xvrxvr/fpga-osc/interface.gen/sources_1/ip/axi4stream_vip_0/doc/axi4stream_vip_v1_1_changelog.txt

2023.2.2:
 * Version 1.1 (Rev. 16)
 * No changes

2023.2.1:
 * Version 1.1 (Rev. 16)
 * Revision change in one or more subcores

2023.2:
 * Version 1.1 (Rev. 15)
 * General: Updating AMD copyright
 * Revision change in one or more subcores

2023.1.2:
 * Version 1.1 (Rev. 14)
 * No changes

2023.1.1:
 * Version 1.1 (Rev. 14)
 * No changes

2023.1:
 * Version 1.1 (Rev. 14)
 * Revision change in one or more subcores

2022.2.2:
 * Version 1.1 (Rev. 13)
 * No changes

2022.2.1:
 * Version 1.1 (Rev. 13)
 * No changes

2022.2:
 * Version 1.1 (Rev. 13)
 * General: Diff_xml_file bug fixed
 * General: bug fixed
 * Revision change in one or more subcores

2022.1.2:
 * Version 1.1 (Rev. 12)
 * No changes

2022.1.1:
 * Version 1.1 (Rev. 12)
 * No changes

2022.1:
 * Version 1.1 (Rev. 12)
 * General: Diff_xml_file bug fixed
 * General: bug fixed
 * Revision change in one or more subcores

2021.2.2:
 * Version 1.1 (Rev. 11)
 * No changes

2021.2.1:
 * Version 1.1 (Rev. 11)
 * No changes

2021.2:
 * Version 1.1 (Rev. 11)
 * Revision change in one or more subcores

2021.1.1:
 * Version 1.1 (Rev. 10)
 * No changes

2021.1:
 * Version 1.1 (Rev. 10)
 * Revision change in one or more subcores

2020.3:
 * Version 1.1 (Rev. 9)
 * Revision change in one or more subcores

2020.2.2:
 * Version 1.1 (Rev. 8)
 * No changes

2020.2.1:
 * Version 1.1 (Rev. 8)
 * No changes

2020.2:
 * Version 1.1 (Rev. 8)
 * Revision change in one or more subcores

2020.1.1:
 * Version 1.1 (Rev. 7)
 * No changes

2020.1:
 * Version 1.1 (Rev. 7)
 * Revision change in one or more subcores

2019.2.2:
 * Version 1.1 (Rev. 6)
 * No changes

2019.2.1:
 * Version 1.1 (Rev. 6)
 * No changes

2019.2:
 * Version 1.1 (Rev. 6)
 * Revision change in one or more subcores

2019.1.3:
 * Version 1.1 (Rev. 5)
 * No changes

2019.1.2:
 * Version 1.1 (Rev. 5)
 * No changes

2019.1.1:
 * Version 1.1 (Rev. 5)
 * No changes

2019.1:
 * Version 1.1 (Rev. 5)
 * General: update to honor user parameters user strength in slave mode
 * Revision change in one or more subcores

2018.3.1:
 * Version 1.1 (Rev. 4)
 * No changes

2018.3:
 * Version 1.1 (Rev. 4)
 * General: update arm axi4s protocol checker for xsim
 * Revision change in one or more subcores

2018.2:
 * Version 1.1 (Rev. 3)
 * General: modify instance pkg generation so there is no mismatch between interface and virtual interface
 * Revision change in one or more subcores

2018.1:
 * Version 1.1 (Rev. 2)
 * General: update example testbench, update interface checker for tkeep
 * Revision change in one or more subcores

2017.4:
 * Version 1.1 (Rev. 1)
 * General: update interface assertion
 * Revision change in one or more subcores

2017.3:
 * Version 1.1
 * versionless of package, interface and PC
 * Revision change in one or more subcores

2017.2:
 * Version 1.0 (Rev. 1)
 * Sub core IP clk_wiz version changed to 5.4
 * production release
 * Revision change in one or more subcores

2017.1:
 * Version 1.0
 * Initial Release

(c) Copyright 2017 - 2024 Advanced Micro Devices, Inc. All rights reserved.

This file contains confidential and proprietary information
of AMD and is protected under U.S. and international copyright
and other intellectual property laws.

DISCLAIMER
This disclaimer is not a license and does not grant any
rights to the materials distributed herewith. Except as
otherwise provided in a valid license issued to you by
AMD, and to the maximum extent permitted by applicable
law: (1) THESE MATERIALS ARE MADE AVAILABLE "AS IS" AND
WITH ALL FAULTS, AND AMD HEREBY DISCLAIMS ALL WARRANTIES
AND CONDITIONS, EXPRESS, IMPLIED, OR STATUTORY, INCLUDING
BUT NOT LIMITED TO WARRANTIES OF MERCHANTABILITY, NON-
INFRINGEMENT, OR FITNESS FOR ANY PARTICULAR PURPOSE; and
(2) AMD shall not be liable (whether in contract or tort,
including negligence, or under any other theory of
liability) for any loss or damage of any kind or nature
related to, arising under or in connection with these
materials, including for any direct, or any indirect,
special, incidental, or consequential loss or damage
(including loss of data, profits, goodwill, or any type of
loss or damage suffered as a result of any action brought
by a third party) even if such damage or loss was
reasonably foreseeable or AMD had been advised of the
possibility of the same.

CRITICAL APPLICATIONS
AMD products are not designed or intended to be fail-
safe, or for use in any application requiring fail-safe
performance, such as life-support or safety devices or
systems, Class III medical devices, nuclear facilities,
applications related to the deployment of airbags, or any
other applications that could lead to death, personal
injury, or severe property or environmental damage
(individually and collectively, "Critical
Applications"). Customer assumes the sole risk and
liability of any use of AMD products in Critical
Applications, subject only to applicable laws and
regulations governing limitations on product liability.

THIS COPYRIGHT NOTICE AND DISCLAIMER MUST BE RETAINED AS
PART OF THIS FILE AT ALL TIMES.
