xvrxvr/fpga-osc/interface.gen/sources_1/ip/axis_interconnect_input/doc/axis_interconnect_v1_1_changelog.txt

2023.2.2:
 * Version 1.1 (Rev. 22)
 * No changes

2023.2.1:
 * Version 1.1 (Rev. 22)
 * No changes

2023.2:
 * Version 1.1 (Rev. 22)
 * General: Rebrand to AMD copyright information
 * Revision change in one or more subcores

2023.1.2:
 * Version 1.1 (Rev. 21)
 * No changes

2023.1.1:
 * Version 1.1 (Rev. 21)
 * No changes

2023.1:
 * Version 1.1 (Rev. 21)
 * Revision change in one or more subcores

2022.2.2:
 * Version 1.1 (Rev. 20)
 * No changes

2022.2.1:
 * Version 1.1 (Rev. 20)
 * No changes

2022.2:
 * Version 1.1 (Rev. 20)
 * No changes

2022.1.2:
 * Version 1.1 (Rev. 20)
 * No changes

2022.1.1:
 * Version 1.1 (Rev. 20)
 * No changes

2022.1:
 * Version 1.1 (Rev. 20)
 * Revision change in one or more subcores

2021.2.2:
 * Version 1.1 (Rev. 19)
 * No changes

2021.2.1:
 * Version 1.1 (Rev. 19)
 * No changes

2021.2:
 * Version 1.1 (Rev. 19)
 * Revision change in one or more subcores

2021.1.1:
 * Version 1.1 (Rev. 18)
 * No changes

2021.1:
 * Version 1.1 (Rev. 18)
 * No changes

2020.3:
 * Version 1.1 (Rev. 18)
 * No changes

2020.2.2:
 * Version 1.1 (Rev. 18)
 * No changes

2020.2.1:
 * Version 1.1 (Rev. 18)
 * No changes

2020.2:
 * Version 1.1 (Rev. 18)
 * No changes

2020.1.1:
 * Version 1.1 (Rev. 18)
 * No changes

2020.1:
 * Version 1.1 (Rev. 18)
 * No changes

2019.2.2:
 * Version 1.1 (Rev. 18)
 * No changes

2019.2.1:
 * Version 1.1 (Rev. 18)
 * No changes

2019.2:
 * Version 1.1 (Rev. 18)
 * Revision change in one or more subcores

2019.1.3:
 * Version 1.1 (Rev. 17)
 * No changes

2019.1.2:
 * Version 1.1 (Rev. 17)
 * No changes

2019.1.1:
 * Version 1.1 (Rev. 17)
 * No changes

2019.1:
 * Version 1.1 (Rev. 17)
 * General: remove support for versal
 * Revision change in one or more subcores

2018.3.1:
 * Version 1.1 (Rev. 16)
 * No changes

2018.3:
 * Version 1.1 (Rev. 16)
 * Revision change in one or more subcores

2018.2:
 * Version 1.1 (Rev. 15)
 * No changes

2018.1:
 * Version 1.1 (Rev. 15)
 * General: Updated to FIFO Generator v13.2.
 * Revision change in one or more subcores

2017.4:
 * Version 1.1 (Rev. 14)
 * No changes

2017.3:
 * Version 1.1 (Rev. 14)
 * No changes

2017.2:
 * Version 1.1 (Rev. 14)
 * No changes

2017.1:
 * Version 1.1 (Rev. 14)
 * Packaging updated. No user visible changes.
 * Revision change in one or more subcores

2016.4:
 * Version 1.1 (Rev. 13)
 * Revision change in one or more subcores

2016.3:
 * Version 1.1 (Rev. 12)
 * Source HDL files are concatenated into a single file to speed up synthesis and simulation. No changes required by the user
 * Revision change in one or more subcores

2016.2:
 * Version 1.1 (Rev. 11)
 * Revision change in one or more subcores

2016.1:
 * Version 1.1 (Rev. 10)
 * Changes to HDL library management to support Vivado IP simulation library

2015.4.2:
 * Version 1.1 (Rev. 9)
 * No changes

2015.4.1:
 * Version 1.1 (Rev. 9)
 * No changes

2015.4:
 * Version 1.1 (Rev. 9)
 * Revision change in one or more subcores

2015.3:
 * Version 1.1 (Rev. 8)
 * Update to use FIFO Generator v13.0
 * IP revision number added to HDL module, library, and include file names, to support designs with both locked and upgraded IP instances

2015.2.1:
 * Version 1.1 (Rev. 7)
 * No changes

2015.2:
 * Version 1.1 (Rev. 7)
 * Change in display name to distinguish between RTL and IPI versions,no functional changes

2015.1:
 * Version 1.1 (Rev. 6)
 * The support status for Kintex UltraScale is changed from Pre-Production to Production.

2014.4.1:
 * Version 1.1 (Rev. 5)
 * No changes

2014.4:
 * Version 1.1 (Rev. 5)
 * Architecture support updated.
 * Fixed typo in xpath expression for Mxx_SPARSE_TKEEP_REMOVED to evaluate correctly. In certain configurations, optional status port Mxx_SPARSE_TKEEP_REMOVED may be present.

2014.3:
 * Version 1.1 (Rev. 4)
 * No changes

2014.2:
 * Version 1.1 (Rev. 4)
 * Updated to utilize FIFO Generator v12.0 core.

2014.1:
 * Version 1.1 (Rev. 3)
 * Internal device family name change, no functional changes

2013.4:
 * Version 1.1 (Rev. 2)
 * No changes

2013.3:
 * Version 1.1 (Rev. 2)
 * Architecture support updated
 * GUI: Remove blank rows in columns for Slave Interface and Master Interface tables.
 * GUI: TDEST range updated to match validation.  TDEST Width minimum width must be large enough to allow access all master interfaces.
 * Updated clock synchronizers to improve Mean Time Between Failures (MTBF) for metastability. Added parameter SYNCHRONIZATION_STAGE to specify clock synchronizer stages.

2013.2:
 * Version 1.1 (Rev. 1)
 * Architecture support updated
 * Known issue: The AXI4-Stream signals shown in Table 2-7 of PG035 have the port directions reversed.
 * Constraints processing order changed

2013.1:
 * Version 1.1
 * Native Vivado Release
 * There have been no functional or interface changes to this IP.  The version number has changed to support unique versioning in Vivado starting with 2013.1.

(c) Copyright 2012 - 2024 Advanced Micro Devices, Inc. All rights reserved.

This file contains confidential and proprietary information
of AMD and is protected under U.S. and international copyright
and other intellectual property laws.

DISCLAIMER
This disclaimer is not a license and does not grant any
rights to the materials distributed herewith. Except as
otherwise provided in a valid license issued to you by
AMD, and to the maximum extent permitted by applicable
law: (1) THESE MATERIALS ARE MADE AVAILABLE "AS IS" AND
WITH ALL FAULTS, AND AMD HEREBY DISCLAIMS ALL WARRANTIES
AND CONDITIONS, EXPRESS, IMPLIED, OR STATUTORY, INCLUDING
BUT NOT LIMITED TO WARRANTIES OF MERCHANTABILITY, NON-
INFRINGEMENT, OR FITNESS FOR ANY PARTICULAR PURPOSE; and
(2) AMD shall not be liable (whether in contract or tort,
including negligence, or under any other theory of
liability) for any loss or damage of any kind or nature
related to, arising under or in connection with these
materials, including for any direct, or any indirect,
special, incidental, or consequential loss or damage
(including loss of data, profits, goodwill, or any type of
loss or damage suffered as a result of any action brought
by a third party) even if such damage or loss was
reasonably foreseeable or AMD had been advised of the
possibility of the same.

CRITICAL APPLICATIONS
AMD products are not designed or intended to be fail-
safe, or for use in any application requiring fail-safe
performance, such as life-support or safety devices or
systems, Class III medical devices, nuclear facilities,
applications related to the deployment of airbags, or any
other applications that could lead to death, personal
injury, or severe property or environmental damage
(individually and collectively, "Critical
Applications"). Customer assumes the sole risk and
liability of any use of AMD products in Critical
Applications, subject only to applicable laws and
regulations governing limitations on product liability.

THIS COPYRIGHT NOTICE AND DISCLAIMER MUST BE RETAINED AS
PART OF THIS FILE AT ALL TIMES.
