xvrxvr/fpga-osc/docs/osc.pdf

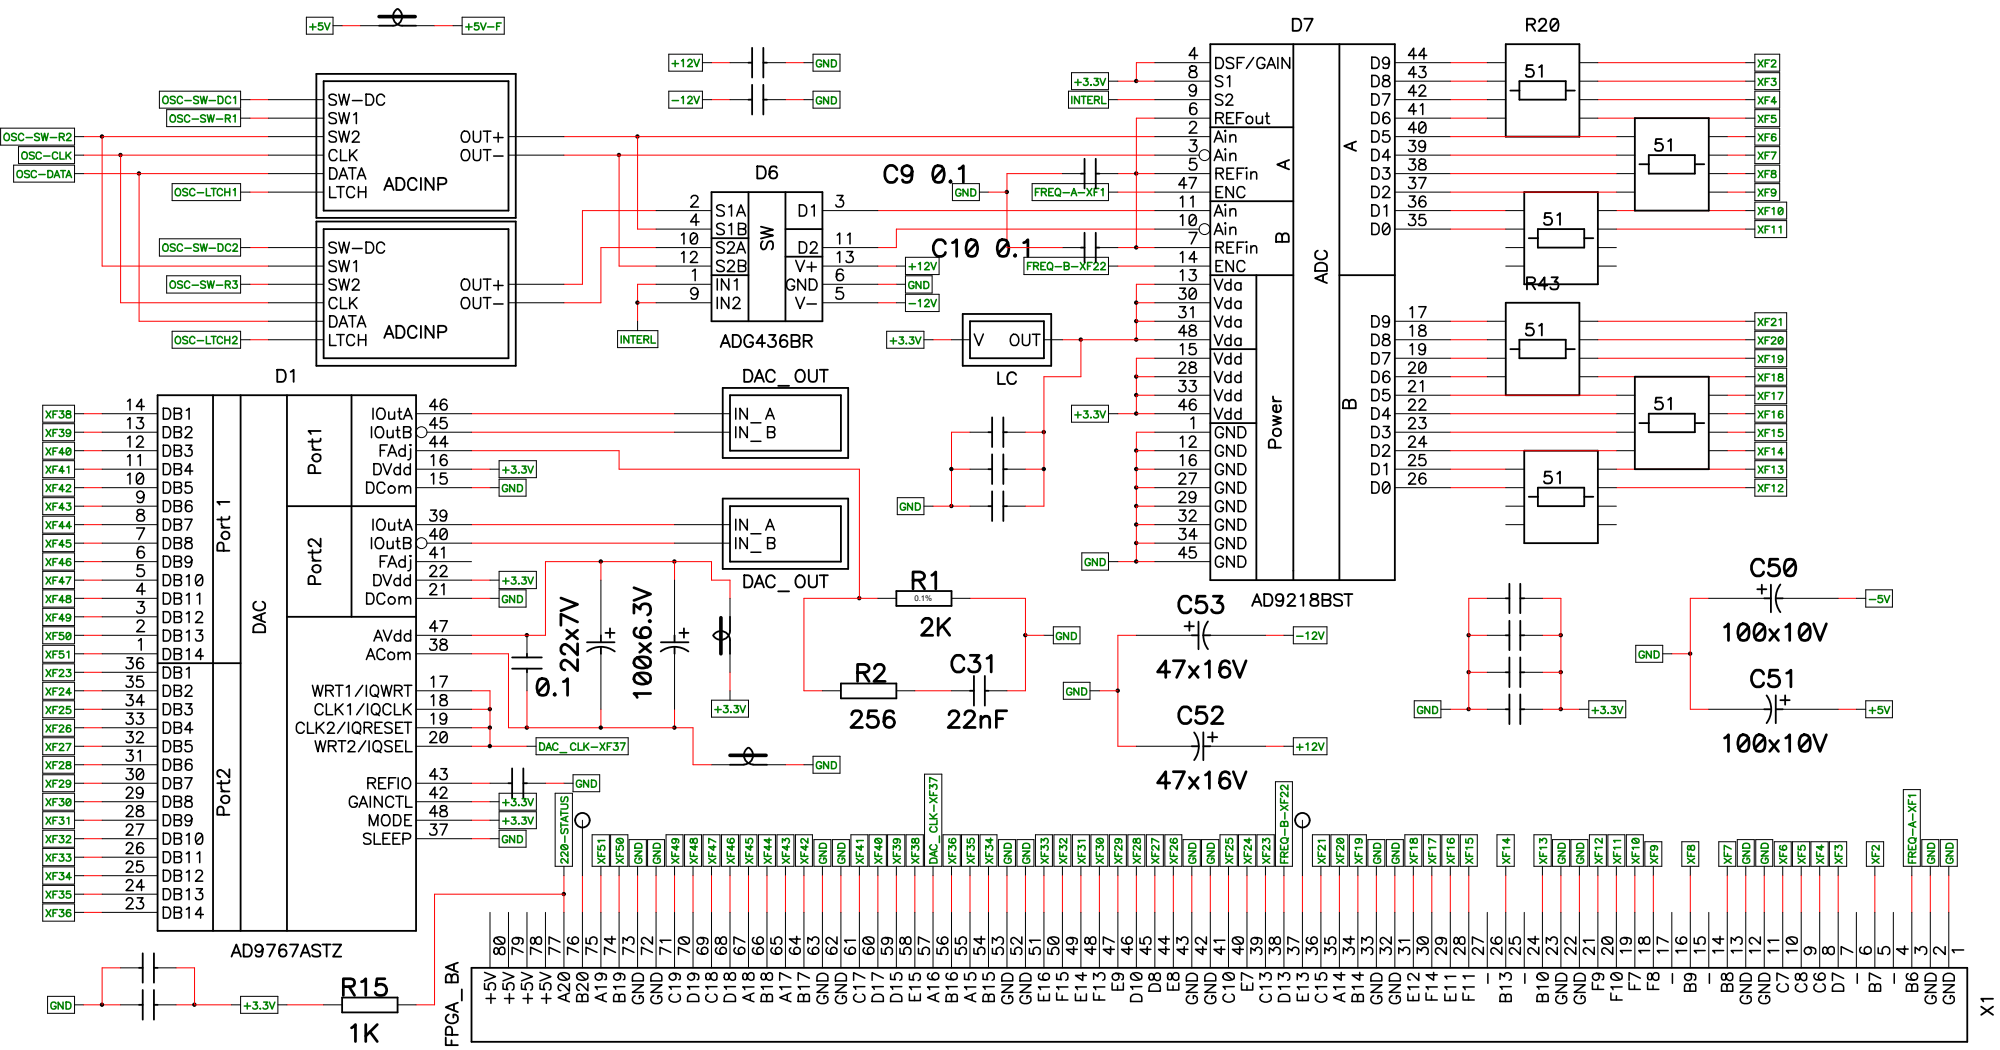
[picture p5: page 1]

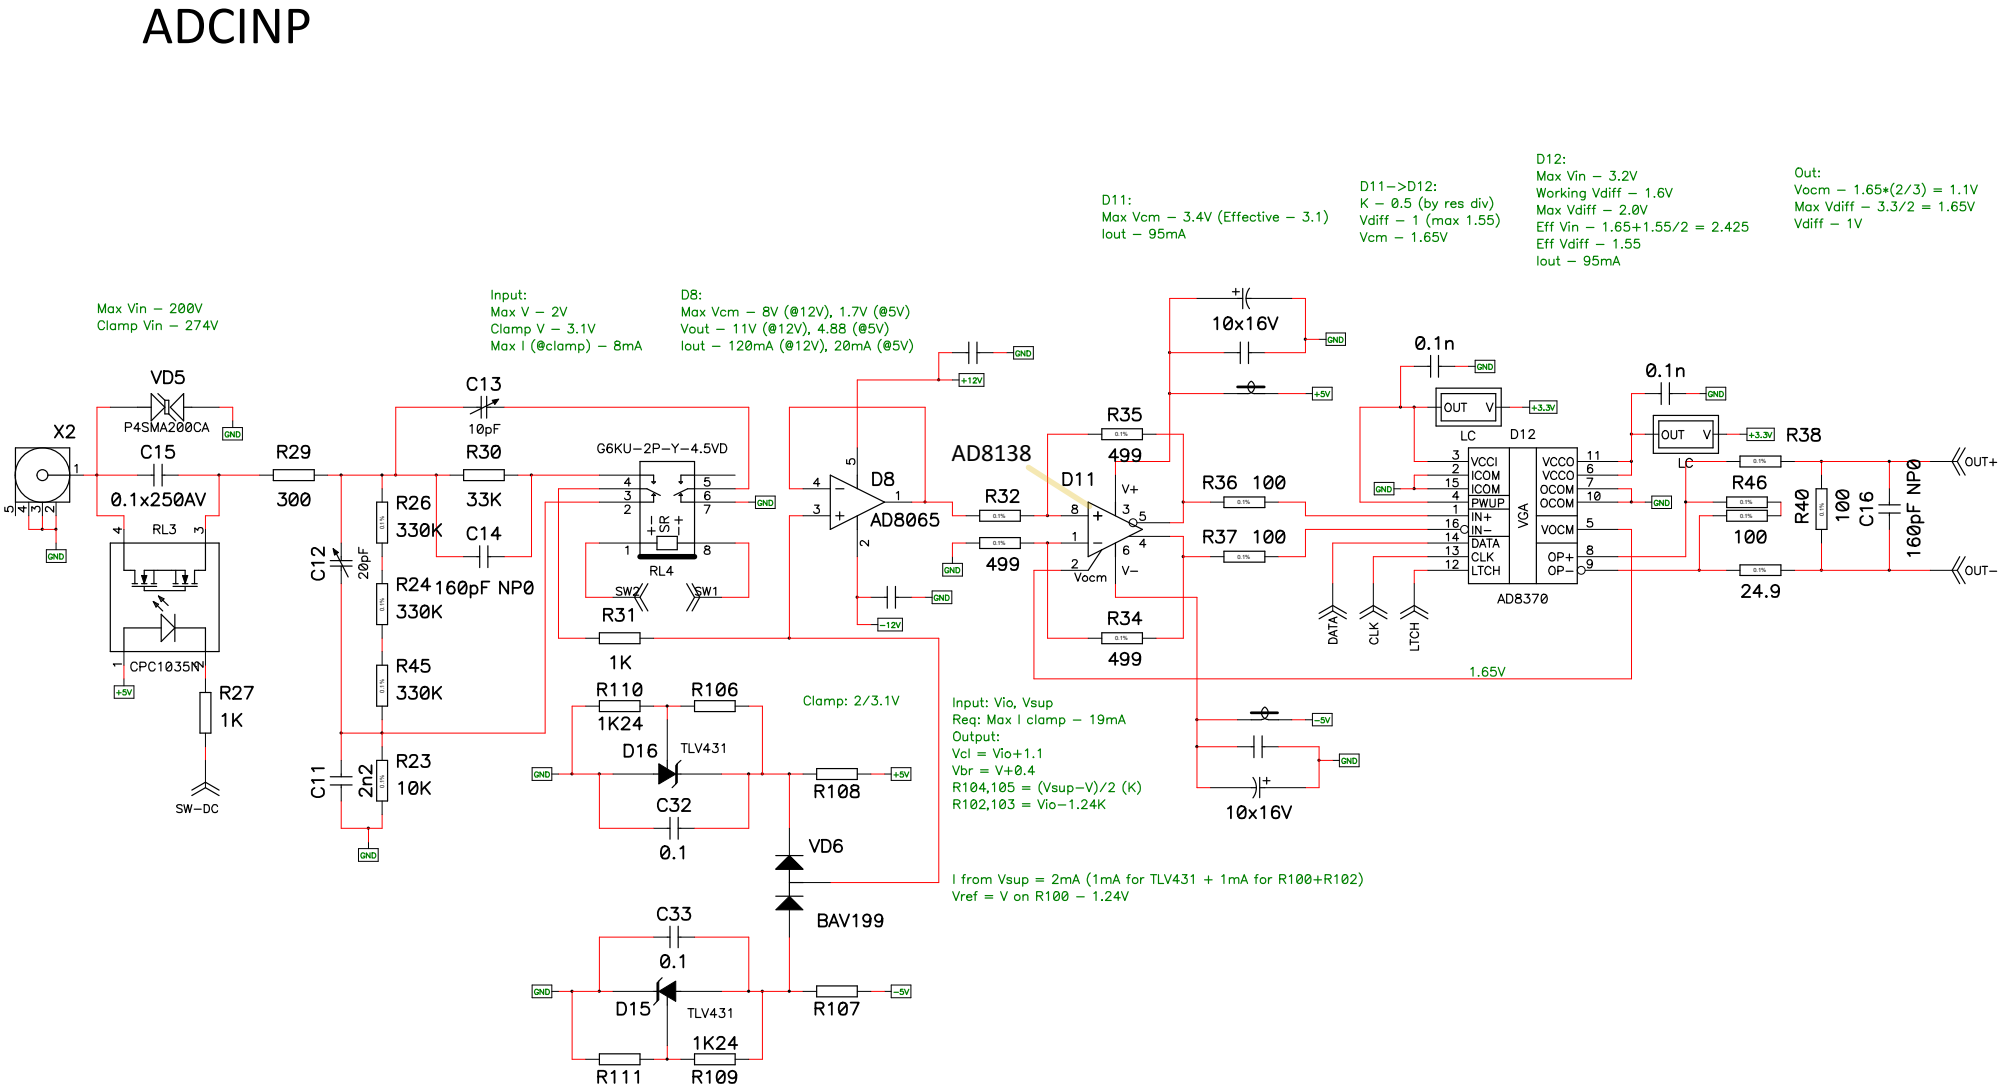
[picture p6: page 2]
ADCINP

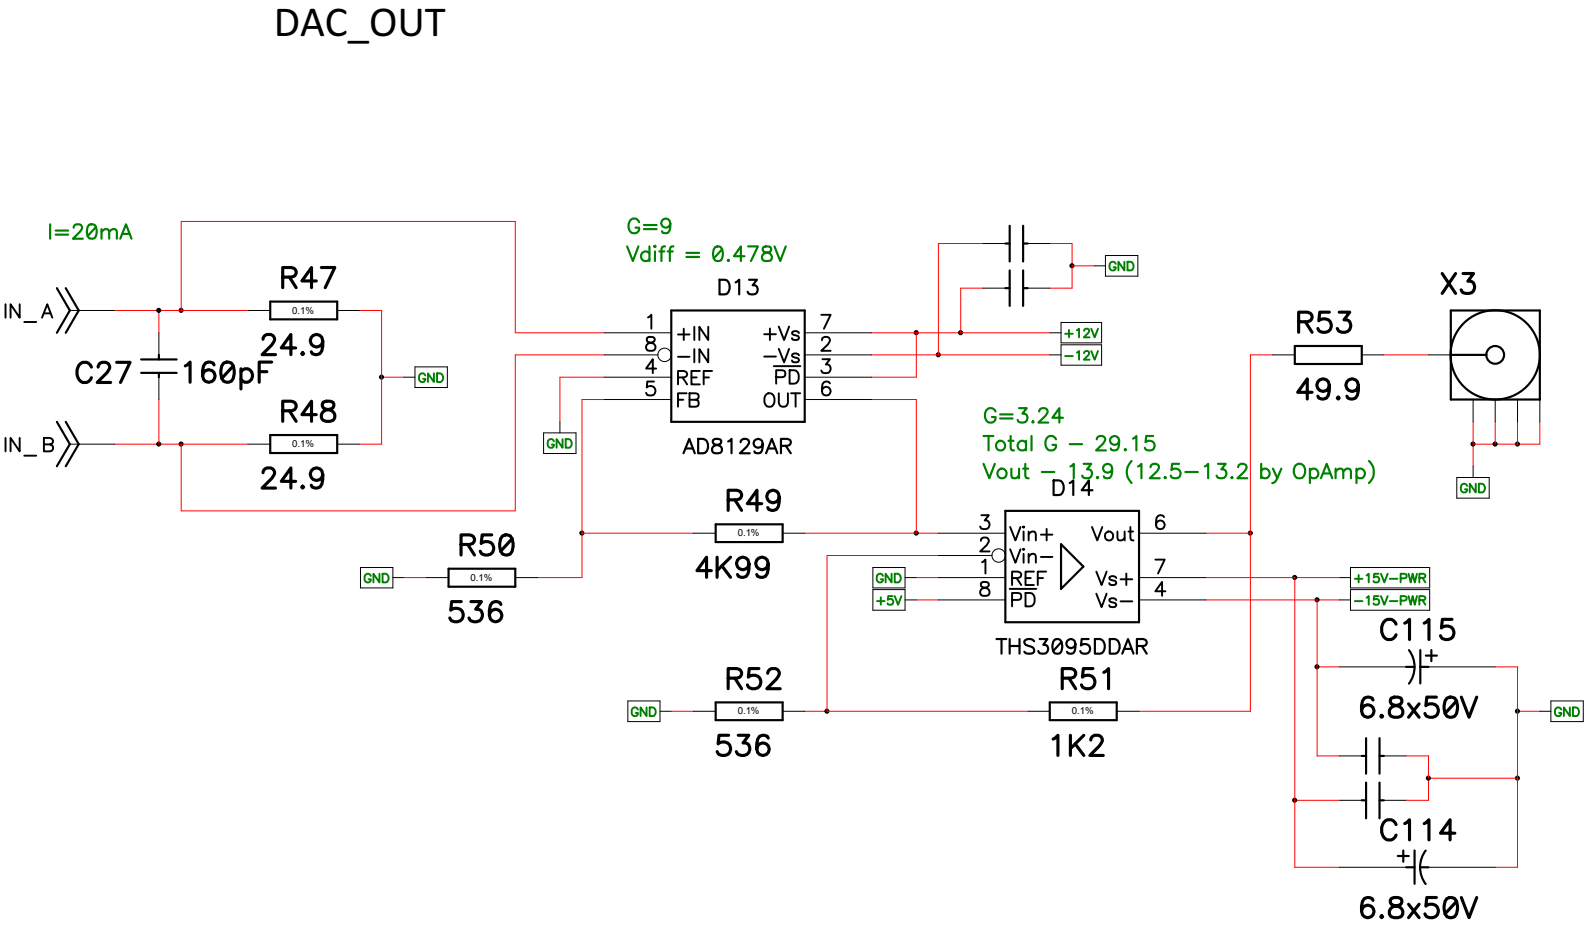
[picture p7: page 3]
DAC_OUT

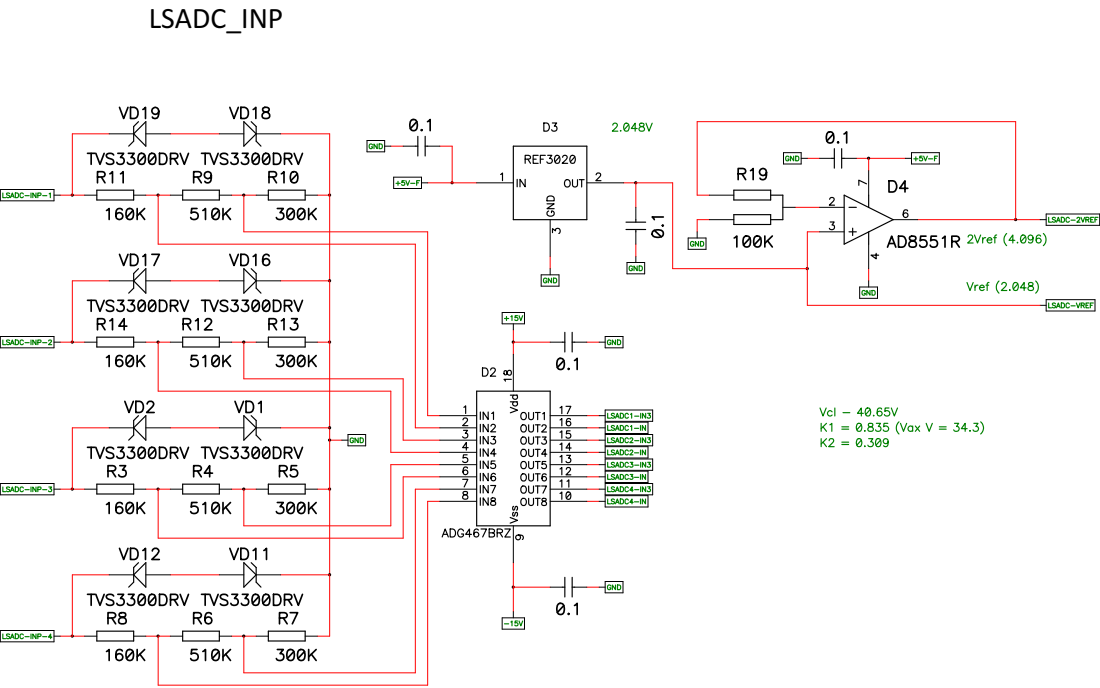
[picture p8: page 4]
LSADC_INP

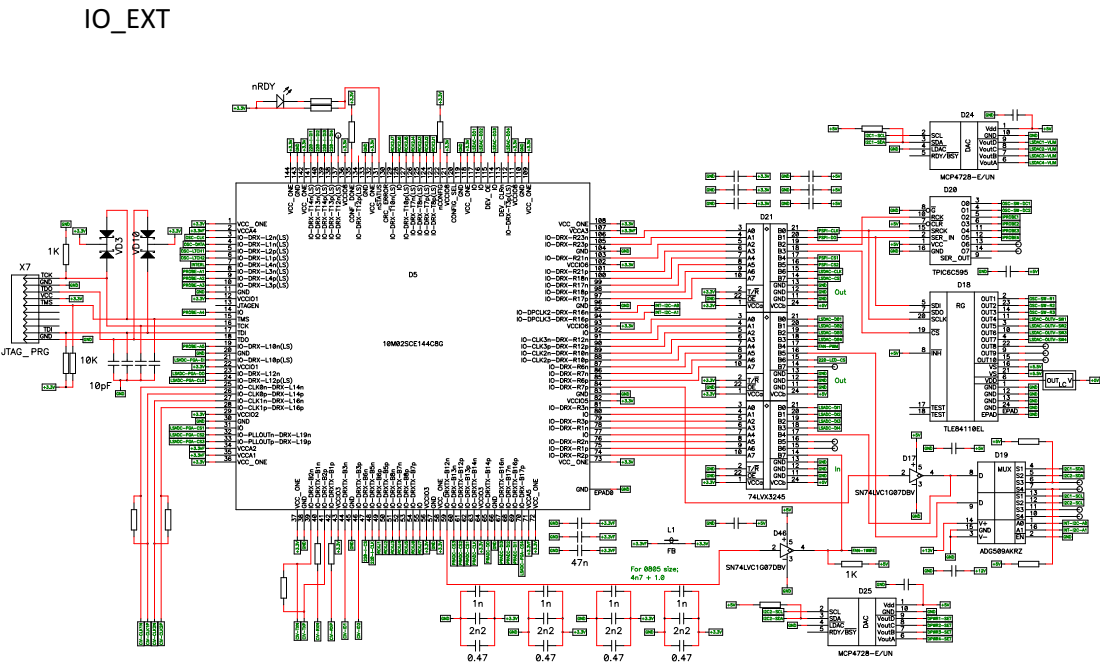
[picture p9: page 5]
IO_EXT

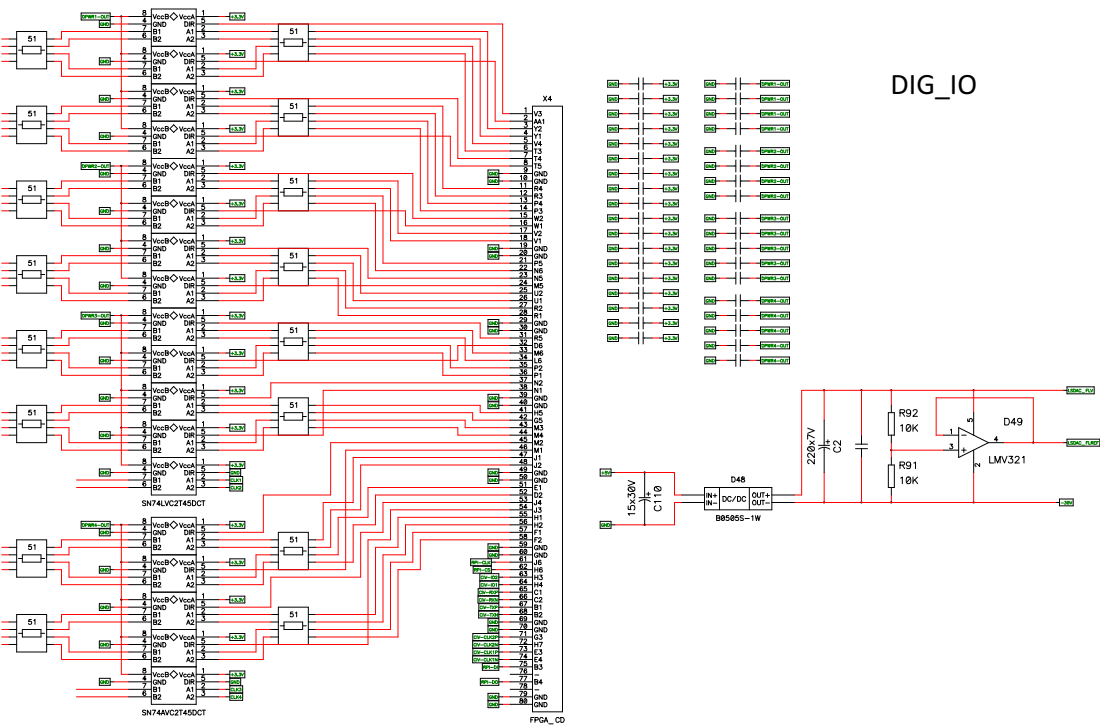
[picture p10: page 6]
DIG_IO

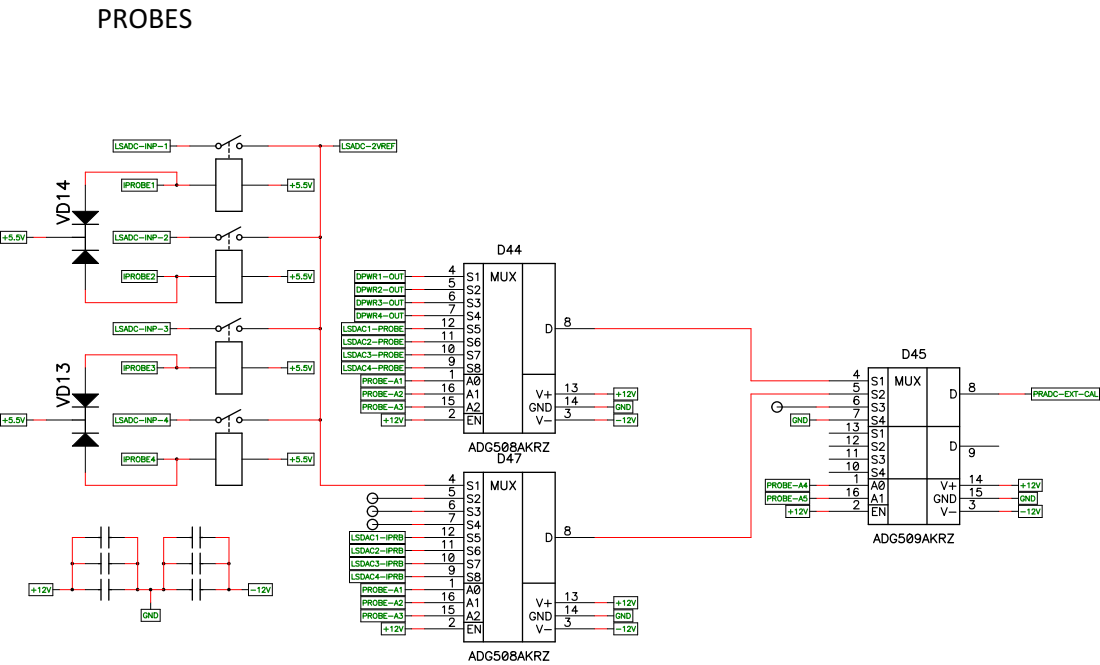
[picture p11: page 7]
PROBES

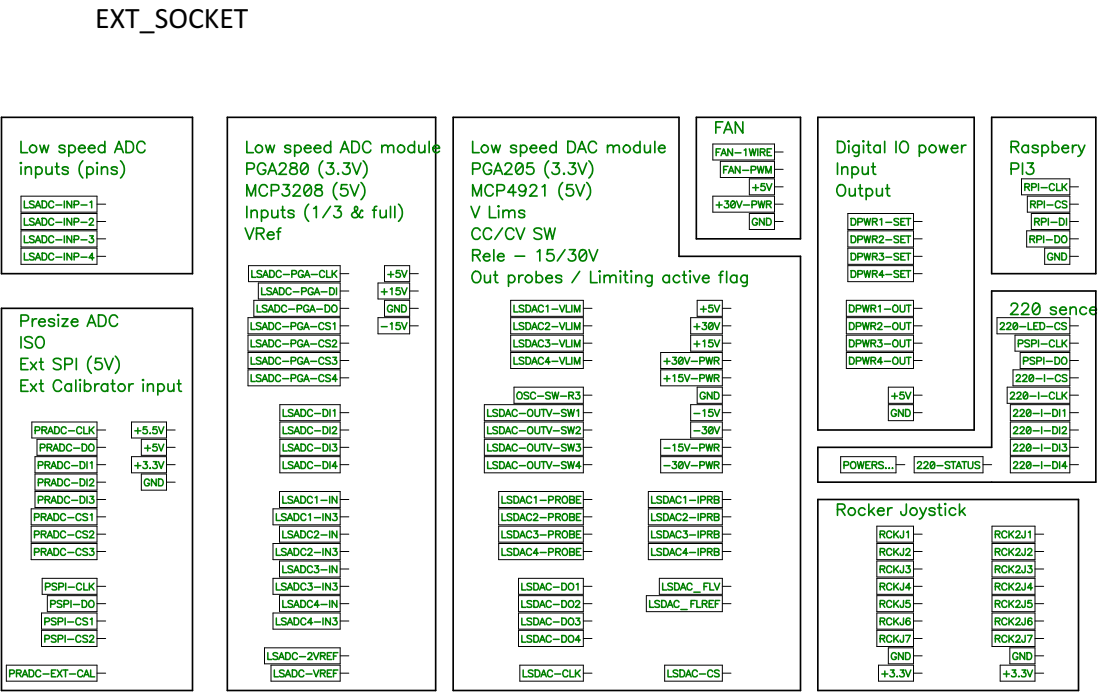
[picture p12: page 8]
EXT_SOCKET

LC

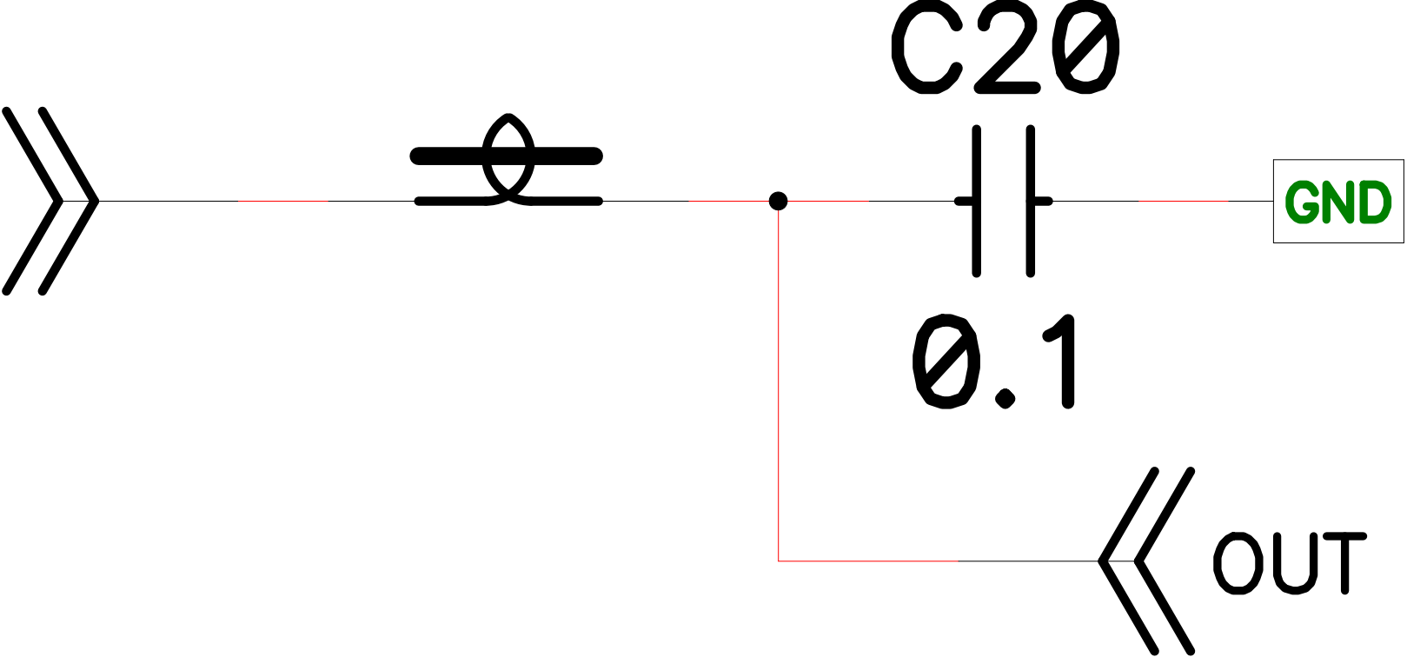
[picture p13: figure]
