xvrxvr/fpga-osc/docs/triger-doc.pdf

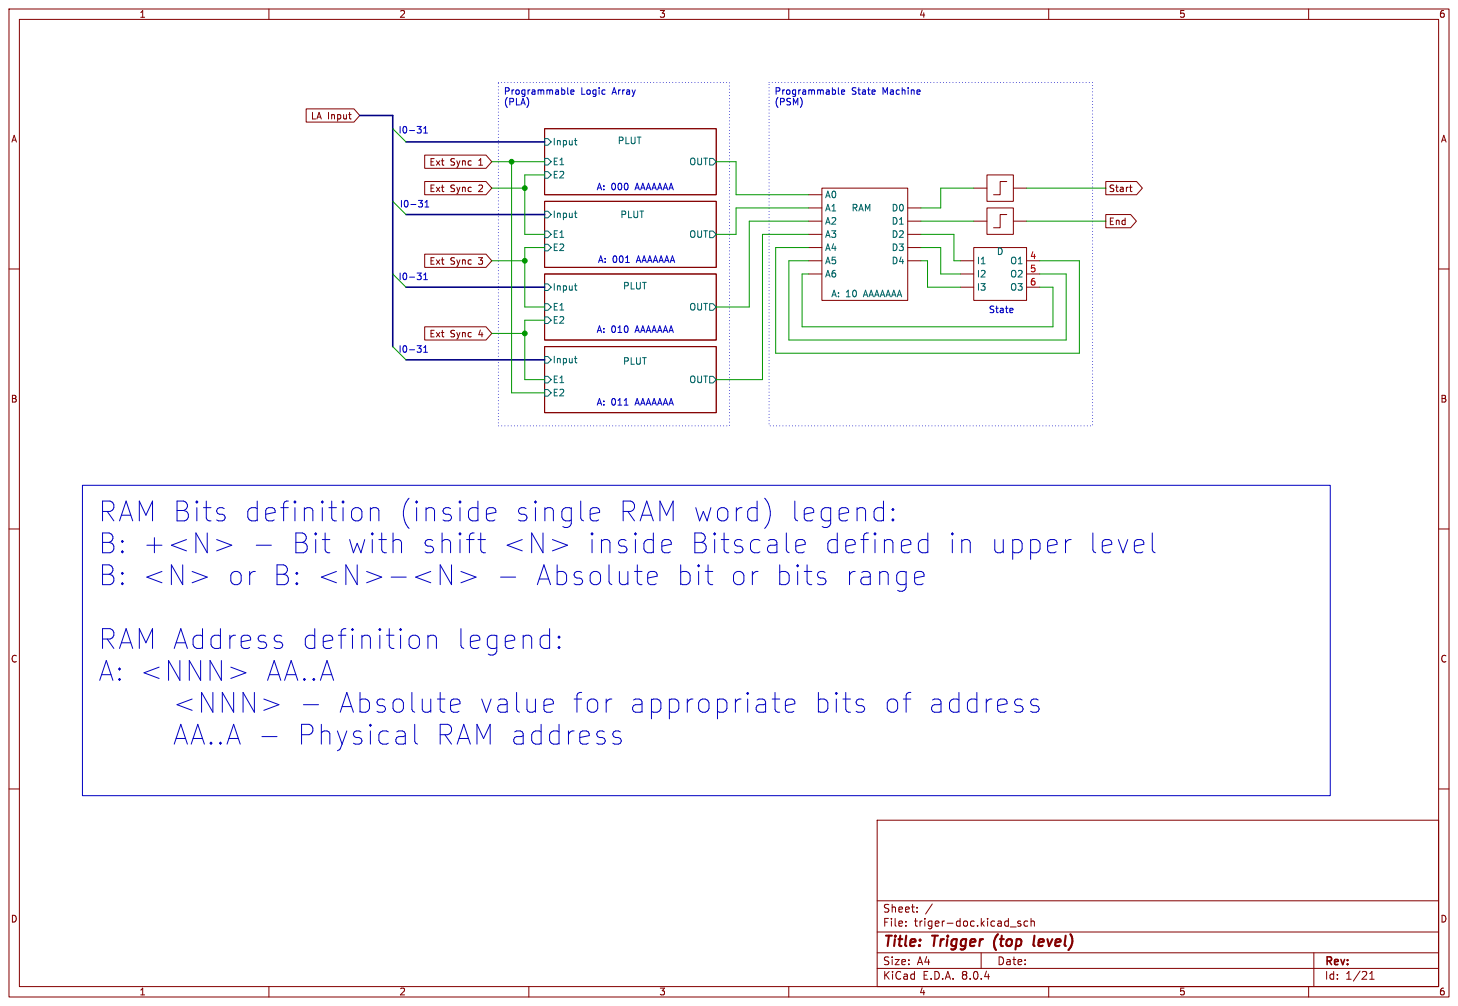
[picture p14: page 1]

Id: 1/21 Title: Trigger (top level) File: triger-doc.kicad_sch Sheet: /

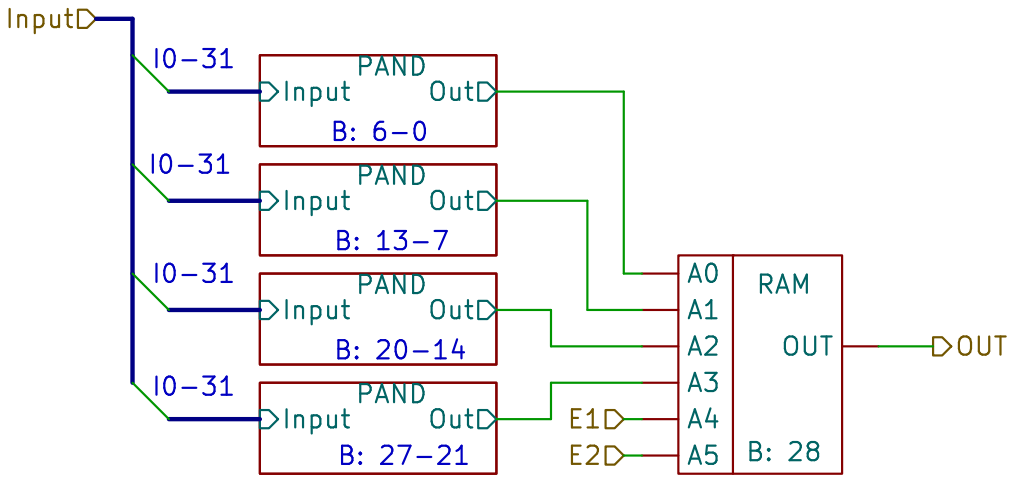
[picture p15: page 2]

File: pla.kicad_sch Sheet: /PLUT/
Id: 2/21 Title: PLUT

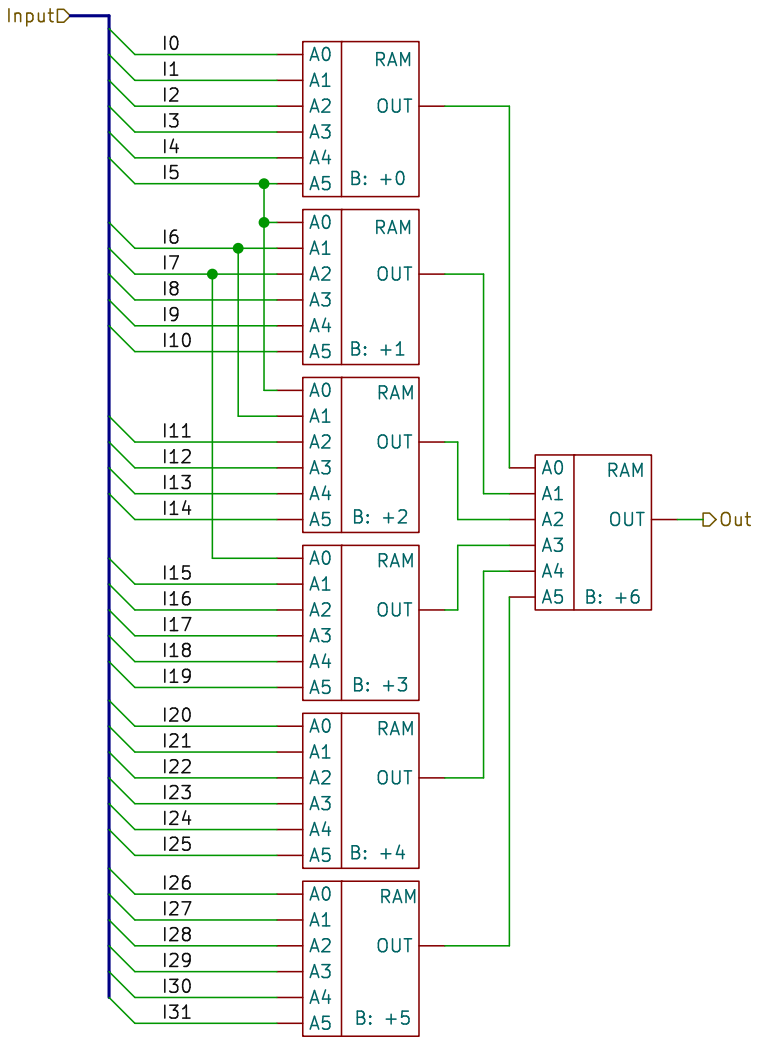
[picture p16: page 3]

File: pla.kicad_sch Sheet: /PLUT/
Id: 8/21 Title: PLUT

File: pla.kicad_sch Sheet: /PLUT/
Id: 13/21 Title: PLUT

File: pla.kicad_sch Sheet: /PLUT/
Id: 18/21 Title: PLUT
