xvrxvr/fpga-osc/interface.gen/sources_1/ip/clk_wiz_main/clk_wiz_main_stub.v

// Copyright 1986-2022 Xilinx, Inc. All Rights Reserved.
// Copyright 2022-2024 Advanced Micro Devices, Inc. All Rights Reserved.
// --------------------------------------------------------------------------------
// Tool Version: Vivado v.2023.2.2 (win64) Build 4126759 Thu Feb  8 23:53:51 MST 2024
// Date        : Tue Mar 12 11:36:25 2024
// Host        : DESKTOP-JRU94P5 running 64-bit major release  (build 9200)
// Command     : write_verilog -force -mode synth_stub
//               w:/home/roman/FPGA-HAT/fw/interface/interface.gen/sources_1/ip/clk_wiz_main/clk_wiz_main_stub.v
// Design      : clk_wiz_main
// Purpose     : Stub declaration of top-level module interface
// Device      : xc7s6ftgb196-1
// --------------------------------------------------------------------------------

// This empty module with port declaration file causes synthesis tools to infer a black box for IP.
// The synthesis directives are for Synopsys Synplify support to prevent IO buffer insertion.
// Please paste the declaration into a Verilog source file or add the file as an additional source.
module clk_wiz_main(clk_out1, clk_in1)
/* synthesis syn_black_box black_box_pad_pin="clk_in1" */
/* synthesis syn_force_seq_prim="clk_out1" */;
  output clk_out1 /* synthesis syn_isclock = 1 */;
  input clk_in1;
endmodule
