xvrxvr/fpga-osc/interface.gen/sources_1/ip/axis_interconnect_input/hdl/axis_interconnect_v1_1_vl_rfs.v

// (c) Copyright 2011-2012, 2023 Advanced Micro Devices, Inc. All rights reserved.
//
// This file contains confidential and proprietary information
// of AMD and is protected under U.S. and international copyright
// and other intellectual property laws.
//
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
// CRITICAL APPLICATIONS
// AMD products are not designed or intended to be fail-
// safe, or for use in any application requiring fail-safe
// performance, such as life-support or safety devices or
// systems, Class III medical devices, nuclear facilities,
// applications related to the deployment of airbags, or any
// other applications that could lead to death, personal
// injury, or severe property or environmental damage
// (individually and collectively, "Critical
// Applications"). Customer assumes the sole risk and
// liability of any use of AMD products in Critical
// Applications, subject only to applicable laws and
// regulations governing limitations on product liability.
//
// THIS COPYRIGHT NOTICE AND DISCLAIMER MUST BE RETAINED AS
// PART OF THIS FILE AT ALL TIMES.
////////////////////////////////////////////////////////////
//
// Register Slice
//   Generic single-channel AXI pipeline register on forward and/or reverse signal path
//
// Verilog-standard:  Verilog 2001
//--------------------------------------------------------------------------
//
// Structure:
//   axic_sync_clock_converter
//
//--------------------------------------------------------------------------

`timescale 1ps/1ps
`default_nettype none

module axis_interconnect_v1_1_22_axisc_sync_clock_converter # (
///////////////////////////////////////////////////////////////////////////////
// Parameter Definitions
///////////////////////////////////////////////////////////////////////////////
  parameter C_FAMILY     = "virtex6",
  parameter integer C_PAYLOAD_WIDTH = 32,
  parameter integer C_S_ACLK_RATIO = 1,
  parameter integer C_M_ACLK_RATIO = 1,
  parameter integer C_MODE = 1  // 0 = light-weight (1-deep); 1 = fully-pipelined (2-deep)
  )
 (
///////////////////////////////////////////////////////////////////////////////
// Port Declarations
///////////////////////////////////////////////////////////////////////////////
  input wire                         SAMPLE_CYCLE_EARLY,
  input wire                         SAMPLE_CYCLE,
  // Slave side
  input  wire                        S_ACLK,
  input  wire                        S_ARESETN,
  input  wire [C_PAYLOAD_WIDTH-1:0]  S_PAYLOAD,
  input  wire                        S_VALID,
  output wire                        S_READY,

  // Master side
  input  wire                        M_ACLK,
  input  wire                        M_ARESETN,
  output wire [C_PAYLOAD_WIDTH-1:0]  M_PAYLOAD,
  output wire                        M_VALID,
  input  wire                        M_READY
);

////////////////////////////////////////////////////////////////////////////////
// Functions
////////////////////////////////////////////////////////////////////////////////

////////////////////////////////////////////////////////////////////////////////
// Local parameters
////////////////////////////////////////////////////////////////////////////////
localparam [1:0] ZERO = 2'b10;
localparam [1:0] ONE  = 2'b11;
localparam [1:0] FULL = 2'b01;
localparam [1:0] INIT = 2'b00;
localparam integer P_LIGHT_WT = 0;
localparam integer P_FULLY_REG = 1;

////////////////////////////////////////////////////////////////////////////////
// Wires/Reg declarations
////////////////////////////////////////////////////////////////////////////////

////////////////////////////////////////////////////////////////////////////////
// BEGIN RTL
////////////////////////////////////////////////////////////////////////////////

generate
  if (C_S_ACLK_RATIO == C_M_ACLK_RATIO) begin : gen_passthru
    assign M_PAYLOAD = S_PAYLOAD;
    assign M_VALID   = S_VALID;
    assign S_READY   = M_READY;      
  end else begin : gen_sync_clock_converter
    wire s_sample_cycle;
    wire s_sample_cycle_early;
    wire m_sample_cycle;
    wire m_sample_cycle_early;

    wire slow_aclk;
    wire slow_areset;
    reg  s_areset_r;
    reg  m_areset_r;
   
    reg  s_ready_r; 
    wire s_ready_ns; 
    reg  m_valid_r; 
    wire m_valid_ns; 
    reg  [C_PAYLOAD_WIDTH-1:0] m_payload_r;
    reg  [C_PAYLOAD_WIDTH-1:0] m_storage_r;
    wire [C_PAYLOAD_WIDTH-1:0] m_payload_ns; 
    wire [C_PAYLOAD_WIDTH-1:0] m_storage_ns; 
    reg  m_ready_hold;
    wire m_ready_sample;
    wire load_payload;
    wire load_storage;
    wire load_payload_from_storage;
    reg [1:0] state;
    reg [1:0] next_state;
    
    always @(posedge S_ACLK) begin
      s_areset_r <= ~(S_ARESETN & M_ARESETN);
    end
  
    always @(posedge M_ACLK) begin
      m_areset_r <= ~(S_ARESETN & M_ARESETN);
    end

    assign slow_aclk   = (C_S_ACLK_RATIO > C_M_ACLK_RATIO) ? M_ACLK   : S_ACLK;
    assign slow_areset = (C_S_ACLK_RATIO > C_M_ACLK_RATIO) ? m_areset_r : s_areset_r;
    assign s_sample_cycle_early = (C_S_ACLK_RATIO > C_M_ACLK_RATIO) ? SAMPLE_CYCLE_EARLY : 1'b1;
    assign s_sample_cycle       = (C_S_ACLK_RATIO > C_M_ACLK_RATIO) ? SAMPLE_CYCLE : 1'b1;
    assign m_sample_cycle_early = (C_S_ACLK_RATIO > C_M_ACLK_RATIO) ? 1'b1 : SAMPLE_CYCLE_EARLY;
    assign m_sample_cycle       = (C_S_ACLK_RATIO > C_M_ACLK_RATIO) ? 1'b1 : SAMPLE_CYCLE;

    // Output flop for S_READY, value is encoded into state machine.
    assign s_ready_ns = (C_S_ACLK_RATIO > C_M_ACLK_RATIO) ? state[1] & (state != INIT) : next_state[1];

    always @(posedge S_ACLK) begin 
      if (s_areset_r) begin
        s_ready_r <= 1'b0;
      end
      else begin
        s_ready_r <= s_sample_cycle_early ? s_ready_ns : 1'b0;
      end
    end

    assign S_READY = s_ready_r;

    // Output flop for M_VALID
    assign m_valid_ns = next_state[0];

    always @(posedge M_ACLK) begin 
      if (m_areset_r) begin
        m_valid_r <= 1'b0;
      end
      else begin
        m_valid_r <= m_sample_cycle ? m_valid_ns : m_valid_r & ~M_READY;
      end
    end

    assign M_VALID = m_valid_r;

    // Hold register for M_READY when M_ACLK is fast.
    always @(posedge M_ACLK) begin 
      if (m_areset_r) begin
        m_ready_hold <= 1'b0;
      end
      else begin
        m_ready_hold <= m_sample_cycle ? 1'b0 : m_ready_sample;
      end
    end

    assign m_ready_sample = (M_READY ) | m_ready_hold;
    // Output/storage flops for PAYLOAD
    assign m_payload_ns = ~load_payload ? m_payload_r :
                           load_payload_from_storage ? m_storage_r : 
                           S_PAYLOAD;

    assign m_storage_ns = (C_MODE == P_FULLY_REG) ? (load_storage ? S_PAYLOAD : m_storage_r) : {C_PAYLOAD_WIDTH{1'b0}};

    always @(posedge slow_aclk) begin 
      m_payload_r <= m_payload_ns;
      m_storage_r <= (C_MODE == P_FULLY_REG) ? m_storage_ns : 0;
    end

    assign M_PAYLOAD = m_payload_r;

    // load logic
    assign load_storage = (C_MODE == P_FULLY_REG) && (state != FULL);
    assign load_payload = m_ready_sample || (state == ZERO);
    assign load_payload_from_storage = (C_MODE == P_FULLY_REG) && (state == FULL) && m_ready_sample;
    
    // State machine
    always @(posedge slow_aclk) begin 
      state <= next_state;
    end

    always @* begin 
      if (slow_areset) begin 
        next_state = INIT;
      end else begin
        case (state)
          INIT: begin
            next_state = ZERO;
          end
          // No transaction stored locally
          ZERO: begin
            if (S_VALID) begin
              next_state = (C_MODE == P_FULLY_REG) ? ONE : FULL; // Push from empty
            end
            else begin
              next_state = ZERO;
            end
          end

          // One transaction stored locally
          ONE: begin
            if (m_ready_sample & ~S_VALID) begin 
              next_state = ZERO; // Read out one so move to ZERO
            end
            else if (~m_ready_sample & S_VALID) begin
              next_state = FULL;  // Got another one so move to FULL
            end
            else begin
              next_state = ONE;
            end
          end

          // Storage registers full
          FULL: begin 
            if (m_ready_sample) begin
              next_state = (C_MODE == P_FULLY_REG) ? ONE : ZERO; // Pop from full
            end
            else begin
              next_state = FULL;
            end
          end
        endcase // case (state)
      end
    end
  end // gen_sync_clock_converter
  endgenerate
endmodule // axisc_sync_clock_converter

`default_nettype wire


// (c) Copyright 2011-2012, 2023 Advanced Micro Devices, Inc. All rights reserved.
//
// This file contains confidential and proprietary information
// of AMD and is protected under U.S. and international copyright
// and other intellectual property laws.
//
// DISCLAIMER
// This disclaimer is not a license and does not grant any
// rights to the materials distributed herewith. Except as
// otherwise provided in a valid license issued to you by
// AMD, and to the maximum extent permitted by applicable
// law: (1) THESE MATERIALS ARE MADE AVAILABLE "AS IS" AND
// WITH ALL FAULTS, AND AMD HEREBY DISCLAIMS ALL WARRANTIES
// AND CONDITIONS, EXPRESS, IMPLIED, OR STATUTORY, INCLUDING
// BUT NOT LIMITED TO WARRANTIES OF MERCHANTABILITY, NON-
// INFRINGEMENT, OR FITNESS FOR ANY PARTICULAR PURPOSE; and
// (2) AMD shall not be liable (whether in contract or tort,
// including negligence, or under any other theory of
// liability) for any loss or damage of any kind or nature
// related to, arising under or in connection with these
// materials, including for any direct, or any indirect,
// special, incidental, or consequential loss or damage
// (including loss of data, profits, goodwill, or any type of
// loss or damage suffered as a result of any action brought
// by a third party) even if such damage or loss was
// reasonably foreseeable or AMD had been advised of the
// possibility of the same.
//
// CRITICAL APPLICATIONS
// AMD products are not designed or intended to be fail-
// safe, or for use in any application requiring fail-safe
// performance, such as life-support or safety devices or
// systems, Class III medical devices, nuclear facilities,
// applications related to the deployment of airbags, or any
// other applications that could lead to death, personal
// injury, or severe property or environmental damage
// (individually and collectively, "Critical
// Applications"). Customer assumes the sole risk and
// liability of any use of AMD products in Critical
// Applications, subject only to applicable laws and
// regulations governing limitations on product liability.
//
// THIS COPYRIGHT NOTICE AND DISCLAIMER MUST BE RETAINED AS
// PART OF THIS FILE AT ALL TIMES.
////////////////////////////////////////////////////////////
//
// Register Slice
//   Generic single-channel AXI pipeline register on forward and/or reverse signal path
//
// Verilog-standard:  Verilog 2001
//--------------------------------------------------------------------------
//
// Structure:
//   axic_register_slice
//
//--------------------------------------------------------------------------

`timescale 1ps/1ps
`default_nettype none

module axis_interconnect_v1_1_22_axisc_sample_cycle_ratio # (
///////////////////////////////////////////////////////////////////////////////
// Parameter Definitions
///////////////////////////////////////////////////////////////////////////////
  parameter C_RATIO = 2 // Must be > 0
  )
 (
///////////////////////////////////////////////////////////////////////////////
// Port Declarations
///////////////////////////////////////////////////////////////////////////////
  input  wire                    SLOW_ACLK,
  input  wire                    FAST_ACLK,

  output wire                    SAMPLE_CYCLE_EARLY,
  output wire                    SAMPLE_CYCLE
);

////////////////////////////////////////////////////////////////////////////////
// Functions
////////////////////////////////////////////////////////////////////////////////
////////////////////////////////////////////////////////////////////////////////
// Local parameters
////////////////////////////////////////////////////////////////////////////////
localparam P_DELAY = C_RATIO > 2 ? C_RATIO-1 : C_RATIO-1; 
////////////////////////////////////////////////////////////////////////////////
// Wires/Reg declarations
////////////////////////////////////////////////////////////////////////////////
reg                slow_aclk_div2 = 0;
reg                posedge_finder_first;
reg                posedge_finder_second;
wire               first_edge;
wire               second_edge;
reg  [P_DELAY-1:0] sample_cycle_d;
(* shreg_extract = "no" *) reg                sample_cycle_r;


////////////////////////////////////////////////////////////////////////////////
// BEGIN RTL
////////////////////////////////////////////////////////////////////////////////
generate
  if (C_RATIO == 1) begin : gen_always_sample
    assign SAMPLE_CYCLE_EARLY = 1'b1;
    assign SAMPLE_CYCLE = 1'b1;
  end
  else begin : gen_sample_cycle
    genvar i;
    always @(posedge SLOW_ACLK) begin 
      slow_aclk_div2 <= ~slow_aclk_div2;
    end

    // Find matching rising edges by clocking slow_aclk_div2 onto faster clock
    always @(posedge FAST_ACLK) begin 
      posedge_finder_first <= slow_aclk_div2;
    end
    always @(posedge FAST_ACLK) begin 
      posedge_finder_second <= ~slow_aclk_div2;
    end

    assign first_edge = slow_aclk_div2 & ~posedge_finder_first;
    assign second_edge = ~slow_aclk_div2 & ~posedge_finder_second;

    always @(*) begin 
      sample_cycle_d[P_DELAY-1] = first_edge | second_edge;
    end
   
    // delay the posedge alignment by C_RATIO - 1 to set the sample cycle as
    // the clock one cycle before the posedge.
    for (i = P_DELAY-1; i > 0; i = i - 1) begin : gen_delay
      always @(posedge FAST_ACLK) begin
        sample_cycle_d[i-1] <= sample_cycle_d[i];
      end
    end

    always @(posedge FAST_ACLK) begin 
      sample_cycle_r <= sample_cycle_d[0];
    end
    assign SAMPLE_CYCLE_EARLY = sample_cycle_d[0];
    assign SAMPLE_CYCLE = sample_cycle_r;
  end
endgenerate

endmodule // axisc_sample_cycle_ratio

`default_nettype wire


// (c) Copyright 2011-2013, 2023 Advanced Micro Devices, Inc. All rights reserved.
//
// This file contains confidential and proprietary information
// of AMD and is protected under U.S. and international copyright
// and other intellectual property laws.
//
// DISCLAIMER
// This disclaimer is not a license and does not grant any
// rights to the materials distributed herewith. Except as
// otherwise provided in a valid license issued to you by
// AMD, and to the maximum extent permitted by applicable
// law: (1) THESE MATERIALS ARE MADE AVAILABLE "AS IS" AND
// WITH ALL FAULTS, AND AMD HEREBY DISCLAIMS ALL WARRANTIES
// AND CONDITIONS, EXPRESS, IMPLIED, OR STATUTORY, INCLUDING
// BUT NOT LIMITED TO WARRANTIES OF MERCHANTABILITY, NON-
// INFRINGEMENT, OR FITNESS FOR ANY PARTICULAR PURPOSE; and
// (2) AMD shall not be liable (whether in contract or tort,
// including negligence, or under any other theory of
// liability) for any loss or damage of any kind or nature
// related to, arising under or in connection with these
// materials, including for any direct, or any indirect,
// special, incidental, or consequential loss or damage
// (including loss of data, profits, goodwill, or any type of
// loss or damage suffered as a result of any action brought
// by a third party) even if such damage or loss was
// reasonably foreseeable or AMD had been advised of the
// possibility of the same.
//
// CRITICAL APPLICATIONS
// AMD products are not designed or intended to be fail-
// safe, or for use in any application requiring fail-safe
// performance, such as life-support or safety devices or
// systems, Class III medical devices, nuclear facilities,
// applications related to the deployment of airbags, or any
// other applications that could lead to death, personal
// injury, or severe property or environmental damage
// (individually and collectively, "Critical
// Applications"). Customer assumes the sole risk and
// liability of any use of AMD products in Critical
// Applications, subject only to applicable laws and
// regulations governing limitations on product liability.
//
// THIS COPYRIGHT NOTICE AND DISCLAIMER MUST BE RETAINED AS
// PART OF THIS FILE AT ALL TIMES.
////////////////////////////////////////////////////////////
//
// axis_clock_converter
//
// Verilog-standard:  Verilog 2001
//--------------------------------------------------------------------------
//
// Structure:
//   axis_clock_converter
//     util_aclken_converter (optional)
//     fifo_generator
//       or
//     axisc_sync_clock_converter
//     util_aclken_converter (optional)
//--------------------------------------------------------------------------

`timescale 1ps/1ps
`default_nettype none

module axis_interconnect_v1_1_22_axis_clock_converter #
(
///////////////////////////////////////////////////////////////////////////////
// Parameter Definitions
///////////////////////////////////////////////////////////////////////////////
  parameter         C_FAMILY           = "virtex6",
  parameter integer C_AXIS_TDATA_WIDTH = 32,
  parameter integer C_AXIS_TID_WIDTH   = 1,
  parameter integer C_AXIS_TDEST_WIDTH = 1,
  parameter integer C_AXIS_TUSER_WIDTH = 1,
  parameter [31:0]  C_AXIS_SIGNAL_SET  = 32'hFF,
  // C_AXIS_SIGNAL_SET: each bit if enabled specifies which axis optional signals are present
  //   [0] => TREADY present
  //   [1] => TDATA present
  //   [2] => TSTRB present, TDATA must be present
  //   [3] => TKEEP present, TDATA must be present
  //   [4] => TLAST present
  //   [5] => TID present
  //   [6] => TDEST present
  //   [7] => TUSER present
  parameter         C_IS_ACLK_ASYNC     = 1'b1,
  parameter integer C_S_AXIS_ACLK_RATIO = 1,
  parameter integer C_M_AXIS_ACLK_RATIO = 1,
  parameter integer C_ACLKEN_CONV_MODE  = 0,
  // C_ACLKEN_CONV_MODE: Determines how to handle the clock enable pins during
  // clock conversion
  // 0 -- Clock enables not converted
  // 1 -- S_AXIS_ACLKEN can toggle,  M_AXIS_ACLKEN always high.
  // 2 -- S_AXIS_ACLKEN always high, M_AXIS_ACLKEN can toggle.
  // 3 -- S_AXIS_ACLKEN can toggle,  M_AXIS_ACLKEN can toggle.
  parameter integer C_SYNCHRONIZER_STAGE = 2
  )
  (
///////////////////////////////////////////////////////////////////////////////
// Port Declarations
///////////////////////////////////////////////////////////////////////////////
   // System Signals
   input wire                             S_AXIS_ARESETN,
   input wire                             M_AXIS_ARESETN,
   input wire                             S_AXIS_ACLKEN,
   input wire                             M_AXIS_ACLKEN,

   // Slave side
   input  wire                            S_AXIS_ACLK,
   input  wire                            S_AXIS_TVALID,
   output wire                            S_AXIS_TREADY,
   input  wire [C_AXIS_TDATA_WIDTH-1:0]   S_AXIS_TDATA,
   input  wire [C_AXIS_TDATA_WIDTH/8-1:0] S_AXIS_TSTRB,
   input  wire [C_AXIS_TDATA_WIDTH/8-1:0] S_AXIS_TKEEP,
   input  wire                            S_AXIS_TLAST,
   input  wire [C_AXIS_TID_WIDTH-1:0]     S_AXIS_TID,
   input  wire [C_AXIS_TDEST_WIDTH-1:0]   S_AXIS_TDEST,
   input  wire [C_AXIS_TUSER_WIDTH-1:0]   S_AXIS_TUSER,

   // Master side
   input  wire                            M_AXIS_ACLK,
   output wire                            M_AXIS_TVALID,
   input  wire                            M_AXIS_TREADY,
   output wire [C_AXIS_TDATA_WIDTH-1:0]   M_AXIS_TDATA,
   output wire [C_AXIS_TDATA_WIDTH/8-1:0] M_AXIS_TSTRB,
   output wire [C_AXIS_TDATA_WIDTH/8-1:0] M_AXIS_TKEEP,
   output wire                            M_AXIS_TLAST,
   output wire [C_AXIS_TID_WIDTH-1:0]     M_AXIS_TID,
   output wire [C_AXIS_TDEST_WIDTH-1:0]   M_AXIS_TDEST,
   output wire [C_AXIS_TUSER_WIDTH-1:0]   M_AXIS_TUSER

   );

////////////////////////////////////////////////////////////////////////////////
// Functions
////////////////////////////////////////////////////////////////////////////////
`include "axis_interconnect_v1_1_22.vh"

////////////////////////////////////////////////////////////////////////////////
// Local parameters
////////////////////////////////////////////////////////////////////////////////
localparam integer LP_S_ACLKEN_CAN_TOGGLE = (C_ACLKEN_CONV_MODE == 1) || (C_ACLKEN_CONV_MODE == 3);
localparam integer LP_M_ACLKEN_CAN_TOGGLE = (C_ACLKEN_CONV_MODE == 2) || (C_ACLKEN_CONV_MODE == 3);
localparam integer P_FIFO_MODE            = 1;  // clock converter use of fifo_gen will not 
                                                // use packet mode.                                           
localparam integer P_FIFO_DEPTH           = 32; // clock converter use of fifo_gen be fixed 
                                                // at 32 deep fifo.
                                          
localparam integer P_S_AXIS_ACLK_RATIO    = f_lcm(C_S_AXIS_ACLK_RATIO, C_M_AXIS_ACLK_RATIO) / C_M_AXIS_ACLK_RATIO;
localparam integer P_M_AXIS_ACLK_RATIO    = f_lcm(C_S_AXIS_ACLK_RATIO, C_M_AXIS_ACLK_RATIO) / C_S_AXIS_ACLK_RATIO;
                                          
localparam integer P_INST_FIFO_GEN        =  C_IS_ACLK_ASYNC || (P_S_AXIS_ACLK_RATIO != 1 && P_M_AXIS_ACLK_RATIO != 1);
                                          
localparam integer P_TPAYLOAD_WIDTH       = f_payload_width(C_AXIS_TDATA_WIDTH, C_AXIS_TID_WIDTH, 
                                                 C_AXIS_TDEST_WIDTH, C_AXIS_TUSER_WIDTH, 
                                                 C_AXIS_SIGNAL_SET);
localparam integer P_SAMPLE_CYCLE_RATIO   = (C_S_AXIS_ACLK_RATIO > C_M_AXIS_ACLK_RATIO) 
                                            ? C_S_AXIS_ACLK_RATIO : C_M_AXIS_ACLK_RATIO;


////////////////////////////////////////////////////////////////////////////////
// Wires/Reg declarations
////////////////////////////////////////////////////////////////////////////////
wire [P_TPAYLOAD_WIDTH-1:0] s_axis_tpayload;

wire [P_TPAYLOAD_WIDTH-1:0] d1_tpayload;
wire                        d1_tvalid;
wire                        d1_tready;

wire [P_TPAYLOAD_WIDTH-1:0] d2_tpayload;
wire                        d2_tvalid;
wire                        d2_tready;

wire [P_TPAYLOAD_WIDTH-1:0] m_axis_tpayload;


////////////////////////////////////////////////////////////////////////////////
// BEGIN RTL
////////////////////////////////////////////////////////////////////////////////



generate
  if (P_INST_FIFO_GEN) begin : gen_fifo_gen_ck_conv
    // Asynchronous and default is to use fifo_gen for clock conversion
    axis_interconnect_v1_1_22_axis_data_fifo #(
      .C_FAMILY           ( C_FAMILY           ) ,
      .C_AXIS_TDATA_WIDTH ( C_AXIS_TDATA_WIDTH ) ,
      .C_AXIS_TID_WIDTH   ( C_AXIS_TID_WIDTH   ) ,
      .C_AXIS_TDEST_WIDTH ( C_AXIS_TDEST_WIDTH ) ,
      .C_AXIS_TUSER_WIDTH ( C_AXIS_TUSER_WIDTH ) ,
      .C_AXIS_SIGNAL_SET  ( C_AXIS_SIGNAL_SET  ) ,
      .C_FIFO_DEPTH       ( P_FIFO_DEPTH       ) ,
      .C_FIFO_MODE        ( P_FIFO_MODE        ) ,
      .C_IS_ACLK_ASYNC    ( 1                  ) , // enables clock cross when 1
      .C_ACLKEN_CONV_MODE ( C_ACLKEN_CONV_MODE ) ,
      .C_SYNCHRONIZER_STAGE ( C_SYNCHRONIZER_STAGE )
    )
    axis_data_fifo_0
    (
      .S_AXIS_ARESETN ( S_AXIS_ARESETN ) ,
      .M_AXIS_ARESETN ( M_AXIS_ARESETN ) ,
      .S_AXIS_ACLK    ( S_AXIS_ACLK    ) ,
      .S_AXIS_ACLKEN  ( S_AXIS_ACLKEN  ) ,
      .S_AXIS_TVALID  ( S_AXIS_TVALID  ) ,
      .S_AXIS_TREADY  ( S_AXIS_TREADY  ) ,
      .S_AXIS_TDATA   ( S_AXIS_TDATA   ) ,
      .S_AXIS_TSTRB   ( S_AXIS_TSTRB   ) ,
      .S_AXIS_TKEEP   ( S_AXIS_TKEEP   ) ,
      .S_AXIS_TLAST   ( S_AXIS_TLAST   ) ,
      .S_AXIS_TID     ( S_AXIS_TID     ) ,
      .S_AXIS_TDEST   ( S_AXIS_TDEST   ) ,
      .S_AXIS_TUSER   ( S_AXIS_TUSER   ) ,
      .M_AXIS_ACLK    ( M_AXIS_ACLK    ) ,
      .M_AXIS_ACLKEN  ( M_AXIS_ACLKEN  ) ,
      .M_AXIS_TVALID  ( M_AXIS_TVALID  ) ,
      .M_AXIS_TREADY  ( M_AXIS_TREADY  ) ,
      .M_AXIS_TDATA   ( M_AXIS_TDATA   ) ,
      .M_AXIS_TSTRB   ( M_AXIS_TSTRB   ) ,
      .M_AXIS_TKEEP   ( M_AXIS_TKEEP   ) ,
      .M_AXIS_TLAST   ( M_AXIS_TLAST   ) ,
      .M_AXIS_TID     ( M_AXIS_TID     ) ,
      .M_AXIS_TDEST   ( M_AXIS_TDEST   ) ,
      .M_AXIS_TUSER   ( M_AXIS_TUSER   ) ,
      .AXIS_DATA_COUNT    (            ) ,
      .AXIS_WR_DATA_COUNT (            ) ,
      .AXIS_RD_DATA_COUNT (            ) 
    );
  end
  else begin : gen_sync_ck_conv

    wire                        slow_aclk;
    wire                        fast_aclk;
    wire                        sample_cycle_early;
    wire                        sample_cycle;

    axis_interconnect_v1_1_22_util_axis2vector #(
      .C_TDATA_WIDTH    ( C_AXIS_TDATA_WIDTH ) ,
      .C_TID_WIDTH      ( C_AXIS_TID_WIDTH   ) ,
      .C_TDEST_WIDTH    ( C_AXIS_TDEST_WIDTH ) ,
      .C_TUSER_WIDTH    ( C_AXIS_TUSER_WIDTH ) ,
      .C_TPAYLOAD_WIDTH ( P_TPAYLOAD_WIDTH   ) ,
      .C_SIGNAL_SET     ( C_AXIS_SIGNAL_SET  ) 
    )
    util_axis2vector_0 (
      .TDATA    ( S_AXIS_TDATA    ) ,
      .TSTRB    ( S_AXIS_TSTRB    ) ,
      .TKEEP    ( S_AXIS_TKEEP    ) ,
      .TLAST    ( S_AXIS_TLAST    ) ,
      .TID      ( S_AXIS_TID      ) ,
      .TDEST    ( S_AXIS_TDEST    ) ,
      .TUSER    ( S_AXIS_TUSER    ) ,
      .TPAYLOAD ( s_axis_tpayload )
    );

    if (LP_S_ACLKEN_CAN_TOGGLE) begin : gen_s_aclken_converter
      axis_interconnect_v1_1_22_util_aclken_converter #( 
        .C_PAYLOAD_WIDTH       ( P_TPAYLOAD_WIDTH       ) ,
        .C_S_ACLKEN_CAN_TOGGLE ( LP_S_ACLKEN_CAN_TOGGLE ) ,
        .C_M_ACLKEN_CAN_TOGGLE ( 0                      ) 
      )
      s_util_aclken_converter_0 ( 
        .ACLK      ( S_AXIS_ACLK     ) ,
        .ARESETN   ( S_AXIS_ARESETN  ) ,
        .S_ACLKEN  ( S_AXIS_ACLKEN   ) ,
        .S_PAYLOAD ( s_axis_tpayload ) ,
        .S_VALID   ( S_AXIS_TVALID   ) ,
        .S_READY   ( S_AXIS_TREADY   ) ,
        .M_ACLKEN  ( 1'b1            ) ,
        .M_PAYLOAD ( d1_tpayload     ) ,
        .M_VALID   ( d1_tvalid       ) ,
        .M_READY   ( d1_tready       )
      );
    end
    else begin : gen_s_aclken_passthru
      assign d1_tpayload = s_axis_tpayload;
      assign d1_tvalid   = S_AXIS_TVALID;
      assign S_AXIS_TREADY = d1_tready;
    end

    // Sample cycle used to determine when to assert a signal on a fast clock
    // to be flopped onto a slow clock.
    assign slow_aclk   = (C_S_AXIS_ACLK_RATIO > C_M_AXIS_ACLK_RATIO) ? M_AXIS_ACLK   : S_AXIS_ACLK;
    assign fast_aclk   = (C_S_AXIS_ACLK_RATIO < C_M_AXIS_ACLK_RATIO) ? M_AXIS_ACLK   : S_AXIS_ACLK;

    axis_interconnect_v1_1_22_axisc_sample_cycle_ratio #(
      .C_RATIO ( P_SAMPLE_CYCLE_RATIO )
    ) 
    axisc_sample_cycle_ratio_m (
      .SLOW_ACLK          ( slow_aclk          ) ,
      .FAST_ACLK          ( fast_aclk          ) ,
      .SAMPLE_CYCLE_EARLY ( sample_cycle_early ) ,
      .SAMPLE_CYCLE       ( sample_cycle       ) 
    );

    axis_interconnect_v1_1_22_axisc_sync_clock_converter #( 
      .C_FAMILY        ( C_FAMILY            ) ,
      .C_PAYLOAD_WIDTH ( P_TPAYLOAD_WIDTH    ) ,
      .C_S_ACLK_RATIO  ( P_S_AXIS_ACLK_RATIO ) ,
      .C_M_ACLK_RATIO  ( P_M_AXIS_ACLK_RATIO ) ,
      .C_MODE          ( 1 )
    )
    axisc_sync_clock_converter_0 (
      .SAMPLE_CYCLE_EARLY ( sample_cycle_early ) ,
      .SAMPLE_CYCLE       ( sample_cycle       ) ,
      .S_ACLK             ( S_AXIS_ACLK        ) ,
      .S_ARESETN          ( S_AXIS_ARESETN     ) ,
      .S_PAYLOAD          ( d1_tpayload        ) ,
      .S_VALID            ( d1_tvalid          ) ,
      .S_READY            ( d1_tready          ) ,
      .M_ACLK             ( M_AXIS_ACLK        ) ,
      .M_ARESETN          ( M_AXIS_ARESETN     ) ,
      .M_PAYLOAD          ( d2_tpayload        ) ,
      .M_VALID            ( d2_tvalid          ) ,
      .M_READY            ( d2_tready          ) 
    );

    if (LP_M_ACLKEN_CAN_TOGGLE) begin : gen_m_aclken_converter
      axis_interconnect_v1_1_22_util_aclken_converter #( 
        .C_PAYLOAD_WIDTH       ( P_TPAYLOAD_WIDTH       ) ,
        .C_S_ACLKEN_CAN_TOGGLE ( 0                      ) ,
        .C_M_ACLKEN_CAN_TOGGLE ( LP_M_ACLKEN_CAN_TOGGLE ) 
      )
      m_util_aclken_converter_0 ( 
        .ACLK      ( M_AXIS_ACLK     ) ,
        .ARESETN   ( M_AXIS_ARESETN  ) ,
        .S_ACLKEN  ( 1'b1            ) ,
        .S_PAYLOAD ( d2_tpayload     ) ,
        .S_VALID   ( d2_tvalid       ) ,
        .S_READY   ( d2_tready       ) ,
        .M_ACLKEN  ( M_AXIS_ACLKEN   ) ,
        .M_PAYLOAD ( m_axis_tpayload ) ,
        .M_VALID   ( M_AXIS_TVALID   ) ,
        .M_READY   ( M_AXIS_TREADY   ) 
      );
    end
    else begin : gen_m_aclken_passthru
      assign m_axis_tpayload = d2_tpayload;
      assign M_AXIS_TVALID = d2_tvalid;
      assign d2_tready = M_AXIS_TREADY;
    end

    axis_interconnect_v1_1_22_util_vector2axis #(
      .C_TDATA_WIDTH    ( C_AXIS_TDATA_WIDTH ) ,
      .C_TID_WIDTH      ( C_AXIS_TID_WIDTH   ) ,
      .C_TDEST_WIDTH    ( C_AXIS_TDEST_WIDTH ) ,
      .C_TUSER_WIDTH    ( C_AXIS_TUSER_WIDTH ) ,
      .C_TPAYLOAD_WIDTH ( P_TPAYLOAD_WIDTH   ) ,
      .C_SIGNAL_SET     ( C_AXIS_SIGNAL_SET  ) 
    )
    util_vector2axis_0 (
      .TPAYLOAD ( m_axis_tpayload ) ,
      .TDATA    ( M_AXIS_TDATA    ) ,
      .TSTRB    ( M_AXIS_TSTRB    ) ,
      .TKEEP    ( M_AXIS_TKEEP    ) ,
      .TLAST    ( M_AXIS_TLAST    ) ,
      .TID      ( M_AXIS_TID      ) ,
      .TDEST    ( M_AXIS_TDEST    ) ,
      .TUSER    ( M_AXIS_TUSER    ) 
    );
  end

endgenerate



endmodule // axis_clock_converter

`default_nettype wire


// (c) Copyright 2012-2014, 2023 Advanced Micro Devices, Inc. All rights reserved.
//
// This file contains confidential and proprietary information
// of AMD and is protected under U.S. and international copyright
// and other intellectual property laws.
//
// DISCLAIMER
// This disclaimer is not a license and does not grant any
// rights to the materials distributed herewith. Except as
// otherwise provided in a valid license issued to you by
// AMD, and to the maximum extent permitted by applicable
// law: (1) THESE MATERIALS ARE MADE AVAILABLE "AS IS" AND
// WITH ALL FAULTS, AND AMD HEREBY DISCLAIMS ALL WARRANTIES
// AND CONDITIONS, EXPRESS, IMPLIED, OR STATUTORY, INCLUDING
// BUT NOT LIMITED TO WARRANTIES OF MERCHANTABILITY, NON-
// INFRINGEMENT, OR FITNESS FOR ANY PARTICULAR PURPOSE; and
// (2) AMD shall not be liable (whether in contract or tort,
// including negligence, or under any other theory of
// liability) for any loss or damage of any kind or nature
// related to, arising under or in connection with these
// materials, including for any direct, or any indirect,
// special, incidental, or consequential loss or damage
// (including loss of data, profits, goodwill, or any type of
// loss or damage suffered as a result of any action brought
// by a third party) even if such damage or loss was
// reasonably foreseeable or AMD had been advised of the
// possibility of the same.
//
// CRITICAL APPLICATIONS
// AMD products are not designed or intended to be fail-
// safe, or for use in any application requiring fail-safe
// performance, such as life-support or safety devices or
// systems, Class III medical devices, nuclear facilities,
// applications related to the deployment of airbags, or any
// other applications that could lead to death, personal
// injury, or severe property or environmental damage
// (individually and collectively, "Critical
// Applications"). Customer assumes the sole risk and
// liability of any use of AMD products in Critical
// Applications, subject only to applicable laws and
// regulations governing limitations on product liability.
//
// THIS COPYRIGHT NOTICE AND DISCLAIMER MUST BE RETAINED AS
// PART OF THIS FILE AT ALL TIMES.
////////////////////////////////////////////////////////////
//
// axis_data_fifo
//   Instantiates AXIS FIFO Generator Core
//
// Verilog-standard:  Verilog 2001
//--------------------------------------------------------------------------
//
// Structure:
//   axis_data_fifo
//     fifo-generator_v9_3
//--------------------------------------------------------------------------

`timescale 1ps/1ps

module axis_interconnect_v1_1_22_axis_data_fifo #
(
///////////////////////////////////////////////////////////////////////////////
// Parameter Definitions
///////////////////////////////////////////////////////////////////////////////
   parameter         C_FAMILY           = "virtex6",
   parameter integer C_AXIS_TDATA_WIDTH = 32,
   parameter integer C_AXIS_TID_WIDTH   = 1,
   parameter integer C_AXIS_TDEST_WIDTH = 1,
   parameter integer C_AXIS_TUSER_WIDTH = 1,
   parameter [31:0]  C_AXIS_SIGNAL_SET  = 32'hFF,
   // C_AXIS_SIGNAL_SET: each bit if enabled specifies which axis optional signals are present
   //   [0] => TREADY present
   //   [1] => TDATA present
   //   [2] => TSTRB present, TDATA must be present
   //   [3] => TKEEP present, TDATA must be present
   //   [4] => TLAST present
   //   [5] => TID present
   //   [6] => TDEST present
   //   [7] => TUSER present
   parameter integer C_FIFO_DEPTH       = 1024,
   //  Valid values 16,32,64,128,256,512,1024,2048,4096,...
   parameter integer C_FIFO_MODE  = 1,
   // Values: 
   //   0 == N0 FIFO
   //   1 == Regular FIFO
   //   2 == Store and Forward FIFO (Packet Mode). Requires TLAST. 
   parameter integer C_IS_ACLK_ASYNC    = 0,
   //  Enables async clock cross when 1.
   parameter integer C_ACLKEN_CONV_MODE  = 0,
   // C_ACLKEN_CONV_MODE: Determines how to handle the clock enable pins during
   // clock conversion
   // 0 -- Clock enables not converted
   // 1 -- S_AXIS_ACLKEN can toggle,  M_AXIS_ACLKEN always high.
   // 2 -- S_AXIS_ACLKEN always high, M_AXIS_ACLKEN can toggle.
   // 3 -- S_AXIS_ACLKEN can toggle,  M_AXIS_ACLKEN can toggle.
   parameter integer C_SYNCHRONIZER_STAGE = 2
   )
  (
///////////////////////////////////////////////////////////////////////////////
// Port Declarations
///////////////////////////////////////////////////////////////////////////////
   // System Signals
   input wire                             S_AXIS_ARESETN,
   input wire                             M_AXIS_ARESETN,
/*   input wire ACLKEN,*/

   // Slave side
   input  wire                            S_AXIS_ACLK,
   input  wire                            S_AXIS_ACLKEN,
   input  wire                            S_AXIS_TVALID,
   output wire                            S_AXIS_TREADY,
   input  wire [C_AXIS_TDATA_WIDTH-1:0]   S_AXIS_TDATA,
   input  wire [C_AXIS_TDATA_WIDTH/8-1:0] S_AXIS_TSTRB,
   input  wire [C_AXIS_TDATA_WIDTH/8-1:0] S_AXIS_TKEEP,
   input  wire                            S_AXIS_TLAST,
   input  wire [C_AXIS_TID_WIDTH-1:0]     S_AXIS_TID,
   input  wire [C_AXIS_TDEST_WIDTH-1:0]   S_AXIS_TDEST,
   input  wire [C_AXIS_TUSER_WIDTH-1:0]   S_AXIS_TUSER,

   // Master side
   input  wire                            M_AXIS_ACLK,
   input  wire                            M_AXIS_ACLKEN,
   output wire                            M_AXIS_TVALID,
   input  wire                            M_AXIS_TREADY,
   output wire [C_AXIS_TDATA_WIDTH-1:0]   M_AXIS_TDATA,
   output wire [C_AXIS_TDATA_WIDTH/8-1:0] M_AXIS_TSTRB,
   output wire [C_AXIS_TDATA_WIDTH/8-1:0] M_AXIS_TKEEP,
   output wire                            M_AXIS_TLAST,
   output wire [C_AXIS_TID_WIDTH-1:0]     M_AXIS_TID,
   output wire [C_AXIS_TDEST_WIDTH-1:0]   M_AXIS_TDEST,
   output wire [C_AXIS_TUSER_WIDTH-1:0]   M_AXIS_TUSER,

   // Status signals
   output wire [31:0]                     AXIS_DATA_COUNT,
   output wire [31:0]                     AXIS_WR_DATA_COUNT,
   output wire [31:0]                     AXIS_RD_DATA_COUNT
   );

////////////////////////////////////////////////////////////////////////////////
// Functions
////////////////////////////////////////////////////////////////////////////////
`include "axis_interconnect_v1_1_22.vh"

////////////////////////////////////////////////////////////////////////////////
// Local parameters
////////////////////////////////////////////////////////////////////////////////
localparam P_TREADY_EXISTS = C_AXIS_SIGNAL_SET[0]? 1: 0;
localparam P_TDATA_EXISTS  = C_AXIS_SIGNAL_SET[1]? 1: 0;
localparam P_TSTRB_EXISTS  = C_AXIS_SIGNAL_SET[2]? 1: 0;
localparam P_TKEEP_EXISTS  = C_AXIS_SIGNAL_SET[3]? 1: 0;
localparam P_TLAST_EXISTS  = C_AXIS_SIGNAL_SET[4]? 1: 0;
localparam P_TID_EXISTS    = C_AXIS_SIGNAL_SET[5]? 1: 0;
localparam P_TDEST_EXISTS  = C_AXIS_SIGNAL_SET[6]? 1: 0;
localparam P_TUSER_EXISTS  = C_AXIS_SIGNAL_SET[7]? 1: 0;
localparam P_AXIS_PAYLOAD_WIDTH = f_payload_width(C_AXIS_TDATA_WIDTH, C_AXIS_TID_WIDTH, C_AXIS_TDEST_WIDTH, 
                                             C_AXIS_TUSER_WIDTH, C_AXIS_SIGNAL_SET);
localparam P_WR_PNTR_WIDTH = f_clogb2(C_FIFO_DEPTH);
localparam P_FIFO_COUNT_WIDTH = P_WR_PNTR_WIDTH+1;
localparam P_FIFO_TYPE     = (C_FIFO_DEPTH > 32) ? 1 : 2; // 1 = bram, 2 = lutram.  Force 1 when > 32 deep.
localparam P_IMPLEMENTATION_TYPE_AXIS = C_IS_ACLK_ASYNC ? P_FIFO_TYPE + 10 : P_FIFO_TYPE;
localparam P_COMMON_CLOCK  = C_IS_ACLK_ASYNC ? 0 : 1;
localparam P_MSGON_VAL     = C_IS_ACLK_ASYNC ? 0 : 1;

// Packet mode only valid if tlast is enabled.  Force to 0 if no TLAST
// present.
localparam integer P_APPLICATION_TYPE_AXIS = P_TLAST_EXISTS ? (C_FIFO_MODE == 2) : 0;
localparam integer LP_S_ACLKEN_CAN_TOGGLE = (C_ACLKEN_CONV_MODE == 1) || (C_ACLKEN_CONV_MODE == 3);
localparam integer LP_M_ACLKEN_CAN_TOGGLE = (C_ACLKEN_CONV_MODE == 2) || (C_ACLKEN_CONV_MODE == 3);
                                           

////////////////////////////////////////////////////////////////////////////////
// Wires/Reg declarations
////////////////////////////////////////////////////////////////////////////////
wire [P_FIFO_COUNT_WIDTH-1:0]   axis_data_count_i;
wire [P_FIFO_COUNT_WIDTH-1:0]   axis_wr_data_count_i;
wire [P_FIFO_COUNT_WIDTH-1:0]   axis_rd_data_count_i;
(* KEEP = "TRUE" *)
wire                            s_and_m_aresetn_i;
wire                            d1_tvalid;
wire                            d1_tready;
wire [C_AXIS_TDATA_WIDTH-1:0]   d1_tdata;
wire [C_AXIS_TDATA_WIDTH/8-1:0] d1_tstrb;
wire [C_AXIS_TDATA_WIDTH/8-1:0] d1_tkeep;
wire                            d1_tlast;
wire [C_AXIS_TID_WIDTH-1:0]     d1_tid  ;
wire [C_AXIS_TDEST_WIDTH-1:0]   d1_tdest;
wire [C_AXIS_TUSER_WIDTH-1:0]   d1_tuser;

wire                            d2_tvalid;
wire                            d2_tready;
wire [C_AXIS_TDATA_WIDTH-1:0]   d2_tdata;
wire [C_AXIS_TDATA_WIDTH/8-1:0] d2_tstrb;
wire [C_AXIS_TDATA_WIDTH/8-1:0] d2_tkeep;
wire                            d2_tlast;
wire [C_AXIS_TID_WIDTH-1:0]     d2_tid  ;
wire [C_AXIS_TDEST_WIDTH-1:0]   d2_tdest;
wire [C_AXIS_TUSER_WIDTH-1:0]   d2_tuser;

////////////////////////////////////////////////////////////////////////////////
// Tie offs to reduce warnings
////////////////////////////////////////////////////////////////////////////////
localparam C_DIN_WIDTH           = 18;
localparam C_RD_PNTR_WIDTH       = 10;
localparam C_WR_PNTR_WIDTH       = 10;
localparam C_DOUT_WIDTH          = 18;
localparam C_DATA_COUNT_WIDTH    = 10;
localparam C_RD_DATA_COUNT_WIDTH = 10;
localparam C_WR_DATA_COUNT_WIDTH = 10;
localparam C_AXI_ID_WIDTH        = 4;
localparam C_AXI_ADDR_WIDTH      = 32;
localparam C_AXI_DATA_WIDTH      = 64;
localparam C_AXI_AWUSER_WIDTH    = 1;
localparam C_AXI_ARUSER_WIDTH    = 1;
localparam C_AXI_RUSER_WIDTH     = 1;
localparam C_AXI_BUSER_WIDTH     = 1;
localparam C_AXI_WUSER_WIDTH     = 1;
localparam C_WR_PNTR_WIDTH_RACH  = 4;
localparam C_WR_PNTR_WIDTH_RDCH  = 10;
localparam C_WR_PNTR_WIDTH_WACH  = 4;
localparam C_WR_PNTR_WIDTH_WDCH  = 10;
localparam C_WR_PNTR_WIDTH_WRCH  = 4;
localparam C_RD_PNTR_WIDTH_RACH  = 4;
localparam C_RD_PNTR_WIDTH_RDCH  = 10;
localparam C_RD_PNTR_WIDTH_WACH  = 4;
localparam C_RD_PNTR_WIDTH_WDCH  = 10;
localparam C_RD_PNTR_WIDTH_WRCH  = 4;
localparam C_WR_PNTR_WIDTH_AXIS  = P_WR_PNTR_WIDTH;

wire                               BACKUP;
wire                               BACKUP_MARKER;
wire                               CLK;
wire                               RST;
wire                               SRST;
wire                               WR_CLK;
wire                               WR_RST_BUSY;
wire                               WR_RST;
wire                               RD_CLK;
wire                               RD_RST_BUSY;
wire                               RD_RST;
wire [C_DIN_WIDTH-1:0]             DIN;
wire                               WR_EN;
wire                               RD_EN;
// Optional wires
wire [C_RD_PNTR_WIDTH-1:0]         PROG_EMPTY_THRESH;
wire [C_RD_PNTR_WIDTH-1:0]         PROG_EMPTY_THRESH_ASSERT;
wire [C_RD_PNTR_WIDTH-1:0]         PROG_EMPTY_THRESH_NEGATE;
wire [C_WR_PNTR_WIDTH-1:0]         PROG_FULL_THRESH;
wire [C_WR_PNTR_WIDTH-1:0]         PROG_FULL_THRESH_ASSERT;
wire [C_WR_PNTR_WIDTH-1:0]         PROG_FULL_THRESH_NEGATE;
wire                               INT_CLK;
wire                               INJECTDBITERR;
wire                               INJECTSBITERR;

wire [C_DOUT_WIDTH-1:0]           DOUT;
wire                              FULL;
wire                              ALMOST_FULL;
wire                              WR_ACK;
wire                              OVERFLOW;
wire                              EMPTY;
wire                              ALMOST_EMPTY;
wire                              VALID;
wire                              UNDERFLOW;
wire [C_DATA_COUNT_WIDTH-1:0]     DATA_COUNT;
wire [C_RD_DATA_COUNT_WIDTH-1:0]  RD_DATA_COUNT;
wire [C_WR_DATA_COUNT_WIDTH-1:0]  WR_DATA_COUNT;
wire                              PROG_FULL;
wire                              PROG_EMPTY;
wire                              SBITERR;
wire                              SLEEP;
wire                              DBITERR;


// AXI Global Signal
wire                               M_ACLK;
wire                               S_ACLK;
wire                               S_ARESETN;
wire                               S_ACLK_EN;
wire                               M_ACLK_EN;

// AXI Full/Lite Slave Write Channel (write side)
wire [C_AXI_ID_WIDTH-1:0]          S_AXI_AWID;
wire [C_AXI_ADDR_WIDTH-1:0]        S_AXI_AWADDR;
wire [8-1:0]                       S_AXI_AWLEN;
wire [3-1:0]                       S_AXI_AWSIZE;
wire [2-1:0]                       S_AXI_AWBURST;
wire [2-1:0]                       S_AXI_AWLOCK;
wire [4-1:0]                       S_AXI_AWCACHE;
wire [3-1:0]                       S_AXI_AWPROT;
wire [4-1:0]                       S_AXI_AWQOS;
wire [4-1:0]                       S_AXI_AWREGION;
wire [C_AXI_AWUSER_WIDTH-1:0]      S_AXI_AWUSER;
wire                               S_AXI_AWVALID;
wire                              S_AXI_AWREADY;
wire [C_AXI_ID_WIDTH-1:0]          S_AXI_WID;
wire [C_AXI_DATA_WIDTH-1:0]        S_AXI_WDATA;
wire [C_AXI_DATA_WIDTH/8-1:0]      S_AXI_WSTRB;
wire                               S_AXI_WLAST;
wire [C_AXI_WUSER_WIDTH-1:0]       S_AXI_WUSER;
wire                               S_AXI_WVALID;
wire                              S_AXI_WREADY;
wire [C_AXI_ID_WIDTH-1:0]         S_AXI_BID;
wire [2-1:0]                      S_AXI_BRESP;
wire [C_AXI_BUSER_WIDTH-1:0]      S_AXI_BUSER;
wire                              S_AXI_BVALID;
wire                               S_AXI_BREADY;

// AXI Full/Lite Master Write Channel (Read side)
wire [C_AXI_ID_WIDTH-1:0]         M_AXI_AWID;
wire [C_AXI_ADDR_WIDTH-1:0]       M_AXI_AWADDR;
wire [8-1:0]                      M_AXI_AWLEN;
wire [3-1:0]                      M_AXI_AWSIZE;
wire [2-1:0]                      M_AXI_AWBURST;
wire [2-1:0]                      M_AXI_AWLOCK;
wire [4-1:0]                      M_AXI_AWCACHE;
wire [3-1:0]                      M_AXI_AWPROT;
wire [4-1:0]                      M_AXI_AWQOS;
wire [4-1:0]                      M_AXI_AWREGION;
wire [C_AXI_AWUSER_WIDTH-1:0]     M_AXI_AWUSER;
wire                              M_AXI_AWVALID;
wire                               M_AXI_AWREADY;
wire [C_AXI_ID_WIDTH-1:0]         M_AXI_WID;
wire [C_AXI_DATA_WIDTH-1:0]       M_AXI_WDATA;
wire [C_AXI_DATA_WIDTH/8-1:0]     M_AXI_WSTRB;
wire                              M_AXI_WLAST;
wire [C_AXI_WUSER_WIDTH-1:0]      M_AXI_WUSER;
wire                              M_AXI_WVALID;
wire                               M_AXI_WREADY;
wire [C_AXI_ID_WIDTH-1:0]          M_AXI_BID;
wire [2-1:0]                       M_AXI_BRESP;
wire [C_AXI_BUSER_WIDTH-1:0]       M_AXI_BUSER;
wire                               M_AXI_BVALID;
wire                              M_AXI_BREADY;


// AXI Full/Lite Slave Read Channel (Write side)
wire [C_AXI_ID_WIDTH-1:0]          S_AXI_ARID;
wire [C_AXI_ADDR_WIDTH-1:0]        S_AXI_ARADDR; 
wire [8-1:0]                       S_AXI_ARLEN;
wire [3-1:0]                       S_AXI_ARSIZE;
wire [2-1:0]                       S_AXI_ARBURST;
wire [2-1:0]                       S_AXI_ARLOCK;
wire [4-1:0]                       S_AXI_ARCACHE;
wire [3-1:0]                       S_AXI_ARPROT;
wire [4-1:0]                       S_AXI_ARQOS;
wire [4-1:0]                       S_AXI_ARREGION;
wire [C_AXI_ARUSER_WIDTH-1:0]      S_AXI_ARUSER;
wire                               S_AXI_ARVALID;
wire                              S_AXI_ARREADY;
wire [C_AXI_ID_WIDTH-1:0]         S_AXI_RID;       
wire [C_AXI_DATA_WIDTH-1:0]       S_AXI_RDATA; 
wire [2-1:0]                      S_AXI_RRESP;
wire                              S_AXI_RLAST;
wire [C_AXI_RUSER_WIDTH-1:0]      S_AXI_RUSER;
wire                              S_AXI_RVALID;
wire                               S_AXI_RREADY;



// AXI Full/Lite Master Read Channel (Read side)
wire [C_AXI_ID_WIDTH-1:0]         M_AXI_ARID;        
wire [C_AXI_ADDR_WIDTH-1:0]       M_AXI_ARADDR;  
wire [8-1:0]                      M_AXI_ARLEN;
wire [3-1:0]                      M_AXI_ARSIZE;
wire [2-1:0]                      M_AXI_ARBURST;
wire [2-1:0]                      M_AXI_ARLOCK;
wire [4-1:0]                      M_AXI_ARCACHE;
wire [3-1:0]                      M_AXI_ARPROT;
wire [4-1:0]                      M_AXI_ARQOS;
wire [4-1:0]                      M_AXI_ARREGION;
wire [C_AXI_ARUSER_WIDTH-1:0]     M_AXI_ARUSER;
wire                              M_AXI_ARVALID;
wire                               M_AXI_ARREADY;
wire [C_AXI_ID_WIDTH-1:0]          M_AXI_RID;        
wire [C_AXI_DATA_WIDTH-1:0]        M_AXI_RDATA;  
wire [2-1:0]                       M_AXI_RRESP;
wire                               M_AXI_RLAST;
wire [C_AXI_RUSER_WIDTH-1:0]       M_AXI_RUSER;
wire                               M_AXI_RVALID;
wire                              M_AXI_RREADY;

// AXI Full/Lite Write Address Channel Signals
wire                               AXI_AW_INJECTSBITERR;
wire                               AXI_AW_INJECTDBITERR;
wire  [C_WR_PNTR_WIDTH_WACH-1:0]   AXI_AW_PROG_FULL_THRESH;
wire  [C_WR_PNTR_WIDTH_WACH-1:0]   AXI_AW_PROG_EMPTY_THRESH;
wire [C_WR_PNTR_WIDTH_WACH:0]     AXI_AW_DATA_COUNT;
wire [C_WR_PNTR_WIDTH_WACH:0]     AXI_AW_WR_DATA_COUNT;
wire [C_WR_PNTR_WIDTH_WACH:0]     AXI_AW_RD_DATA_COUNT;
wire                              AXI_AW_SBITERR;
wire                              AXI_AW_DBITERR;
wire                              AXI_AW_OVERFLOW;
wire                              AXI_AW_UNDERFLOW;
wire                              AXI_AW_PROG_FULL;
wire                              AXI_AW_PROG_EMPTY;


// AXI Full/Lite Write Data Channel Signals
wire                               AXI_W_INJECTSBITERR;
wire                               AXI_W_INJECTDBITERR;
wire  [C_WR_PNTR_WIDTH_WDCH-1:0]   AXI_W_PROG_FULL_THRESH;
wire  [C_WR_PNTR_WIDTH_WDCH-1:0]   AXI_W_PROG_EMPTY_THRESH;
wire [C_WR_PNTR_WIDTH_WDCH:0]     AXI_W_DATA_COUNT;
wire [C_WR_PNTR_WIDTH_WDCH:0]     AXI_W_WR_DATA_COUNT;
wire [C_WR_PNTR_WIDTH_WDCH:0]     AXI_W_RD_DATA_COUNT;
wire                              AXI_W_SBITERR;
wire                              AXI_W_DBITERR;
wire                              AXI_W_OVERFLOW;
wire                              AXI_W_UNDERFLOW;
wire                              AXI_W_PROG_FULL;
wire                              AXI_W_PROG_EMPTY;


// AXI Full/Lite Write Response Channel Signals
wire                               AXI_B_INJECTSBITERR;
wire                               AXI_B_INJECTDBITERR;
wire  [C_WR_PNTR_WIDTH_WRCH-1:0]   AXI_B_PROG_FULL_THRESH;
wire  [C_WR_PNTR_WIDTH_WRCH-1:0]   AXI_B_PROG_EMPTY_THRESH;
wire [C_WR_PNTR_WIDTH_WRCH:0]     AXI_B_DATA_COUNT;
wire [C_WR_PNTR_WIDTH_WRCH:0]     AXI_B_WR_DATA_COUNT;
wire [C_WR_PNTR_WIDTH_WRCH:0]     AXI_B_RD_DATA_COUNT;
wire                              AXI_B_SBITERR;
wire                              AXI_B_DBITERR;
wire                              AXI_B_OVERFLOW;
wire                              AXI_B_UNDERFLOW;
wire                              AXI_B_PROG_FULL;
wire                              AXI_B_PROG_EMPTY;



// AXI Full/Lite Read Address Channel Signals
wire                               AXI_AR_INJECTSBITERR;
wire                               AXI_AR_INJECTDBITERR;
wire  [C_WR_PNTR_WIDTH_RACH-1:0]   AXI_AR_PROG_FULL_THRESH;
wire  [C_WR_PNTR_WIDTH_RACH-1:0]   AXI_AR_PROG_EMPTY_THRESH;
wire [C_WR_PNTR_WIDTH_RACH:0]     AXI_AR_DATA_COUNT;
wire [C_WR_PNTR_WIDTH_RACH:0]     AXI_AR_WR_DATA_COUNT;
wire [C_WR_PNTR_WIDTH_RACH:0]     AXI_AR_RD_DATA_COUNT;
wire                              AXI_AR_SBITERR;
wire                              AXI_AR_DBITERR;
wire                              AXI_AR_OVERFLOW;
wire                              AXI_AR_UNDERFLOW;
wire                              AXI_AR_PROG_FULL;
wire                              AXI_AR_PROG_EMPTY;


// AXI Full/Lite Read Data Channel Signals
wire                               AXI_R_INJECTSBITERR;
wire                               AXI_R_INJECTDBITERR;
wire  [C_WR_PNTR_WIDTH_RDCH-1:0]   AXI_R_PROG_FULL_THRESH;
wire  [C_WR_PNTR_WIDTH_RDCH-1:0]   AXI_R_PROG_EMPTY_THRESH;
wire [C_WR_PNTR_WIDTH_RDCH:0]     AXI_R_DATA_COUNT;
wire [C_WR_PNTR_WIDTH_RDCH:0]     AXI_R_WR_DATA_COUNT;
wire [C_WR_PNTR_WIDTH_RDCH:0]     AXI_R_RD_DATA_COUNT;
wire                              AXI_R_SBITERR;
wire                              AXI_R_DBITERR;
wire                              AXI_R_OVERFLOW;
wire                              AXI_R_UNDERFLOW;
wire                              AXI_R_PROG_FULL;
wire                              AXI_R_PROG_EMPTY;


// AXI Streaming FIFO Related Signals
wire                               AXIS_INJECTSBITERR;
wire                               AXIS_INJECTDBITERR;
wire  [C_WR_PNTR_WIDTH_AXIS-1:0]   AXIS_PROG_FULL_THRESH;
wire  [C_WR_PNTR_WIDTH_AXIS-1:0]   AXIS_PROG_EMPTY_THRESH;
wire                              AXIS_SBITERR;
wire                              AXIS_DBITERR;
wire                              AXIS_OVERFLOW;
wire                              AXIS_UNDERFLOW;
wire                              AXIS_PROG_FULL;
wire                              AXIS_PROG_EMPTY;

assign S_ACLK_EN                = 1'b1;
assign M_ACLK_EN                = 1'b1;
assign BACKUP                   = 1'b0;
assign BACKUP_MARKER            = 1'b0;
assign CLK                      = 1'b0;
assign RST                      = 1'b0;
assign SRST                     = 1'b0;
assign WR_CLK                   = 1'b0;
assign WR_RST                   = 1'b0;
assign RD_CLK                   = 1'b0;
assign RD_RST                   = 1'b0;
assign DIN                      = {C_DIN_WIDTH{1'b0}};
assign WR_EN                    = 1'b0;
assign RD_EN                    = 1'b0;
assign PROG_EMPTY_THRESH        = {C_RD_PNTR_WIDTH{1'b0}};
assign PROG_EMPTY_THRESH_ASSERT = {C_RD_PNTR_WIDTH{1'b0}};
assign PROG_EMPTY_THRESH_NEGATE = {C_RD_PNTR_WIDTH{1'b0}};
assign PROG_FULL_THRESH         = {C_WR_PNTR_WIDTH{1'b0}};
assign PROG_FULL_THRESH_ASSERT  = {C_WR_PNTR_WIDTH{1'b0}};
assign PROG_FULL_THRESH_NEGATE  = {C_WR_PNTR_WIDTH{1'b0}};
assign INT_CLK                  = 1'b0;
assign INJECTDBITERR            = 1'b0;
assign INJECTSBITERR            = 1'b0;
assign S_AXI_AWID               = {C_AXI_ID_WIDTH{1'b0}};
assign S_AXI_AWADDR             = {C_AXI_ADDR_WIDTH{1'b0}};
assign S_AXI_AWLEN              = {8{1'b0}};
assign S_AXI_AWSIZE             = {3{1'b0}};
assign S_AXI_AWBURST            = {2{1'b0}};
assign S_AXI_AWLOCK             = {2{1'b0}};
assign S_AXI_AWCACHE            = {4{1'b0}};
assign S_AXI_AWPROT             = {3{1'b0}};
assign S_AXI_AWQOS              = {4{1'b0}};
assign S_AXI_AWREGION           = {4{1'b0}};
assign S_AXI_AWUSER             = {C_AXI_AWUSER_WIDTH{1'b0}};
assign S_AXI_AWVALID            = 1'b0;
assign S_AXI_WID                = {C_AXI_ID_WIDTH{1'b0}};
assign S_AXI_WDATA              = {C_AXI_DATA_WIDTH{1'b0}};
assign S_AXI_WSTRB              = {C_AXI_DATA_WIDTH/8{1'b0}};
assign S_AXI_WLAST              = 1'b0;
assign S_AXI_WUSER              = {C_AXI_WUSER_WIDTH{1'b0}};
assign S_AXI_WVALID             = 1'b0;
assign S_AXI_BREADY             = 1'b0;
assign M_AXI_AWREADY            = 1'b0;
assign M_AXI_WREADY             = 1'b0;
assign M_AXI_BID                = {C_AXI_ID_WIDTH{1'b0}};
assign M_AXI_BRESP              = {2{1'b0}};
assign M_AXI_BUSER              = {C_AXI_BUSER_WIDTH{1'b0}};
assign M_AXI_BVALID             = 1'b0;
assign S_AXI_ARID               = {C_AXI_ID_WIDTH{1'b0}};
assign S_AXI_ARADDR             = {C_AXI_ADDR_WIDTH{1'b0}};
assign S_AXI_ARLEN              = {8{1'b0}};
assign S_AXI_ARSIZE             = {3{1'b0}};
assign S_AXI_ARBURST            = {2{1'b0}};
assign S_AXI_ARLOCK             = {2{1'b0}};
assign S_AXI_ARCACHE            = {4{1'b0}};
assign S_AXI_ARPROT             = {3{1'b0}};
assign S_AXI_ARQOS              = {4{1'b0}};
assign S_AXI_ARREGION           = {4{1'b0}};
assign S_AXI_ARUSER             = {C_AXI_ARUSER_WIDTH{1'b0}};
assign S_AXI_ARVALID            = 1'b0;
assign S_AXI_RREADY             = 1'b0;
assign M_AXI_ARREADY            = 1'b0;
assign M_AXI_RID                = {C_AXI_ID_WIDTH{1'b0}};
assign M_AXI_RDATA              = {C_AXI_DATA_WIDTH{1'b0}};
assign M_AXI_RRESP              = {2{1'b0}};
assign M_AXI_RLAST              = 1'b0;
assign M_AXI_RUSER              = {C_AXI_RUSER_WIDTH{1'b0}};
assign M_AXI_RVALID             = 1'b0;
assign AXI_AW_INJECTSBITERR     = 1'b0;
assign AXI_AW_INJECTDBITERR     = 1'b0;
assign AXI_AW_PROG_FULL_THRESH  = {C_WR_PNTR_WIDTH_WACH{1'b0}};
assign AXI_AW_PROG_EMPTY_THRESH = {C_WR_PNTR_WIDTH_WACH{1'b0}};
assign AXI_W_INJECTSBITERR      = 1'b0;
assign AXI_W_INJECTDBITERR      = 1'b0;
assign AXI_W_PROG_FULL_THRESH   = {C_WR_PNTR_WIDTH_WDCH{1'b0}};
assign AXI_W_PROG_EMPTY_THRESH  = {C_WR_PNTR_WIDTH_WDCH{1'b0}};
assign AXI_B_INJECTSBITERR      = 1'b0;
assign AXI_B_INJECTDBITERR      = 1'b0;
assign AXI_B_PROG_FULL_THRESH   = {C_WR_PNTR_WIDTH_WRCH{1'b0}};
assign AXI_B_PROG_EMPTY_THRESH  = {C_WR_PNTR_WIDTH_WRCH{1'b0}};
assign AXI_AR_INJECTSBITERR     = 1'b0;
assign AXI_AR_INJECTDBITERR     = 1'b0;
assign AXI_AR_PROG_FULL_THRESH  = {C_WR_PNTR_WIDTH_RACH{1'b0}};
assign AXI_AR_PROG_EMPTY_THRESH = {C_WR_PNTR_WIDTH_RACH{1'b0}};
assign AXI_R_INJECTSBITERR      = 1'b0;
assign AXI_R_INJECTDBITERR      = 1'b0;
assign AXI_R_PROG_FULL_THRESH   = {C_WR_PNTR_WIDTH_RDCH{1'b0}};
assign AXI_R_PROG_EMPTY_THRESH  = {C_WR_PNTR_WIDTH_RDCH{1'b0}};
assign AXIS_INJECTSBITERR       = 1'b0;
assign AXIS_INJECTDBITERR       = 1'b0;
assign AXIS_PROG_FULL_THRESH    = {C_WR_PNTR_WIDTH_AXIS{1'b0}};
assign AXIS_PROG_EMPTY_THRESH   = {C_WR_PNTR_WIDTH_AXIS{1'b0}};
assign SLEEP                    = 1'b0;

////////////////////////////////////////////////////////////////////////////////
// BEGIN RTL
////////////////////////////////////////////////////////////////////////////////

// Both S and M have to be out of reset before fifo will be let out of reset.
assign s_and_m_aresetn_i = S_AXIS_ARESETN & M_AXIS_ARESETN;

generate 
  if (C_FIFO_MODE > 0) begin : gen_fifo_generator
    assign AXIS_DATA_COUNT    = (P_COMMON_CLOCK == 1) ? {{(32-P_FIFO_COUNT_WIDTH){1'b0}}, axis_data_count_i} : AXIS_WR_DATA_COUNT;
    assign AXIS_WR_DATA_COUNT = (P_COMMON_CLOCK == 0) ? {{(32-P_FIFO_COUNT_WIDTH){1'b0}}, axis_wr_data_count_i} : AXIS_DATA_COUNT;
    assign AXIS_RD_DATA_COUNT = (P_COMMON_CLOCK == 0) ? {{(32-P_FIFO_COUNT_WIDTH){1'b0}}, axis_rd_data_count_i} : AXIS_DATA_COUNT;

    axis_interconnect_v1_1_22_util_aclken_converter_wrapper #( 
      .C_TDATA_WIDTH         ( C_AXIS_TDATA_WIDTH     ) ,
      .C_TID_WIDTH           ( C_AXIS_TID_WIDTH       ) ,
      .C_TDEST_WIDTH         ( C_AXIS_TDEST_WIDTH     ) ,
      .C_TUSER_WIDTH         ( C_AXIS_TUSER_WIDTH     ) ,
      .C_S_ACLKEN_CAN_TOGGLE ( LP_S_ACLKEN_CAN_TOGGLE ) ,
      .C_M_ACLKEN_CAN_TOGGLE ( 0                      ) 
    )
    s_util_aclken_converter_wrapper_0 ( 
      .ACLK     ( S_AXIS_ACLK    ) ,
      .ARESETN  ( S_AXIS_ARESETN ) ,
      .S_ACLKEN ( S_AXIS_ACLKEN  ) ,
      .S_VALID  ( S_AXIS_TVALID  ) ,
      .S_READY  ( S_AXIS_TREADY  ) ,
      .S_TDATA  ( S_AXIS_TDATA   ) ,
      .S_TSTRB  ( S_AXIS_TSTRB   ) ,
      .S_TKEEP  ( S_AXIS_TKEEP   ) ,
      .S_TLAST  ( S_AXIS_TLAST   ) ,
      .S_TID    ( S_AXIS_TID     ) ,
      .S_TDEST  ( S_AXIS_TDEST   ) ,
      .S_TUSER  ( S_AXIS_TUSER   ) ,
      .M_ACLKEN ( M_AXIS_ACLKEN  ) ,
      .M_VALID  ( d1_tvalid      ) ,
      .M_READY  ( d1_tready      ) ,
      .M_TDATA  ( d1_tdata       ) ,
      .M_TSTRB  ( d1_tstrb       ) ,
      .M_TKEEP  ( d1_tkeep       ) ,
      .M_TLAST  ( d1_tlast       ) ,
      .M_TID    ( d1_tid         ) ,
      .M_TDEST  ( d1_tdest       ) ,
      .M_TUSER  ( d1_tuser       ) 
    );
    // synthesis xilinx_generatecore
    fifo_generator_v13_2_9 #(
      .C_ADD_NGC_CONSTRAINT                ( 0                          ) ,
      .C_APPLICATION_TYPE_AXIS             ( P_APPLICATION_TYPE_AXIS    ) ,
      .C_APPLICATION_TYPE_RACH             ( 0                          ) ,
      .C_APPLICATION_TYPE_RDCH             ( 0                          ) ,
      .C_APPLICATION_TYPE_WACH             ( 0                          ) ,
      .C_APPLICATION_TYPE_WDCH             ( 0                          ) ,
      .C_APPLICATION_TYPE_WRCH             ( 0                          ) ,
      .C_AXI_ADDR_WIDTH                    ( 32                         ) ,
      .C_AXI_ARUSER_WIDTH                  ( 1                          ) ,
      .C_AXI_AWUSER_WIDTH                  ( 1                          ) ,
      .C_AXI_BUSER_WIDTH                   ( 1                          ) ,
      .C_AXI_DATA_WIDTH                    ( 64                         ) ,
      .C_AXI_ID_WIDTH                      ( 4                          ) ,
      .C_AXI_LEN_WIDTH                     ( 8         ) ,
      .C_AXI_LOCK_WIDTH                    ( 2         ) ,
      .C_AXI_RUSER_WIDTH                   ( 1                          ) ,
      .C_AXIS_TDATA_WIDTH                  ( C_AXIS_TDATA_WIDTH         ) ,
      .C_AXIS_TDEST_WIDTH                  ( C_AXIS_TDEST_WIDTH         ) ,
      .C_AXIS_TID_WIDTH                    ( C_AXIS_TID_WIDTH           ) ,
      .C_AXIS_TKEEP_WIDTH                  ( C_AXIS_TDATA_WIDTH/8       ) ,
      .C_AXIS_TSTRB_WIDTH                  ( C_AXIS_TDATA_WIDTH/8       ) ,
      .C_AXIS_TUSER_WIDTH                  ( C_AXIS_TUSER_WIDTH         ) ,
      .C_AXIS_TYPE                         ( 0                          ) ,
      .C_AXI_TYPE                          ( 0                          ) ,
      .C_AXI_WUSER_WIDTH                   ( 1                          ) ,
      .C_COMMON_CLOCK                      ( P_COMMON_CLOCK             ) ,
      .C_COUNT_TYPE                        ( 0                          ) ,
      .C_DATA_COUNT_WIDTH                  ( 10                         ) ,
      .C_DEFAULT_VALUE                     ( "BlankString"              ) ,
      .C_DIN_WIDTH                         ( 18                         ) ,
      .C_DIN_WIDTH_AXIS                    ( P_AXIS_PAYLOAD_WIDTH       ) ,
      .C_DIN_WIDTH_RACH                    ( 32                         ) ,
      .C_DIN_WIDTH_RDCH                    ( 64                         ) ,
      .C_DIN_WIDTH_WACH                    ( 32                         ) ,
      .C_DIN_WIDTH_WDCH                    ( 64                         ) ,
      .C_DIN_WIDTH_WRCH                    ( 2                          ) ,
      .C_DOUT_RST_VAL                      ( "0"                        ) ,
      .C_DOUT_WIDTH                        ( 18                         ) ,
      .C_ENABLE_RLOCS                      ( 0                          ) ,
      .C_ENABLE_RST_SYNC                   ( 1                          ) ,
      .C_ERROR_INJECTION_TYPE              ( 0                          ) ,
      .C_ERROR_INJECTION_TYPE_AXIS         ( 0                          ) ,
      .C_ERROR_INJECTION_TYPE_RACH         ( 0                          ) ,
      .C_ERROR_INJECTION_TYPE_RDCH         ( 0                          ) ,
      .C_ERROR_INJECTION_TYPE_WACH         ( 0                          ) ,
      .C_ERROR_INJECTION_TYPE_WDCH         ( 0                          ) ,
      .C_ERROR_INJECTION_TYPE_WRCH         ( 0                          ) ,
      .C_FAMILY                            ( C_FAMILY                   ) ,
      .C_FULL_FLAGS_RST_VAL                ( 1                          ) ,
      .C_HAS_ALMOST_EMPTY                  ( 0                          ) ,
      .C_HAS_ALMOST_FULL                   ( 0                          ) ,
      .C_HAS_AXI_ARUSER                    ( 0                          ) ,
      .C_HAS_AXI_AWUSER                    ( 0                          ) ,
      .C_HAS_AXI_BUSER                     ( 0                          ) ,
      .C_HAS_AXI_ID                        ( 0         ) ,
      .C_HAS_AXI_RD_CHANNEL                ( 0                          ) ,
      .C_HAS_AXI_RUSER                     ( 0                          ) ,
      .C_HAS_AXIS_TDATA                    ( P_TDATA_EXISTS             ) ,
      .C_HAS_AXIS_TDEST                    ( P_TDEST_EXISTS             ) ,
      .C_HAS_AXIS_TID                      ( P_TID_EXISTS               ) ,
      .C_HAS_AXIS_TKEEP                    ( P_TKEEP_EXISTS             ) ,
      .C_HAS_AXIS_TLAST                    ( P_TLAST_EXISTS             ) ,
      .C_HAS_AXIS_TREADY                   ( P_TREADY_EXISTS            ) ,
      .C_HAS_AXIS_TSTRB                    ( P_TSTRB_EXISTS             ) ,
      .C_HAS_AXIS_TUSER                    ( P_TUSER_EXISTS             ) ,
      .C_HAS_AXI_WR_CHANNEL                ( 0                          ) ,
      .C_HAS_AXI_WUSER                     ( 0                          ) ,
      .C_HAS_BACKUP                        ( 0                          ) ,
      .C_HAS_DATA_COUNT                    ( 0                          ) ,
      .C_HAS_DATA_COUNTS_AXIS              ( 1                          ) ,
      .C_HAS_DATA_COUNTS_RACH              ( 0                          ) ,
      .C_HAS_DATA_COUNTS_RDCH              ( 0                          ) ,
      .C_HAS_DATA_COUNTS_WACH              ( 0                          ) ,
      .C_HAS_DATA_COUNTS_WDCH              ( 0                          ) ,
      .C_HAS_DATA_COUNTS_WRCH              ( 0                          ) ,
      .C_HAS_INT_CLK                       ( 0                          ) ,
      .C_HAS_MASTER_CE                     ( 0                          ) ,
      .C_HAS_MEMINIT_FILE                  ( 0                          ) ,
      .C_HAS_OVERFLOW                      ( 0                          ) ,
      .C_HAS_PROG_FLAGS_AXIS               ( 0                          ) ,
      .C_HAS_PROG_FLAGS_RACH               ( 0                          ) ,
      .C_HAS_PROG_FLAGS_RDCH               ( 0                          ) ,
      .C_HAS_PROG_FLAGS_WACH               ( 0                          ) ,
      .C_HAS_PROG_FLAGS_WDCH               ( 0                          ) ,
      .C_HAS_PROG_FLAGS_WRCH               ( 0                          ) ,
      .C_HAS_RD_DATA_COUNT                 ( 0                          ) ,
      .C_HAS_RD_RST                        ( 0                          ) ,
      .C_HAS_RST                           ( 1                          ) ,
      .C_HAS_SLAVE_CE                      ( 0                          ) ,
      .C_HAS_SRST                          ( 0                          ) ,
      .C_HAS_UNDERFLOW                     ( 0                          ) ,
      .C_HAS_VALID                         ( 0                          ) ,
      .C_HAS_WR_ACK                        ( 0                          ) ,
      .C_HAS_WR_DATA_COUNT                 ( 0                          ) ,
      .C_HAS_WR_RST                        ( 0                          ) ,
      .C_IMPLEMENTATION_TYPE               ( 0                          ) ,
      .C_IMPLEMENTATION_TYPE_AXIS          ( P_IMPLEMENTATION_TYPE_AXIS ) ,
      .C_IMPLEMENTATION_TYPE_RACH          ( 2                          ) ,
      .C_IMPLEMENTATION_TYPE_RDCH          ( 1                          ) ,
      .C_IMPLEMENTATION_TYPE_WACH          ( 2                          ) ,
      .C_IMPLEMENTATION_TYPE_WDCH          ( 1                          ) ,
      .C_IMPLEMENTATION_TYPE_WRCH          ( 2                          ) ,
      .C_INIT_WR_PNTR_VAL                  ( 0                          ) ,
      .C_INTERFACE_TYPE                    ( 1                          ) ,
      .C_MEMORY_TYPE                       ( 1                          ) ,
      .C_MIF_FILE_NAME                     ( "BlankString"              ) ,
      .C_MSGON_VAL                         ( P_MSGON_VAL                ) ,
      .C_OPTIMIZATION_MODE                 ( 0                          ) ,
      .C_OVERFLOW_LOW                      ( 0                          ) ,
      .C_POWER_SAVING_MODE                 ( 0         ) ,
      .C_PRELOAD_LATENCY                   ( 1                          ) ,
      .C_PRELOAD_REGS                      ( 0                          ) ,
      .C_PRIM_FIFO_TYPE                    ( "4kx4"                     ) ,
      .C_PRIM_FIFO_TYPE_AXIS               ( "512x36"  ) ,
      .C_PRIM_FIFO_TYPE_RACH               ( "512x36"  ) ,
      .C_PRIM_FIFO_TYPE_RDCH               ( "512x36"  ) ,
      .C_PRIM_FIFO_TYPE_WACH               ( "512x36"  ) ,
      .C_PRIM_FIFO_TYPE_WDCH               ( "512x36"  ) ,
      .C_PRIM_FIFO_TYPE_WRCH               ( "512x36"  ) ,
      .C_PROG_EMPTY_THRESH_ASSERT_VAL      ( 2                          ) ,
      .C_PROG_EMPTY_THRESH_ASSERT_VAL_AXIS ( C_FIFO_DEPTH - 2           ) ,
      .C_PROG_EMPTY_THRESH_ASSERT_VAL_RACH ( 14                         ) ,
      .C_PROG_EMPTY_THRESH_ASSERT_VAL_RDCH ( 1022                       ) ,
      .C_PROG_EMPTY_THRESH_ASSERT_VAL_WACH ( 14                         ) ,
      .C_PROG_EMPTY_THRESH_ASSERT_VAL_WDCH ( 1022                       ) ,
      .C_PROG_EMPTY_THRESH_ASSERT_VAL_WRCH ( 14                         ) ,
      .C_PROG_EMPTY_THRESH_NEGATE_VAL      ( 3                          ) ,
      .C_PROG_EMPTY_TYPE                   ( 0                          ) ,
      .C_PROG_EMPTY_TYPE_AXIS              ( 0                          ) ,
      .C_PROG_EMPTY_TYPE_RACH              ( 0                          ) ,
      .C_PROG_EMPTY_TYPE_RDCH              ( 0                          ) ,
      .C_PROG_EMPTY_TYPE_WACH              ( 0                          ) ,
      .C_PROG_EMPTY_TYPE_WDCH              ( 0                          ) ,
      .C_PROG_EMPTY_TYPE_WRCH              ( 0                          ) ,
      .C_PROG_FULL_THRESH_ASSERT_VAL       ( 1022                       ) ,
      .C_PROG_FULL_THRESH_ASSERT_VAL_AXIS  ( C_FIFO_DEPTH - 1           ) ,
      .C_PROG_FULL_THRESH_ASSERT_VAL_RACH  ( 15                         ) ,
      .C_PROG_FULL_THRESH_ASSERT_VAL_RDCH  ( 1023                       ) ,
      .C_PROG_FULL_THRESH_ASSERT_VAL_WACH  ( 15                         ) ,
      .C_PROG_FULL_THRESH_ASSERT_VAL_WDCH  ( 1023                       ) ,
      .C_PROG_FULL_THRESH_ASSERT_VAL_WRCH  ( 15                         ) ,
      .C_PROG_FULL_THRESH_NEGATE_VAL       ( 1021                       ) ,
      .C_PROG_FULL_TYPE                    ( 0                          ) ,
      .C_PROG_FULL_TYPE_AXIS               ( 0                          ) ,
      .C_PROG_FULL_TYPE_RACH               ( 0                          ) ,
      .C_PROG_FULL_TYPE_RDCH               ( 0                          ) ,
      .C_PROG_FULL_TYPE_WACH               ( 0                          ) ,
      .C_PROG_FULL_TYPE_WDCH               ( 0                          ) ,
      .C_PROG_FULL_TYPE_WRCH               ( 0                          ) ,
      .C_RACH_TYPE                         ( 0                          ) ,
      .C_RDCH_TYPE                         ( 0                          ) ,
      .C_RD_DATA_COUNT_WIDTH               ( 10                         ) ,
      .C_RD_DEPTH                          ( 1024                       ) ,
      .C_RD_FREQ                           ( 1                          ) ,
      .C_RD_PNTR_WIDTH                     ( 10                         ) ,
      .C_REG_SLICE_MODE_AXIS               ( 0                          ) ,
      .C_REG_SLICE_MODE_RACH               ( 0                          ) ,
      .C_REG_SLICE_MODE_RDCH               ( 0                          ) ,
      .C_REG_SLICE_MODE_WACH               ( 0                          ) ,
      .C_REG_SLICE_MODE_WDCH               ( 0                          ) ,
      .C_REG_SLICE_MODE_WRCH               ( 0                          ) ,
      .C_SYNCHRONIZER_STAGE                ( C_SYNCHRONIZER_STAGE       ) ,
      .C_UNDERFLOW_LOW                     ( 0                          ) ,
      .C_USE_COMMON_OVERFLOW               ( 0                          ) ,
      .C_USE_COMMON_UNDERFLOW              ( 0                          ) ,
      .C_USE_DEFAULT_SETTINGS              ( 0                          ) ,
      .C_USE_DOUT_RST                      ( 1                          ) ,
      .C_USE_ECC                           ( 0                          ) ,
      .C_USE_ECC_AXIS                      ( 0                          ) ,
      .C_USE_ECC_RACH                      ( 0                          ) ,
      .C_USE_ECC_RDCH                      ( 0                          ) ,
      .C_USE_ECC_WACH                      ( 0                          ) ,
      .C_USE_ECC_WDCH                      ( 0                          ) ,
      .C_USE_ECC_WRCH                      ( 0                          ) ,
      .C_USE_EMBEDDED_REG                  ( 0                          ) ,
      .C_USE_FIFO16_FLAGS                  ( 0                          ) ,
      .C_USE_FWFT_DATA_COUNT               ( 0                          ) ,
      .C_USE_PIPELINE_REG                  ( 0         ) ,
      .C_VALID_LOW                         ( 0                          ) ,
      .C_WACH_TYPE                         ( 0                          ) ,
      .C_WDCH_TYPE                         ( 0                          ) ,
      .C_WR_ACK_LOW                        ( 0                          ) ,
      .C_WRCH_TYPE                         ( 0                          ) ,
      .C_WR_DATA_COUNT_WIDTH               ( 10                         ) ,
      .C_WR_DEPTH                          ( 1024                       ) ,
      .C_WR_DEPTH_AXIS                     ( C_FIFO_DEPTH               ) ,
      .C_WR_DEPTH_RACH                     ( 16                         ) ,
      .C_WR_DEPTH_RDCH                     ( 1024                       ) ,
      .C_WR_DEPTH_WACH                     ( 16                         ) ,
      .C_WR_DEPTH_WDCH                     ( 1024                       ) ,
      .C_WR_DEPTH_WRCH                     ( 16                         ) ,
      .C_WR_FREQ                           ( 1                          ) ,
      .C_WR_PNTR_WIDTH                     ( 10                         ) ,
      .C_WR_PNTR_WIDTH_AXIS                ( P_WR_PNTR_WIDTH            ) ,
      .C_WR_PNTR_WIDTH_RACH                ( 4                          ) ,
      .C_WR_PNTR_WIDTH_RDCH                ( 10                         ) ,
      .C_WR_PNTR_WIDTH_WACH                ( 4                          ) ,
      .C_WR_PNTR_WIDTH_WDCH                ( 10                         ) ,
      .C_WR_PNTR_WIDTH_WRCH                ( 4                          ) ,
      .C_WR_RESPONSE_LATENCY               ( 1                          )
    )
    fifo_generator_inst (
      .almost_empty             ( ALMOST_EMPTY             ) ,
      .almost_full              ( ALMOST_FULL              ) ,
      .axi_ar_data_count        ( AXI_AR_DATA_COUNT        ) ,
      .axi_ar_dbiterr           ( AXI_AR_DBITERR           ) ,
      .axi_ar_injectdbiterr     ( AXI_AR_INJECTDBITERR     ) ,
      .axi_ar_injectsbiterr     ( AXI_AR_INJECTSBITERR     ) ,
      .axi_ar_overflow          ( AXI_AR_OVERFLOW          ) ,
      .axi_ar_prog_empty        ( AXI_AR_PROG_EMPTY        ) ,
      .axi_ar_prog_empty_thresh ( AXI_AR_PROG_EMPTY_THRESH ) ,
      .axi_ar_prog_full         ( AXI_AR_PROG_FULL         ) ,
      .axi_ar_prog_full_thresh  ( AXI_AR_PROG_FULL_THRESH  ) ,
      .axi_ar_rd_data_count     ( AXI_AR_RD_DATA_COUNT     ) ,
      .axi_ar_sbiterr           ( AXI_AR_SBITERR           ) ,
      .axi_ar_underflow         ( AXI_AR_UNDERFLOW         ) ,
      .axi_ar_wr_data_count     ( AXI_AR_WR_DATA_COUNT     ) ,
      .axi_aw_data_count        ( AXI_AW_DATA_COUNT        ) ,
      .axi_aw_dbiterr           ( AXI_AW_DBITERR           ) ,
      .axi_aw_injectdbiterr     ( AXI_AW_INJECTDBITERR     ) ,
      .axi_aw_injectsbiterr     ( AXI_AW_INJECTSBITERR     ) ,
      .axi_aw_overflow          ( AXI_AW_OVERFLOW          ) ,
      .axi_aw_prog_empty        ( AXI_AW_PROG_EMPTY        ) ,
      .axi_aw_prog_empty_thresh ( AXI_AW_PROG_EMPTY_THRESH ) ,
      .axi_aw_prog_full         ( AXI_AW_PROG_FULL         ) ,
      .axi_aw_prog_full_thresh  ( AXI_AW_PROG_FULL_THRESH  ) ,
      .axi_aw_rd_data_count     ( AXI_AW_RD_DATA_COUNT     ) ,
      .axi_aw_sbiterr           ( AXI_AW_SBITERR           ) ,
      .axi_aw_underflow         ( AXI_AW_UNDERFLOW         ) ,
      .axi_aw_wr_data_count     ( AXI_AW_WR_DATA_COUNT     ) ,
      .axi_b_data_count         ( AXI_B_DATA_COUNT         ) ,
      .axi_b_dbiterr            ( AXI_B_DBITERR            ) ,
      .axi_b_injectdbiterr      ( AXI_B_INJECTDBITERR      ) ,
      .axi_b_injectsbiterr      ( AXI_B_INJECTSBITERR      ) ,
      .axi_b_overflow           ( AXI_B_OVERFLOW           ) ,
      .axi_b_prog_empty         ( AXI_B_PROG_EMPTY         ) ,
      .axi_b_prog_empty_thresh  ( AXI_B_PROG_EMPTY_THRESH  ) ,
      .axi_b_prog_full          ( AXI_B_PROG_FULL          ) ,
      .axi_b_prog_full_thresh   ( AXI_B_PROG_FULL_THRESH   ) ,
      .axi_b_rd_data_count      ( AXI_B_RD_DATA_COUNT      ) ,
      .axi_b_sbiterr            ( AXI_B_SBITERR            ) ,
      .axi_b_underflow          ( AXI_B_UNDERFLOW          ) ,
      .axi_b_wr_data_count      ( AXI_B_WR_DATA_COUNT      ) ,
      .axi_r_data_count         ( AXI_R_DATA_COUNT         ) ,
      .axi_r_dbiterr            ( AXI_R_DBITERR            ) ,
      .axi_r_injectdbiterr      ( AXI_R_INJECTDBITERR      ) ,
      .axi_r_injectsbiterr      ( AXI_R_INJECTSBITERR      ) ,
      .axi_r_overflow           ( AXI_R_OVERFLOW           ) ,
      .axi_r_prog_empty         ( AXI_R_PROG_EMPTY         ) ,
      .axi_r_prog_empty_thresh  ( AXI_R_PROG_EMPTY_THRESH  ) ,
      .axi_r_prog_full          ( AXI_R_PROG_FULL          ) ,
      .axi_r_prog_full_thresh   ( AXI_R_PROG_FULL_THRESH   ) ,
      .axi_r_rd_data_count      ( AXI_R_RD_DATA_COUNT      ) ,
      .axi_r_sbiterr            ( AXI_R_SBITERR            ) ,
      .axi_r_underflow          ( AXI_R_UNDERFLOW          ) ,
      .axi_r_wr_data_count      ( AXI_R_WR_DATA_COUNT      ) ,
      .axis_data_count          ( axis_data_count_i        ) ,
      .axis_dbiterr             ( AXIS_DBITERR             ) ,
      .axis_injectdbiterr       ( AXIS_INJECTDBITERR       ) ,
      .axis_injectsbiterr       ( AXIS_INJECTSBITERR       ) ,
      .axis_overflow            ( AXIS_OVERFLOW            ) ,
      .axis_prog_empty          ( AXIS_PROG_EMPTY          ) ,
      .axis_prog_empty_thresh   ( AXIS_PROG_EMPTY_THRESH   ) ,
      .axis_prog_full           ( AXIS_PROG_FULL           ) ,
      .axis_prog_full_thresh    ( AXIS_PROG_FULL_THRESH    ) ,
      .axis_rd_data_count       ( axis_rd_data_count_i     ) ,
      .axis_sbiterr             ( AXIS_SBITERR             ) ,
      .axis_underflow           ( AXIS_UNDERFLOW           ) ,
      .axis_wr_data_count       ( axis_wr_data_count_i     ) ,
      .axi_w_data_count         ( AXI_W_DATA_COUNT         ) ,
      .axi_w_dbiterr            ( AXI_W_DBITERR            ) ,
      .axi_w_injectdbiterr      ( AXI_W_INJECTDBITERR      ) ,
      .axi_w_injectsbiterr      ( AXI_W_INJECTSBITERR      ) ,
      .axi_w_overflow           ( AXI_W_OVERFLOW           ) ,
      .axi_w_prog_empty         ( AXI_W_PROG_EMPTY         ) ,
      .axi_w_prog_empty_thresh  ( AXI_W_PROG_EMPTY_THRESH  ) ,
      .axi_w_prog_full          ( AXI_W_PROG_FULL          ) ,
      .axi_w_prog_full_thresh   ( AXI_W_PROG_FULL_THRESH   ) ,
      .axi_w_rd_data_count      ( AXI_W_RD_DATA_COUNT      ) ,
      .axi_w_sbiterr            ( AXI_W_SBITERR            ) ,
      .axi_w_underflow          ( AXI_W_UNDERFLOW          ) ,
      .axi_w_wr_data_count      ( AXI_W_WR_DATA_COUNT      ) ,
      .backup                   ( BACKUP                   ) ,
      .backup_marker            ( BACKUP_MARKER            ) ,
      .clk                      ( CLK                      ) ,
      .data_count               ( DATA_COUNT               ) ,
      .dbiterr                  ( DBITERR                  ) ,
      .din                      ( DIN                      ) ,
      .dout                     ( DOUT                     ) ,
      .empty                    ( EMPTY                    ) ,
      .full                     ( FULL                     ) ,
      .injectdbiterr            ( INJECTDBITERR            ) ,
      .injectsbiterr            ( INJECTSBITERR            ) ,
      .int_clk                  ( INT_CLK                  ) ,
      .m_aclk_en                ( M_ACLK_EN                ) ,
      .m_aclk                   ( M_AXIS_ACLK              ) ,
      .m_axi_araddr             ( M_AXI_ARADDR             ) ,
      .m_axi_arburst            ( M_AXI_ARBURST            ) ,
      .m_axi_arcache            ( M_AXI_ARCACHE            ) ,
      .m_axi_arid               ( M_AXI_ARID               ) ,
      .m_axi_arlen              ( M_AXI_ARLEN              ) ,
      .m_axi_arlock             ( M_AXI_ARLOCK             ) ,
      .m_axi_arprot             ( M_AXI_ARPROT             ) ,
      .m_axi_arqos              ( M_AXI_ARQOS              ) ,
      .m_axi_arready            ( M_AXI_ARREADY            ) ,
      .m_axi_arregion           ( M_AXI_ARREGION           ) ,
      .m_axi_arsize             ( M_AXI_ARSIZE             ) ,
      .m_axi_aruser             ( M_AXI_ARUSER             ) ,
      .m_axi_arvalid            ( M_AXI_ARVALID            ) ,
      .m_axi_awaddr             ( M_AXI_AWADDR             ) ,
      .m_axi_awburst            ( M_AXI_AWBURST            ) ,
      .m_axi_awcache            ( M_AXI_AWCACHE            ) ,
      .m_axi_awid               ( M_AXI_AWID               ) ,
      .m_axi_awlen              ( M_AXI_AWLEN              ) ,
      .m_axi_awlock             ( M_AXI_AWLOCK             ) ,
      .m_axi_awprot             ( M_AXI_AWPROT             ) ,
      .m_axi_awqos              ( M_AXI_AWQOS              ) ,
      .m_axi_awready            ( M_AXI_AWREADY            ) ,
      .m_axi_awregion           ( M_AXI_AWREGION           ) ,
      .m_axi_awsize             ( M_AXI_AWSIZE             ) ,
      .m_axi_awuser             ( M_AXI_AWUSER             ) ,
      .m_axi_awvalid            ( M_AXI_AWVALID            ) ,
      .m_axi_bid                ( M_AXI_BID                ) ,
      .m_axi_bready             ( M_AXI_BREADY             ) ,
      .m_axi_bresp              ( M_AXI_BRESP              ) ,
      .m_axi_buser              ( M_AXI_BUSER              ) ,
      .m_axi_bvalid             ( M_AXI_BVALID             ) ,
      .m_axi_rdata              ( M_AXI_RDATA              ) ,
      .m_axi_rid                ( M_AXI_RID                ) ,
      .m_axi_rlast              ( M_AXI_RLAST              ) ,
      .m_axi_rready             ( M_AXI_RREADY             ) ,
      .m_axi_rresp              ( M_AXI_RRESP              ) ,
      .m_axi_ruser              ( M_AXI_RUSER              ) ,
      .m_axi_rvalid             ( M_AXI_RVALID             ) ,
      .m_axis_tdata             ( d2_tdata                 ) ,
      .m_axis_tdest             ( d2_tdest                 ) ,
      .m_axis_tid               ( d2_tid                   ) ,
      .m_axis_tkeep             ( d2_tkeep                 ) ,
      .m_axis_tlast             ( d2_tlast                 ) ,
      .m_axis_tready            ( d2_tready                ) ,
      .m_axis_tstrb             ( d2_tstrb                 ) ,
      .m_axis_tuser             ( d2_tuser                 ) ,
      .m_axis_tvalid            ( d2_tvalid                ) ,
      .m_axi_wdata              ( M_AXI_WDATA              ) ,
      .m_axi_wid                ( M_AXI_WID                ) ,
      .m_axi_wlast              ( M_AXI_WLAST              ) ,
      .m_axi_wready             ( M_AXI_WREADY             ) ,
      .m_axi_wstrb              ( M_AXI_WSTRB              ) ,
      .m_axi_wuser              ( M_AXI_WUSER              ) ,
      .m_axi_wvalid             ( M_AXI_WVALID             ) ,
      .overflow                 ( OVERFLOW                 ) ,
      .prog_empty               ( PROG_EMPTY               ) ,
      .prog_empty_thresh_assert ( PROG_EMPTY_THRESH_ASSERT ) ,
      .prog_empty_thresh_negate ( PROG_EMPTY_THRESH_NEGATE ) ,
      .prog_empty_thresh        ( PROG_EMPTY_THRESH        ) ,
      .prog_full                ( PROG_FULL                ) ,
      .prog_full_thresh_assert  ( PROG_FULL_THRESH_ASSERT  ) ,
      .prog_full_thresh_negate  ( PROG_FULL_THRESH_NEGATE  ) ,
      .prog_full_thresh         ( PROG_FULL_THRESH         ) ,
      .rd_clk                   ( RD_CLK                   ) ,
      .rd_data_count            ( RD_DATA_COUNT            ) ,
      .rd_en                    ( RD_EN                    ) ,
      .rd_rst_busy              ( RD_RST_BUSY              ) ,
      .rd_rst                   ( RD_RST                   ) ,
      .rst                      ( RST                      ) ,
      .s_aclk_en                ( S_ACLK_EN                ) ,
      .s_aclk                   ( S_AXIS_ACLK              ) ,
      .s_aresetn                ( s_and_m_aresetn_i        ) ,
      .s_axi_araddr             ( S_AXI_ARADDR             ) ,
      .s_axi_arburst            ( S_AXI_ARBURST            ) ,
      .s_axi_arcache            ( S_AXI_ARCACHE            ) ,
      .s_axi_arid               ( S_AXI_ARID               ) ,
      .s_axi_arlen              ( S_AXI_ARLEN              ) ,
      .s_axi_arlock             ( S_AXI_ARLOCK             ) ,
      .s_axi_arprot             ( S_AXI_ARPROT             ) ,
      .s_axi_arqos              ( S_AXI_ARQOS              ) ,
      .s_axi_arready            ( S_AXI_ARREADY            ) ,
      .s_axi_arregion           ( S_AXI_ARREGION           ) ,
      .s_axi_arsize             ( S_AXI_ARSIZE             ) ,
      .s_axi_aruser             ( S_AXI_ARUSER             ) ,
      .s_axi_arvalid            ( S_AXI_ARVALID            ) ,
      .s_axi_awaddr             ( S_AXI_AWADDR             ) ,
      .s_axi_awburst            ( S_AXI_AWBURST            ) ,
      .s_axi_awcache            ( S_AXI_AWCACHE            ) ,
      .s_axi_awid               ( S_AXI_AWID               ) ,
      .s_axi_awlen              ( S_AXI_AWLEN              ) ,
      .s_axi_awlock             ( S_AXI_AWLOCK             ) ,
      .s_axi_awprot             ( S_AXI_AWPROT             ) ,
      .s_axi_awqos              ( S_AXI_AWQOS              ) ,
      .s_axi_awready            ( S_AXI_AWREADY            ) ,
      .s_axi_awregion           ( S_AXI_AWREGION           ) ,
      .s_axi_awsize             ( S_AXI_AWSIZE             ) ,
      .s_axi_awuser             ( S_AXI_AWUSER             ) ,
      .s_axi_awvalid            ( S_AXI_AWVALID            ) ,
      .s_axi_bid                ( S_AXI_BID                ) ,
      .s_axi_bready             ( S_AXI_BREADY             ) ,
      .s_axi_bresp              ( S_AXI_BRESP              ) ,
      .s_axi_buser              ( S_AXI_BUSER              ) ,
      .s_axi_bvalid             ( S_AXI_BVALID             ) ,
      .s_axi_rdata              ( S_AXI_RDATA              ) ,
      .s_axi_rid                ( S_AXI_RID                ) ,
      .s_axi_rlast              ( S_AXI_RLAST              ) ,
      .s_axi_rready             ( S_AXI_RREADY             ) ,
      .s_axi_rresp              ( S_AXI_RRESP              ) ,
      .s_axi_ruser              ( S_AXI_RUSER              ) ,
      .s_axi_rvalid             ( S_AXI_RVALID             ) ,
      .s_axis_tdata             ( d1_tdata                 ) ,
      .s_axis_tdest             ( d1_tdest                 ) ,
      .s_axis_tid               ( d1_tid                   ) ,
      .s_axis_tkeep             ( d1_tkeep                 ) ,
      .s_axis_tlast             ( d1_tlast                 ) ,
      .s_axis_tready            ( d1_tready                ) ,
      .s_axis_tstrb             ( d1_tstrb                 ) ,
      .s_axis_tuser             ( d1_tuser                 ) ,
      .s_axis_tvalid            ( d1_tvalid                ) ,
      .s_axi_wdata              ( S_AXI_WDATA              ) ,
      .s_axi_wid                ( S_AXI_WID                ) ,
      .s_axi_wlast              ( S_AXI_WLAST              ) ,
      .s_axi_wready             ( S_AXI_WREADY             ) ,
      .s_axi_wstrb              ( S_AXI_WSTRB              ) ,
      .s_axi_wuser              ( S_AXI_WUSER              ) ,
      .s_axi_wvalid             ( S_AXI_WVALID             ) ,
      .sbiterr                  ( SBITERR                  ) ,
      .sleep                    ( SLEEP                    ) ,
      .srst                     ( SRST                     ) ,
      .underflow                ( UNDERFLOW                ) ,
      .valid                    ( VALID                    ) ,
      .wr_ack                   ( WR_ACK                   ) ,
      .wr_clk                   ( WR_CLK                   ) ,
      .wr_data_count            ( WR_DATA_COUNT            ) ,
      .wr_en                    ( WR_EN                    ) ,
      .wr_rst_busy              ( WR_RST_BUSY              ) ,
      .wr_rst                   ( WR_RST                   ) 
    );

    axis_interconnect_v1_1_22_util_aclken_converter_wrapper #( 
      .C_TDATA_WIDTH         ( C_AXIS_TDATA_WIDTH     ) ,
      .C_TID_WIDTH           ( C_AXIS_TID_WIDTH       ) ,
      .C_TDEST_WIDTH         ( C_AXIS_TDEST_WIDTH     ) ,
      .C_TUSER_WIDTH         ( C_AXIS_TUSER_WIDTH     ) ,
      .C_S_ACLKEN_CAN_TOGGLE (                      0 ) ,
      .C_M_ACLKEN_CAN_TOGGLE ( LP_M_ACLKEN_CAN_TOGGLE )
    )
    m_util_aclken_converter_wrapper_0 ( 
      .ACLK     ( M_AXIS_ACLK    ) ,
      .ARESETN  ( M_AXIS_ARESETN ) ,
      .S_ACLKEN ( S_AXIS_ACLKEN  ) ,
      .S_VALID  ( d2_tvalid      ) ,
      .S_READY  ( d2_tready      ) ,
      .S_TDATA  ( d2_tdata       ) ,
      .S_TSTRB  ( d2_tstrb       ) ,
      .S_TKEEP  ( d2_tkeep       ) ,
      .S_TLAST  ( d2_tlast       ) ,
      .S_TID    ( d2_tid         ) ,
      .S_TDEST  ( d2_tdest       ) ,
      .S_TUSER  ( d2_tuser       ) ,
      .M_ACLKEN ( M_AXIS_ACLKEN  ) ,
      .M_VALID  ( M_AXIS_TVALID  ) ,
      .M_READY  ( (C_AXIS_SIGNAL_SET[0] == 0) ? 1'b1 : M_AXIS_TREADY  ) ,
      .M_TDATA  ( M_AXIS_TDATA   ) ,
      .M_TSTRB  ( M_AXIS_TSTRB   ) ,
      .M_TKEEP  ( M_AXIS_TKEEP   ) ,
      .M_TLAST  ( M_AXIS_TLAST   ) ,
      .M_TID    ( M_AXIS_TID     ) ,
      .M_TDEST  ( M_AXIS_TDEST   ) ,
      .M_TUSER  ( M_AXIS_TUSER   )  
    );
  end
  else begin : gen_fifo_passthru
    assign S_AXIS_TREADY   = (C_AXIS_SIGNAL_SET[0] == 0) ? 1'b1 : M_AXIS_TREADY ;
    assign M_AXIS_TVALID   = S_AXIS_TVALID ;
    assign M_AXIS_TDATA    = S_AXIS_TDATA  ;
    assign M_AXIS_TSTRB    = S_AXIS_TSTRB  ;
    assign M_AXIS_TKEEP    = S_AXIS_TKEEP  ;
    assign M_AXIS_TLAST    = S_AXIS_TLAST  ;
    assign M_AXIS_TID      = S_AXIS_TID    ;
    assign M_AXIS_TDEST    = S_AXIS_TDEST  ;
    assign M_AXIS_TUSER    = S_AXIS_TUSER  ;
    assign AXIS_DATA_COUNT = 32'b0;
    assign AXIS_WR_DATA_COUNT = 32'b0;
    assign AXIS_RD_DATA_COUNT = 32'b0;
  end
endgenerate

endmodule // axis_data_fifo



// (c) Copyright 2011-2012, 2023 Advanced Micro Devices, Inc. All rights reserved.
//
// This file contains confidential and proprietary information
// of AMD and is protected under U.S. and international copyright
// and other intellectual property laws.
//
// DISCLAIMER
// This disclaimer is not a license and does not grant any
// rights to the materials distributed herewith. Except as
// otherwise provided in a valid license issued to you by
// AMD, and to the maximum extent permitted by applicable
// law: (1) THESE MATERIALS ARE MADE AVAILABLE "AS IS" AND
// WITH ALL FAULTS, AND AMD HEREBY DISCLAIMS ALL WARRANTIES
// AND CONDITIONS, EXPRESS, IMPLIED, OR STATUTORY, INCLUDING
// BUT NOT LIMITED TO WARRANTIES OF MERCHANTABILITY, NON-
// INFRINGEMENT, OR FITNESS FOR ANY PARTICULAR PURPOSE; and
// (2) AMD shall not be liable (whether in contract or tort,
// including negligence, or under any other theory of
// liability) for any loss or damage of any kind or nature
// related to, arising under or in connection with these
// materials, including for any direct, or any indirect,
// special, incidental, or consequential loss or damage
// (including loss of data, profits, goodwill, or any type of
// loss or damage suffered as a result of any action brought
// by a third party) even if such damage or loss was
// reasonably foreseeable or AMD had been advised of the
// possibility of the same.
//
// CRITICAL APPLICATIONS
// AMD products are not designed or intended to be fail-
// safe, or for use in any application requiring fail-safe
// performance, such as life-support or safety devices or
// systems, Class III medical devices, nuclear facilities,
// applications related to the deployment of airbags, or any
// other applications that could lead to death, personal
// injury, or severe property or environmental damage
// (individually and collectively, "Critical
// Applications"). Customer assumes the sole risk and
// liability of any use of AMD products in Critical
// Applications, subject only to applicable laws and
// regulations governing limitations on product liability.
//
// THIS COPYRIGHT NOTICE AND DISCLAIMER MUST BE RETAINED AS
// PART OF THIS FILE AT ALL TIMES.
////////////////////////////////////////////////////////////
//
//
// Verilog-standard:  Verilog 2001
//--------------------------------------------------------------------------
//
// Structure:
//   arb_rr
//
//--------------------------------------------------------------------------

`timescale 1ps/1ps
`default_nettype none

module axis_interconnect_v1_1_22_arb_rr #
(
///////////////////////////////////////////////////////////////////////////////
// Parameter Definitions
///////////////////////////////////////////////////////////////////////////////
   parameter         C_FAMILY        = "virtex7",
   parameter integer C_NUM_SI_SLOTS  = 8,
   parameter integer C_LOG_SI_SLOTS  = 3,
   parameter         C_ARB_ALGORITHM = "ROUND_ROBIN"
)
(
///////////////////////////////////////////////////////////////////////////////
// Port Declarations
///////////////////////////////////////////////////////////////////////////////
   // System Signals
   input wire ACLK,
   input wire ARESET,
   input wire ACLKEN,

   input  wire [C_NUM_SI_SLOTS-1:0] ARB_REQ,
   input  wire                      ARB_DONE, 
   output wire [C_NUM_SI_SLOTS-1:0] ARB_GNT,
   output wire [C_LOG_SI_SLOTS-1:0] ARB_SEL
);

////////////////////////////////////////////////////////////////////////////////
// Functions
////////////////////////////////////////////////////////////////////////////////
function [C_NUM_SI_SLOTS*C_LOG_SI_SLOTS-1:0] f_port_priority_init (
  input integer num_slaves
);
  begin : main
    integer i;
    for (i = 0; i < num_slaves; i = i + 1) begin
      f_port_priority_init[i*C_LOG_SI_SLOTS+:C_LOG_SI_SLOTS] = i[C_LOG_SI_SLOTS-1:0];
    end
  end
endfunction

////////////////////////////////////////////////////////////////////////////////
// Local parameters
////////////////////////////////////////////////////////////////////////////////

////////////////////////////////////////////////////////////////////////////////
// Wires/Reg declarations
////////////////////////////////////////////////////////////////////////////////
wire                                     arb_busy_ns;
reg                                      arb_busy_r;

wire                                     advance;
wire [C_LOG_SI_SLOTS-1:0]                barrel_cntr_ns;
reg  [C_LOG_SI_SLOTS-1:0]                barrel_cntr;
wire [C_NUM_SI_SLOTS-1:0]                arb_req_rot;
wire [C_NUM_SI_SLOTS-1:0]                arb_req_i;
reg  [C_NUM_SI_SLOTS*C_LOG_SI_SLOTS-1:0] port_priority_r;
wire [C_NUM_SI_SLOTS*C_LOG_SI_SLOTS-1:0] port_priority_ns;
wire [C_LOG_SI_SLOTS-1:0]                sel_i;
wire                                     valid_i; 

wire [C_LOG_SI_SLOTS-1:0]                arb_sel_ns;
reg  [C_LOG_SI_SLOTS-1:0]                arb_sel_r;

wire [C_NUM_SI_SLOTS-1:0]                sel_decode_i;
wire [C_NUM_SI_SLOTS-1:0]                arb_gnt_ns;
reg  [C_NUM_SI_SLOTS-1:0]                arb_gnt_r;
////////////////////////////////////////////////////////////////////////////////
// BEGIN RTL
////////////////////////////////////////////////////////////////////////////////

// Generate busy logic.  When arbiter is busy a new REQ can't be granted and
// priority will not advance.
assign arb_busy_ns = (valid_i) | (arb_busy_r & ~ARB_DONE);

always @(posedge ACLK) begin 
  if (ARESET) begin
    arb_busy_r <= 1'b0;
  end
  else if (ACLKEN) begin
    arb_busy_r <= arb_busy_ns;
  end
end

assign advance = ~arb_busy_r | (|arb_gnt_r);

assign barrel_cntr_ns = (barrel_cntr == C_NUM_SI_SLOTS-1) ? {C_LOG_SI_SLOTS{1'b0}} : barrel_cntr + 1'b1 ; 

always @(posedge ACLK) begin
  if (ARESET) begin
    barrel_cntr <= {C_LOG_SI_SLOTS{1'b0}};
  end
  else if (ACLKEN && C_ARB_ALGORITHM == "ROUND_ROBIN") begin
    barrel_cntr <= advance ? barrel_cntr_ns : barrel_cntr;
  end
end

assign arb_req_i = ARB_REQ & ~arb_gnt_r;
assign arb_req_rot[C_NUM_SI_SLOTS-1:0] = {arb_req_i, arb_req_i} >> barrel_cntr;

// Port Priority implements round robin arbitration
always @(posedge ACLK) begin
  if (ARESET) begin
    port_priority_r <= f_port_priority_init(C_NUM_SI_SLOTS);
  end
  else if (ACLKEN && (C_ARB_ALGORITHM == "ROUND_ROBIN")) begin
    port_priority_r <= advance ? port_priority_ns : port_priority_r;
  end
end

assign port_priority_ns[0+:(C_NUM_SI_SLOTS-1)*C_LOG_SI_SLOTS] = 
         port_priority_r[1*C_LOG_SI_SLOTS+:(C_NUM_SI_SLOTS-1)*C_LOG_SI_SLOTS];
assign port_priority_ns[(C_NUM_SI_SLOTS-1)*C_LOG_SI_SLOTS+:C_LOG_SI_SLOTS] = port_priority_r[0+:C_LOG_SI_SLOTS];

axis_interconnect_v1_1_22_dynamic_priority_encoder #(
  .C_FAMILY    ( C_FAMILY       ) ,
  .C_REQ_WIDTH ( C_NUM_SI_SLOTS ) ,
  .C_ENC_WIDTH ( C_LOG_SI_SLOTS ) 
)
dynamic_priority_encoder_0
(
  .REQ           ( arb_req_rot     ) ,
  .PORT_PRIORITY ( port_priority_r ) ,
  .SEL           ( sel_i           ) ,
  .VALID         ( valid_i         ) 
);

assign arb_sel_ns = valid_i & (~arb_busy_r | ARB_DONE) ? sel_i : arb_sel_r;

always @(posedge ACLK) begin 
  if (ARESET) begin
    arb_sel_r <= {C_LOG_SI_SLOTS{1'b0}};
  end
  else if (ACLKEN) begin
    arb_sel_r <= arb_sel_ns;
  end
end

assign ARB_SEL = arb_sel_r;

// Decode sel from integer to one-hot
generate
  genvar i;
  for (i = 0; i < C_NUM_SI_SLOTS; i = i + 1) begin : gen_sel_decode_one_hot
    assign sel_decode_i[i] = (i == sel_i); 
  end
endgenerate

assign arb_gnt_ns = valid_i & (~arb_busy_r | ARB_DONE) ? sel_decode_i : {C_LOG_SI_SLOTS{1'b0}};

always @(posedge ACLK) begin 
  if (ARESET) begin
    arb_gnt_r <= {C_LOG_SI_SLOTS{1'b0}};
  end
  else if (ACLKEN) begin
    arb_gnt_r <= arb_gnt_ns;
  end
end

assign ARB_GNT = arb_gnt_r;

endmodule // arb_rr

`default_nettype wire


// (c) Copyright 2011-2012, 2023 Advanced Micro Devices, Inc. All rights reserved.
//
// This file contains confidential and proprietary information
// of AMD and is protected under U.S. and international copyright
// and other intellectual property laws.
//
// DISCLAIMER
// This disclaimer is not a license and does not grant any
// rights to the materials distributed herewith. Except as
// otherwise provided in a valid license issued to you by
// AMD, and to the maximum extent permitted by applicable
// law: (1) THESE MATERIALS ARE MADE AVAILABLE "AS IS" AND
// WITH ALL FAULTS, AND AMD HEREBY DISCLAIMS ALL WARRANTIES
// AND CONDITIONS, EXPRESS, IMPLIED, OR STATUTORY, INCLUDING
// BUT NOT LIMITED TO WARRANTIES OF MERCHANTABILITY, NON-
// INFRINGEMENT, OR FITNESS FOR ANY PARTICULAR PURPOSE; and
// (2) AMD shall not be liable (whether in contract or tort,
// including negligence, or under any other theory of
// liability) for any loss or damage of any kind or nature
// related to, arising under or in connection with these
// materials, including for any direct, or any indirect,
// special, incidental, or consequential loss or damage
// (including loss of data, profits, goodwill, or any type of
// loss or damage suffered as a result of any action brought
// by a third party) even if such damage or loss was
// reasonably foreseeable or AMD had been advised of the
// possibility of the same.
//
// CRITICAL APPLICATIONS
// AMD products are not designed or intended to be fail-
// safe, or for use in any application requiring fail-safe
// performance, such as life-support or safety devices or
// systems, Class III medical devices, nuclear facilities,
// applications related to the deployment of airbags, or any
// other applications that could lead to death, personal
// injury, or severe property or environmental damage
// (individually and collectively, "Critical
// Applications"). Customer assumes the sole risk and
// liability of any use of AMD products in Critical
// Applications, subject only to applicable laws and
// regulations governing limitations on product liability.
//
// THIS COPYRIGHT NOTICE AND DISCLAIMER MUST BE RETAINED AS
// PART OF THIS FILE AT ALL TIMES.
////////////////////////////////////////////////////////////
//
//
// Verilog-standard:  Verilog 2001
//--------------------------------------------------------------------------
//
// Structure:
//   axisc_decoder
//
//--------------------------------------------------------------------------

`timescale 1ps/1ps
`default_nettype none

module axis_interconnect_v1_1_22_axisc_decoder #
(
///////////////////////////////////////////////////////////////////////////////
// Parameter Definitions
///////////////////////////////////////////////////////////////////////////////
   parameter         C_FAMILY           = "virtex7",
   parameter integer C_AXIS_TDATA_WIDTH = 32,
   parameter integer C_AXIS_TID_WIDTH   = 1,
   parameter integer C_AXIS_TDEST_WIDTH = 1,
   parameter integer C_AXIS_TUSER_WIDTH = 1,
   parameter [31:0]  C_AXIS_SIGNAL_SET  = 32'hFF,
   // C_AXIS_SIGNAL_SET: each bit if enabled specifies which axis optional signals are present
   //   [0] => TREADY present
   //   [1] => TDATA present
   //   [2] => TSTRB present, TDATA must be present
   //   [3] => TKEEP present, TDATA must be present
   //   [4] => TLAST present
   //   [5] => TID present
   //   [6] => TDEST present
   //   [7] => TUSER present
   parameter integer C_TPAYLOAD_WIDTH  = 44,
   parameter integer C_NUM_MI_SLOTS    = 1,
   parameter integer C_USE_PACKET_MODE = 1,
   // C_USE_PACKET_MODE: Indicates to monitor TLAST to signal ARB_DONE
   parameter integer C_REG_CONFIG      = 1, 
   // C_REG_CONFIG: Registers payload and ARB_REQ signal
   //   0 => BYPASS    = The channel is just wired through the module.
   //   1 => FWD_REV   = Both FWD and REV (fully-registered)
   //   2 => FWD       = The master VALID and payload signals are registrated. 
   //   3 => REV       = The slave ready signal is registrated
   //   4 => RESERVED (all outputs driven to 0).
   //   5 => RESERVED (all outputs driven to 0).
   //   6 => INPUTS    = Slave and Master side inputs are registrated.
   //   7 => LIGHT_WT  = 1-stage pipeline register with bubble cycle, both FWD and REV pipelining
   //   8 => ARB_REQ only = No register on incoming signals.  Only a register
   //   on ARB_REQ output. (Causes bubble cycles) Throughput is halved.
   parameter [C_NUM_MI_SLOTS-1:0] C_CONNECTIVITY = {C_NUM_MI_SLOTS{1'b1}},
   // Specifies connectivity matrix for sparse crossbar configurations
   parameter [C_NUM_MI_SLOTS*C_AXIS_TDEST_WIDTH-1:0] C_BASETDEST = {C_NUM_MI_SLOTS*C_AXIS_TDEST_WIDTH{1'b1}},
   // Array of TDEST base/high pairs for each master interface
   parameter [C_NUM_MI_SLOTS*C_AXIS_TDEST_WIDTH-1:0] C_HIGHTDEST = {C_NUM_MI_SLOTS*C_AXIS_TDEST_WIDTH{1'b0}}
)
(
///////////////////////////////////////////////////////////////////////////////
// Port Declarations
///////////////////////////////////////////////////////////////////////////////
   // System Signals
   input wire ACLK,
   input wire ARESET,
   input wire ACLKEN,

   // Slave side
   input  wire                          S_AXIS_TVALID,
   output wire                          S_AXIS_TREADY,
   input  wire [C_TPAYLOAD_WIDTH-1:0]   S_AXIS_TPAYLOAD,
   input  wire [C_AXIS_TDEST_WIDTH-1:0] S_AXIS_TDEST,

   // Master side
   output wire [C_NUM_MI_SLOTS-1:0]     M_AXIS_TVALID,
   input  wire [C_NUM_MI_SLOTS-1:0]     M_AXIS_TREADY,
   output wire [C_TPAYLOAD_WIDTH-1:0]   M_AXIS_TPAYLOAD,

   // ARBITER Side
   output wire                          ARB_LAST,
   output wire [C_AXIS_TID_WIDTH-1:0]   ARB_ID,
   output wire [C_AXIS_TDEST_WIDTH-1:0] ARB_DEST,
   output wire [C_AXIS_TUSER_WIDTH-1:0] ARB_USER,
   output wire [C_NUM_MI_SLOTS-1:0]     ARB_REQ,
   input  wire [C_NUM_MI_SLOTS-1:0]     ARB_DONE,
   input  wire [C_NUM_MI_SLOTS-1:0]     ARB_GNT,
   output wire [C_NUM_MI_SLOTS-1:0]     ARB_ACTIVE, // Status

   // err signals
   output wire                          DECODE_ERR
);

////////////////////////////////////////////////////////////////////////////////
// Functions
////////////////////////////////////////////////////////////////////////////////
`include "axis_interconnect_v1_1_22.vh"

////////////////////////////////////////////////////////////////////////////////
// Local parameters
////////////////////////////////////////////////////////////////////////////////
localparam TDW = C_AXIS_TDEST_WIDTH;
localparam P_TDEST_PRESENT = C_AXIS_SIGNAL_SET[G_INDX_SS_TDEST];

////////////////////////////////////////////////////////////////////////////////
// Wires/Reg declarations
////////////////////////////////////////////////////////////////////////////////
wire [C_NUM_MI_SLOTS-1:0]  busy_ns;
reg  [C_NUM_MI_SLOTS-1:0]  busy_r;
wire [C_NUM_MI_SLOTS-1:0]  dest_compare_match;
wire [C_NUM_MI_SLOTS-1:0]  arb_req_ns;
wire [C_NUM_MI_SLOTS-1:0]  arb_req_i;
wire                       decode_err_ns;
reg                        decode_err_r;
wire                       tready_or_decode_err;
wire                       m_axis_tvalid_payload;
wire                       m_axis_tvalid_req;
wire                       m_tready_from_decoded_slave;
////////////////////////////////////////////////////////////////////////////////
// BEGIN RTL
////////////////////////////////////////////////////////////////////////////////

// This selects only the TREADY of the MI slot we are requesting.
assign m_tready_from_decoded_slave = |(arb_req_i & M_AXIS_TREADY);

/* assign ARB_DONE = (C_USE_PACKET_MODE) ? ARB_LAST & m_tready_from_decoded_slave : m_tready_from_decoded_slave;*/

assign busy_ns =  (ARB_GNT | busy_r) & ~ARB_DONE;

always @(posedge ACLK) begin 
  if (ARESET) begin
    busy_r <= {C_NUM_MI_SLOTS{1'b0}};
  end else if (ACLKEN) begin
    busy_r <= busy_ns;
  end
end

assign ARB_ACTIVE = busy_r;

generate
genvar mi;

  if (P_TDEST_PRESENT) begin : gen_tdest_decoder
    for (mi = 0; mi < C_NUM_MI_SLOTS; mi = mi + 1) begin : gen_decode_loop
      if (C_CONNECTIVITY[mi] && (C_BASETDEST[mi*TDW+:TDW] <= C_HIGHTDEST[mi*TDW+:TDW])) begin : gen_master_connectivity
        assign dest_compare_match[mi] = ((S_AXIS_TDEST >= C_BASETDEST[mi*TDW+:TDW]) && (S_AXIS_TDEST <= C_HIGHTDEST[mi*TDW+:TDW])) 
                            ? 1'b1 : 1'b0;
       
        // Mux in the comparison only when S_AXIS_TVALID to avoid x propogation.
        assign arb_req_ns[mi] = S_AXIS_TVALID ? dest_compare_match[mi] : 1'b0; 
      end
      else begin : no_master_connectivity
        assign arb_req_ns[mi] = 1'b0;
      end
    end

    wire [C_NUM_MI_SLOTS-1:0] arb_req_out;

    axis_interconnect_v1_1_22_axisc_register_slice #(
      .C_FAMILY     ( C_FAMILY         ) ,
      .C_DATA_WIDTH ( C_TPAYLOAD_WIDTH ) ,
      .C_REG_CONFIG ( C_REG_CONFIG     ) 
    )
    axisc_register_slice_0 (
      .ACLK           ( ACLK                  ) ,
      .ARESET         ( ARESET                ) ,
      .ACLKEN         ( ACLKEN                ) ,
      .S_VALID        ( S_AXIS_TVALID         ) ,
      .S_READY        ( S_AXIS_TREADY         ) ,
      .S_PAYLOAD_DATA ( S_AXIS_TPAYLOAD       ) ,

      .M_VALID        ( m_axis_tvalid_payload ) , // Tvalid ignored, and the tvalid from the reg slice below is used.
      .M_READY        ( tready_or_decode_err  ) ,
      .M_PAYLOAD_DATA ( M_AXIS_TPAYLOAD       ) 
    );

    axis_interconnect_v1_1_22_axisc_register_slice #(
      .C_FAMILY     ( C_FAMILY       ) ,
      .C_DATA_WIDTH ( C_NUM_MI_SLOTS ) ,
      .C_REG_CONFIG ( C_REG_CONFIG   ) 
    )
    axisc_register_slice_1 (
      .ACLK           ( ACLK                 ) ,
      .ARESET         ( ARESET               ) ,
      .ACLKEN         ( ACLKEN               ) ,
      .S_VALID        ( S_AXIS_TVALID        ) ,
      .S_READY        (                      ) , // Ready output ignored since the Ready from reg_slice_0 is identical.
      .S_PAYLOAD_DATA ( arb_req_ns           ) ,

      .M_VALID        ( m_axis_tvalid_req    ) ,
      .M_READY        ( tready_or_decode_err ) ,
      .M_PAYLOAD_DATA ( arb_req_out          ) 
    );
    
    assign arb_req_i = m_axis_tvalid_req ? arb_req_out : {C_NUM_MI_SLOTS{1'b0}};

  end
  // If no tdest, then no tdest decoding can be performed. If single mi
  // system always decode to mi[0].
  else if (P_TDEST_PRESENT == 0 && C_NUM_MI_SLOTS == 1 && C_CONNECTIVITY[0] == 1'b1) begin : gen_no_tdest_decoder
    assign S_AXIS_TREADY = tready_or_decode_err;

    assign m_axis_tvalid_payload = S_AXIS_TVALID;
    assign M_AXIS_TPAYLOAD = S_AXIS_TPAYLOAD;
    assign m_axis_tvalid_req = S_AXIS_TVALID;
    assign arb_req_i = S_AXIS_TVALID;
  end
  // This case represents P_TDEST_PRESNT == 0 and C_NUM_MI_SLOTS > 1).  Need
  // tdets pins to route to multiple MI slots.
  else begin : gen_invalid_configuration 
    assign arb_req_i = {C_NUM_MI_SLOTS{1'b0}};
    assign S_AXIS_TREADY = 1'b0;
    assign m_axis_tvalid_payload = 1'b0;
    assign m_axis_tvalid_req = 1'b0;
    assign M_AXIS_TPAYLOAD = S_AXIS_TPAYLOAD;
  end
endgenerate

assign M_AXIS_TVALID = arb_req_i;

assign ARB_REQ = ~busy_r & arb_req_i;
// Decode Err: Decode err occurs when M_AXIS_TVALID = 1'b1 but none of the ARB_REQ
// have been asserted
assign decode_err_ns = ~(|arb_req_i) & m_axis_tvalid_req;

// decode_err is registered to minimize timing impact.  Results in a bubble
// cycle when an err occurs
always @(posedge ACLK) begin
  if (ARESET) begin
    decode_err_r <= {C_NUM_MI_SLOTS{1'b0}};
  end
  else if (ACLKEN) begin
    decode_err_r <= decode_err_ns & ~decode_err_r;
  end
end

assign tready_or_decode_err = m_tready_from_decoded_slave | decode_err_r;
assign DECODE_ERR = decode_err_r;

// Output ARBITER decision value from M_AXIS_TPAYLOAD
axis_interconnect_v1_1_22_util_vector2axis #(
  .C_TDATA_WIDTH    ( C_AXIS_TDATA_WIDTH ) ,
  .C_TID_WIDTH      ( C_AXIS_TID_WIDTH   ) ,
  .C_TDEST_WIDTH    ( C_AXIS_TDEST_WIDTH ) ,
  .C_TUSER_WIDTH    ( C_AXIS_TUSER_WIDTH ) ,
  .C_TPAYLOAD_WIDTH ( C_TPAYLOAD_WIDTH   ) ,
  .C_SIGNAL_SET     ( C_AXIS_SIGNAL_SET  ) 
)
util_vector2axis_0 (
  .TPAYLOAD ( M_AXIS_TPAYLOAD ) ,
  .TDATA    (                 ) ,
  .TSTRB    (                 ) ,
  .TKEEP    (                 ) ,
  .TLAST    ( ARB_LAST        ) ,
  .TID      ( ARB_ID          ) ,
  .TDEST    ( ARB_DEST        ) ,
  .TUSER    ( ARB_USER        ) 
);

endmodule // axisc_decoder

`default_nettype wire


// (c) Copyright 2011-2012, 2023 Advanced Micro Devices, Inc. All rights reserved.
//
// This file contains confidential and proprietary information
// of AMD and is protected under U.S. and international copyright
// and other intellectual property laws.
//
// DISCLAIMER
// This disclaimer is not a license and does not grant any
// rights to the materials distributed herewith. Except as
// otherwise provided in a valid license issued to you by
// AMD, and to the maximum extent permitted by applicable
// law: (1) THESE MATERIALS ARE MADE AVAILABLE "AS IS" AND
// WITH ALL FAULTS, AND AMD HEREBY DISCLAIMS ALL WARRANTIES
// AND CONDITIONS, EXPRESS, IMPLIED, OR STATUTORY, INCLUDING
// BUT NOT LIMITED TO WARRANTIES OF MERCHANTABILITY, NON-
// INFRINGEMENT, OR FITNESS FOR ANY PARTICULAR PURPOSE; and
// (2) AMD shall not be liable (whether in contract or tort,
// including negligence, or under any other theory of
// liability) for any loss or damage of any kind or nature
// related to, arising under or in connection with these
// materials, including for any direct, or any indirect,
// special, incidental, or consequential loss or damage
// (including loss of data, profits, goodwill, or any type of
// loss or damage suffered as a result of any action brought
// by a third party) even if such damage or loss was
// reasonably foreseeable or AMD had been advised of the
// possibility of the same.
//
// CRITICAL APPLICATIONS
// AMD products are not designed or intended to be fail-
// safe, or for use in any application requiring fail-safe
// performance, such as life-support or safety devices or
// systems, Class III medical devices, nuclear facilities,
// applications related to the deployment of airbags, or any
// other applications that could lead to death, personal
// injury, or severe property or environmental damage
// (individually and collectively, "Critical
// Applications"). Customer assumes the sole risk and
// liability of any use of AMD products in Critical
// Applications, subject only to applicable laws and
// regulations governing limitations on product liability.
//
// THIS COPYRIGHT NOTICE AND DISCLAIMER MUST BE RETAINED AS
// PART OF THIS FILE AT ALL TIMES.
////////////////////////////////////////////////////////////
//
//
// Verilog-standard:  Verilog 2001
//--------------------------------------------------------------------------
//
// Structure:
//   axisc_transfer_mux
//
//--------------------------------------------------------------------------

`timescale 1ps/1ps
`default_nettype none

module axis_interconnect_v1_1_22_axisc_transfer_mux #
(
///////////////////////////////////////////////////////////////////////////////
// Parameter Definitions
///////////////////////////////////////////////////////////////////////////////
   parameter         C_FAMILY           = "virtex7",
   parameter         C_TPAYLOAD_WIDTH   = 32,
   parameter integer C_AXIS_TDATA_WIDTH = 32,
   parameter integer C_AXIS_TID_WIDTH   = 1,
   parameter integer C_AXIS_TDEST_WIDTH = 1,
   parameter integer C_AXIS_TUSER_WIDTH = 1,
   parameter [31:0]  C_AXIS_SIGNAL_SET  = 32'hFF,
   // C_AXIS_SIGNAL_SET: each bit if enabled specifies which axis optional signals are present
   //   [0] => TREADY present
   //   [1] => TDATA present
   //   [2] => TSTRB present, TDATA must be present
   //   [3] => TKEEP present, TDATA must be present
   //   [4] => TLAST present
   //   [5] => TID present
   //   [6] => TDEST present
   //   [7] => TUSER present
   parameter integer C_NUM_SI_SLOTS     = 2,
   parameter integer C_LOG_SI_SLOTS     = 1,
   parameter integer C_USE_PACKET_MODE  = 1,
   // C_USE_PACKET_MODE: 
   //   0 => Ignore TLAST
   //   1 => Signal ARB_DONE on TLAST
   parameter integer C_MAX_XFERS_PER_ARB = 5,
   // C_MAX_XFERS_PER_ARB: 
   //  0 => Ignore number of transfers to signal DONE
   //  1+ => Signal ARB_DONE after x TRANSFERS
   parameter integer C_NUM_CYCLES_TIMEOUT = 5,
   // C_NUM_CYCLE_TIMEOUT: 
   //  0 => Ignore TIMEOUT parameter
   //  1+ => Signal ARB_DONE after x cylces of TVALID low
   parameter integer C_REG_CONFIG       = 1, 
   // C_REG_CONFIG: Registers payload and ARB_REQ signal
   //   0 => BYPASS    = The channel is just wired through the module.
   //   1 => FWD_REV   = Both FWD and REV (fully-registered)
   //   2 => FWD       = The master VALID and payload signals are registrated. 
   //   3 => REV       = The slave ready signal is registrated
   //   4 => RESERVED (all outputs driven to 0).
   //   5 => RESERVED (all outputs driven to 0).
   //   6 => INPUTS    = Slave and Master side inputs are registrated.
   //   7 => LIGHT_WT  = 1-stage pipeline register with bubble cycle, both FWD and REV pipelining
   parameter [C_NUM_SI_SLOTS-1:0] C_CONNECTIVITY = {C_NUM_SI_SLOTS{1'b1}},
   // Specifies connectivity matrix for sparse crossbar configurations
   parameter integer C_SINGLE_SLAVE_CONNECTIVITY = 1
)
(
///////////////////////////////////////////////////////////////////////////////
// Port Declarations
///////////////////////////////////////////////////////////////////////////////
   // System Signals
   input wire ACLK,
   input wire ARESET,
   input wire ACLKEN,

   // Slave side
   input  wire [C_NUM_SI_SLOTS-1:0]                  S_AXIS_TVALID,
   output wire [C_NUM_SI_SLOTS-1:0]                  S_AXIS_TREADY,
   input  wire [C_NUM_SI_SLOTS*C_TPAYLOAD_WIDTH-1:0] S_AXIS_TPAYLOAD,

   // Master side
   output wire                                       M_AXIS_TVALID,
   input  wire                                       M_AXIS_TREADY,
   output wire [C_TPAYLOAD_WIDTH-1:0]                M_AXIS_TPAYLOAD,

   // Arbiter side
   input  wire [C_NUM_SI_SLOTS-1:0]                  ARB_GNT,
   input  wire [C_LOG_SI_SLOTS-1:0]                  ARB_SEL,
   output wire                                       ARB_DONE
);

////////////////////////////////////////////////////////////////////////////////
// Functions
////////////////////////////////////////////////////////////////////////////////
`include "axis_interconnect_v1_1_22.vh"

localparam P_LOG_NUM_SLAVE_SLOTS = f_clogb2(C_NUM_SI_SLOTS);
function [C_NUM_SI_SLOTS-1:0] f_onehot_to_binary ( 
  input integer  onehot
);
begin : main 
  integer i;
  for (i = 0; onehot[i] != 1; i = i + 1) begin
  end
  f_onehot_to_binary = i;
end
endfunction
////////////////////////////////////////////////////////////////////////////////
// Local parameters
////////////////////////////////////////////////////////////////////////////////
// Check if Connectivity is a power of a 2 which would mean that there is only
// 1 slave connected.
// localparam P_SINGLE_SLAVE_CONNECTIVITY = ((C_CONNECTIVITY & (C_CONNECTIVITY-1)) == 0);
localparam P_FIXED_MUX_VALUE = f_onehot_to_binary(C_CONNECTIVITY);

////////////////////////////////////////////////////////////////////////////////
// Wires/Reg declarations
////////////////////////////////////////////////////////////////////////////////
wire [C_NUM_SI_SLOTS-1:0]   busy_ns;
/*reg  [C_NUM_SI_SLOTS-1:0]   busy_r;*/
wire [C_NUM_SI_SLOTS-1:0]   busy_r;
wire [C_LOG_SI_SLOTS-1:0]   sel_i;
wire [C_TPAYLOAD_WIDTH-1:0] axis_tpayload_mux_out;
wire                        axis_tvalid_mux_out;
wire                        axis_tready_mux_in;
wire                        axis_tlast_i;
wire [C_NUM_SI_SLOTS-1:0]   output_enable;
////////////////////////////////////////////////////////////////////////////////
// BEGIN RTL
////////////////////////////////////////////////////////////////////////////////

axis_interconnect_v1_1_22_axisc_arb_responder #( 
  .C_FAMILY             ( C_FAMILY             ) ,
  .C_ARB_GNT_WIDTH      ( C_NUM_SI_SLOTS       ) ,
  .C_USE_PACKET_MODE    ( C_USE_PACKET_MODE    ) ,
  .C_MAX_XFERS_PER_ARB  ( C_MAX_XFERS_PER_ARB  ) ,
  .C_NUM_CYCLES_TIMEOUT ( C_NUM_CYCLES_TIMEOUT ) ,
  .C_SINGLE_SLAVE_CONNECTIVITY (C_SINGLE_SLAVE_CONNECTIVITY )
)
axisc_arb_responder (
  .ACLK        ( ACLK                ) ,
  .ARESET      ( ARESET              ) ,
  .ACLKEN      ( ACLKEN              ) ,
  .AXIS_TVALID ( axis_tvalid_mux_out ) ,
  .AXIS_TREADY ( axis_tready_mux_in  ) ,
  .AXIS_TLAST  ( axis_tlast_i        ) ,
  .ARB_GNT     ( ARB_GNT             ) ,
  .ARB_DONE    ( ARB_DONE            ) ,
  .ARB_BUSY    ( busy_r              ) 
);

/*assign busy_ns = ARB_DONE ? 1'b0 : ARB_GNT | busy_r;*/
/**/
/*always @(posedge ACLK) begin */
/*  if (ARESET) begin*/
/*    busy_r <= {C_NUM_SI_SLOTS{1'b0}};*/
/*  end else if (ACLKEN) begin*/
/*    busy_r <= busy_ns;*/
/*  end*/
/*end*/
/**/
/*assign ARB_DONE = (C_USE_PACKET_MODE && axis_tlast_i) & axis_tvalid_mux_out & axis_tready_mux_in;*/

assign sel_i = (C_SINGLE_SLAVE_CONNECTIVITY | C_NUM_SI_SLOTS == 1) ? P_FIXED_MUX_VALUE :
               ARB_SEL;

assign output_enable = ( C_NUM_SI_SLOTS == 1 ) ? 1'b1 : 
                       ( C_SINGLE_SLAVE_CONNECTIVITY ) ? C_CONNECTIVITY[C_NUM_SI_SLOTS-1:0] :
                       ARB_GNT | busy_r;

axis_interconnect_v1_1_22_mux_enc #(
  .C_FAMILY     ( C_FAMILY              ) ,
  .C_RATIO      ( C_NUM_SI_SLOTS        ) ,
  .C_SEL_WIDTH  ( P_LOG_NUM_SLAVE_SLOTS ) ,
  .C_DATA_WIDTH ( C_TPAYLOAD_WIDTH      ) 
)
mux_enc_0
(
  .S  ( sel_i                 ) ,
  .A  ( S_AXIS_TPAYLOAD       ) ,
  .O  ( axis_tpayload_mux_out ) ,
  .OE ( 1'b1                  ) 
);
axis_interconnect_v1_1_22_mux_enc #(
  .C_FAMILY     ( C_FAMILY              ) ,
  .C_RATIO      ( C_NUM_SI_SLOTS        ) ,
  .C_SEL_WIDTH  ( P_LOG_NUM_SLAVE_SLOTS ) ,
  .C_DATA_WIDTH ( 1                     ) 
)
mux_enc_1
(
  .S  ( sel_i               ) ,
  .A  ( S_AXIS_TVALID       ) ,
  .O  ( axis_tvalid_mux_out ) ,
  .OE ( | output_enable     ) 
);

axis_interconnect_v1_1_22_util_vector2axis #(
  .C_TDATA_WIDTH    ( C_AXIS_TDATA_WIDTH ) ,
  .C_TID_WIDTH      ( C_AXIS_TID_WIDTH   ) ,
  .C_TDEST_WIDTH    ( C_AXIS_TDEST_WIDTH ) ,
  .C_TUSER_WIDTH    ( C_AXIS_TUSER_WIDTH ) ,
  .C_TPAYLOAD_WIDTH ( C_TPAYLOAD_WIDTH   ) ,
  .C_SIGNAL_SET     ( C_AXIS_SIGNAL_SET  ) 
)
util_vector2axis_0 (
  .TPAYLOAD ( axis_tpayload_mux_out ) ,
  .TDATA    (                       ) ,
  .TSTRB    (                       ) ,
  .TKEEP    (                       ) ,
  .TLAST    ( axis_tlast_i          ) ,
  .TID      (                       ) ,
  .TDEST    (                       ) ,
  .TUSER    (                       ) 
);

assign S_AXIS_TREADY = {C_NUM_SI_SLOTS{axis_tready_mux_in}} & output_enable;
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
