xvrxvr/fpga-osc/interface.gen/sources_1/ip/axis_interconnect_input/synth/axis_interconnect_input.v

// (c) Copyright 1986-2022 Xilinx, Inc. All Rights Reserved.
// (c) Copyright 2022-2024 Advanced Micro Devices, Inc. All rights reserved.
// 
// This file contains confidential and proprietary information
// of AMD and is protected under U.S. and international copyright
// and other intellectual property laws.
// 
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
// CRITICAL APPLICATIONS
// AMD products are not designed or intended to be fail-
// safe, or for use in any application requiring fail-safe
// performance, such as life-support or safety devices or
// systems, Class III medical devices, nuclear facilities,
// applications related to the deployment of airbags, or any
// other applications that could lead to death, personal
// injury, or severe property or environmental damage
// (individually and collectively, "Critical
// Applications"). Customer assumes the sole risk and
// liability of any use of AMD products in Critical
// Applications, subject only to applicable laws and
// regulations governing limitations on product liability.
// 
// THIS COPYRIGHT NOTICE AND DISCLAIMER MUST BE RETAINED AS
// PART OF THIS FILE AT ALL TIMES.
// 
// DO NOT MODIFY THIS FILE.


// IP VLNV: xilinx.com:ip:axis_interconnect:1.1
// IP Revision: 22

(* X_CORE_INFO = "axis_interconnect_v1_1_22_axis_interconnect_16x16_top,Vivado 2023.2.2" *)
(* CHECK_LICENSE_TYPE = "axis_interconnect_input,axis_interconnect_v1_1_22_axis_interconnect_16x16_top,{}" *)
(* CORE_GENERATION_INFO = "axis_interconnect_input,axis_interconnect_v1_1_22_axis_interconnect_16x16_top,{x_ipProduct=Vivado 2023.2.2,x_ipVendor=xilinx.com,x_ipLibrary=ip,x_ipName=axis_interconnect,x_ipVersion=1.1,x_ipCoreRevision=22,x_ipLanguage=VERILOG,x_ipSimLanguage=MIXED,C_FAMILY=spartan7,C_NUM_MI_SLOTS=5,C_NUM_SI_SLOTS=1,C_SWITCH_MI_REG_CONFIG=1,C_SWITCH_SI_REG_CONFIG=1,C_SWITCH_MODE=1,C_SWITCH_MAX_XFERS_PER_ARB=1,C_SWITCH_NUM_CYCLES_TIMEOUT=0,C_SWITCH_TDATA_WIDTH=32,C_SWITCH_TID_WIDTH=1,C_SWITCH_TDEST_WIDTH=8,C_SWI\
TCH_TUSER_WIDTH=4,C_SWITCH_SIGNAL_SET=0x000000D3,C_SWITCH_ACLK_RATIO=12,C_SWITCH_USE_ACLKEN=0,C_SYNCHRONIZER_STAGE=2,C_M00_AXIS_CONNECTIVITY=0x0001,C_M01_AXIS_CONNECTIVITY=0x0001,C_M02_AXIS_CONNECTIVITY=0x0001,C_M03_AXIS_CONNECTIVITY=0x0001,C_M04_AXIS_CONNECTIVITY=0x0001,C_M05_AXIS_CONNECTIVITY=0x0000,C_M06_AXIS_CONNECTIVITY=0x0000,C_M07_AXIS_CONNECTIVITY=0x0000,C_M08_AXIS_CONNECTIVITY=0x0000,C_M09_AXIS_CONNECTIVITY=0x0000,C_M10_AXIS_CONNECTIVITY=0x0000,C_M11_AXIS_CONNECTIVITY=0x0000,C_M12_AXIS_\
CONNECTIVITY=0x0000,C_M13_AXIS_CONNECTIVITY=0x0000,C_M14_AXIS_CONNECTIVITY=0x0000,C_M15_AXIS_CONNECTIVITY=0x0000,C_M00_AXIS_BASETDEST=0x00000000,C_M01_AXIS_BASETDEST=0x00000001,C_M02_AXIS_BASETDEST=0x00000002,C_M03_AXIS_BASETDEST=0x00000003,C_M04_AXIS_BASETDEST=0x00000004,C_M05_AXIS_BASETDEST=0x00000005,C_M06_AXIS_BASETDEST=0x00000006,C_M07_AXIS_BASETDEST=0x00000007,C_M08_AXIS_BASETDEST=0x00000008,C_M09_AXIS_BASETDEST=0x00000009,C_M10_AXIS_BASETDEST=0x0000000A,C_M11_AXIS_BASETDEST=0x0000000B,C_M\
12_AXIS_BASETDEST=0x0000000C,C_M13_AXIS_BASETDEST=0x0000000D,C_M14_AXIS_BASETDEST=0x0000000E,C_M15_AXIS_BASETDEST=0x0000000F,C_M00_AXIS_HIGHTDEST=0x00000000,C_M01_AXIS_HIGHTDEST=0x00000001,C_M02_AXIS_HIGHTDEST=0x00000002,C_M03_AXIS_HIGHTDEST=0x00000003,C_M04_AXIS_HIGHTDEST=0x00000004,C_M05_AXIS_HIGHTDEST=0x00000005,C_M06_AXIS_HIGHTDEST=0x00000006,C_M07_AXIS_HIGHTDEST=0x00000007,C_M08_AXIS_HIGHTDEST=0x00000008,C_M09_AXIS_HIGHTDEST=0x00000009,C_M10_AXIS_HIGHTDEST=0x0000000A,C_M11_AXIS_HIGHTDEST=0x\
0000000B,C_M12_AXIS_HIGHTDEST=0x0000000C,C_M13_AXIS_HIGHTDEST=0x0000000D,C_M14_AXIS_HIGHTDEST=0x0000000E,C_M15_AXIS_HIGHTDEST=0x0000000F,C_S00_AXIS_TDATA_WIDTH=32,C_S01_AXIS_TDATA_WIDTH=8,C_S02_AXIS_TDATA_WIDTH=8,C_S03_AXIS_TDATA_WIDTH=8,C_S04_AXIS_TDATA_WIDTH=8,C_S05_AXIS_TDATA_WIDTH=8,C_S06_AXIS_TDATA_WIDTH=8,C_S07_AXIS_TDATA_WIDTH=8,C_S08_AXIS_TDATA_WIDTH=8,C_S09_AXIS_TDATA_WIDTH=8,C_S10_AXIS_TDATA_WIDTH=8,C_S11_AXIS_TDATA_WIDTH=8,C_S12_AXIS_TDATA_WIDTH=8,C_S13_AXIS_TDATA_WIDTH=8,C_S14_AXIS_T\
DATA_WIDTH=8,C_S15_AXIS_TDATA_WIDTH=8,C_S00_AXIS_TUSER_WIDTH=4,C_S01_AXIS_TUSER_WIDTH=1,C_S02_AXIS_TUSER_WIDTH=1,C_S03_AXIS_TUSER_WIDTH=1,C_S04_AXIS_TUSER_WIDTH=1,C_S05_AXIS_TUSER_WIDTH=1,C_S06_AXIS_TUSER_WIDTH=1,C_S07_AXIS_TUSER_WIDTH=1,C_S08_AXIS_TUSER_WIDTH=1,C_S09_AXIS_TUSER_WIDTH=1,C_S10_AXIS_TUSER_WIDTH=1,C_S11_AXIS_TUSER_WIDTH=1,C_S12_AXIS_TUSER_WIDTH=1,C_S13_AXIS_TUSER_WIDTH=1,C_S14_AXIS_TUSER_WIDTH=1,C_S15_AXIS_TUSER_WIDTH=1,C_S00_AXIS_IS_ACLK_ASYNC=0,C_S01_AXIS_IS_ACLK_ASYNC=0,C_S02_AX\
IS_IS_ACLK_ASYNC=0,C_S03_AXIS_IS_ACLK_ASYNC=0,C_S04_AXIS_IS_ACLK_ASYNC=0,C_S05_AXIS_IS_ACLK_ASYNC=0,C_S06_AXIS_IS_ACLK_ASYNC=0,C_S07_AXIS_IS_ACLK_ASYNC=0,C_S08_AXIS_IS_ACLK_ASYNC=0,C_S09_AXIS_IS_ACLK_ASYNC=0,C_S10_AXIS_IS_ACLK_ASYNC=0,C_S11_AXIS_IS_ACLK_ASYNC=0,C_S12_AXIS_IS_ACLK_ASYNC=0,C_S13_AXIS_IS_ACLK_ASYNC=0,C_S14_AXIS_IS_ACLK_ASYNC=0,C_S15_AXIS_IS_ACLK_ASYNC=0,C_S00_AXIS_ACLK_RATIO=12,C_S01_AXIS_ACLK_RATIO=12,C_S02_AXIS_ACLK_RATIO=12,C_S03_AXIS_ACLK_RATIO=12,C_S04_AXIS_ACLK_RATIO=12,C_S05\
_AXIS_ACLK_RATIO=12,C_S06_AXIS_ACLK_RATIO=12,C_S07_AXIS_ACLK_RATIO=12,C_S08_AXIS_ACLK_RATIO=12,C_S09_AXIS_ACLK_RATIO=12,C_S10_AXIS_ACLK_RATIO=12,C_S11_AXIS_ACLK_RATIO=12,C_S12_AXIS_ACLK_RATIO=12,C_S13_AXIS_ACLK_RATIO=12,C_S14_AXIS_ACLK_RATIO=12,C_S15_AXIS_ACLK_RATIO=12,C_S00_AXIS_REG_CONFIG=0,C_S01_AXIS_REG_CONFIG=0,C_S02_AXIS_REG_CONFIG=0,C_S03_AXIS_REG_CONFIG=0,C_S04_AXIS_REG_CONFIG=0,C_S05_AXIS_REG_CONFIG=0,C_S06_AXIS_REG_CONFIG=0,C_S07_AXIS_REG_CONFIG=0,C_S08_AXIS_REG_CONFIG=0,C_S09_AXIS_REG\
_CONFIG=0,C_S10_AXIS_REG_CONFIG=0,C_S11_AXIS_REG_CONFIG=0,C_S12_AXIS_REG_CONFIG=0,C_S13_AXIS_REG_CONFIG=0,C_S14_AXIS_REG_CONFIG=0,C_S15_AXIS_REG_CONFIG=0,C_S00_AXIS_FIFO_DEPTH=32,C_S01_AXIS_FIFO_DEPTH=32,C_S02_AXIS_FIFO_DEPTH=32,C_S03_AXIS_FIFO_DEPTH=32,C_S04_AXIS_FIFO_DEPTH=32,C_S05_AXIS_FIFO_DEPTH=32,C_S06_AXIS_FIFO_DEPTH=32,C_S07_AXIS_FIFO_DEPTH=32,C_S08_AXIS_FIFO_DEPTH=32,C_S09_AXIS_FIFO_DEPTH=32,C_S10_AXIS_FIFO_DEPTH=32,C_S11_AXIS_FIFO_DEPTH=32,C_S12_AXIS_FIFO_DEPTH=32,C_S13_AXIS_FIFO_DEPTH\
=32,C_S14_AXIS_FIFO_DEPTH=32,C_S15_AXIS_FIFO_DEPTH=32,C_S00_AXIS_FIFO_MODE=1,C_S01_AXIS_FIFO_MODE=0,C_S02_AXIS_FIFO_MODE=0,C_S03_AXIS_FIFO_MODE=0,C_S04_AXIS_FIFO_MODE=0,C_S05_AXIS_FIFO_MODE=0,C_S06_AXIS_FIFO_MODE=0,C_S07_AXIS_FIFO_MODE=0,C_S08_AXIS_FIFO_MODE=0,C_S09_AXIS_FIFO_MODE=0,C_S10_AXIS_FIFO_MODE=0,C_S11_AXIS_FIFO_MODE=0,C_S12_AXIS_FIFO_MODE=0,C_S13_AXIS_FIFO_MODE=0,C_S14_AXIS_FIFO_MODE=0,C_S15_AXIS_FIFO_MODE=0,C_M00_AXIS_TDATA_WIDTH=32,C_M01_AXIS_TDATA_WIDTH=32,C_M02_AXIS_TDATA_WIDTH=32,\
C_M03_AXIS_TDATA_WIDTH=32,C_M04_AXIS_TDATA_WIDTH=32,C_M05_AXIS_TDATA_WIDTH=8,C_M06_AXIS_TDATA_WIDTH=8,C_M07_AXIS_TDATA_WIDTH=8,C_M08_AXIS_TDATA_WIDTH=8,C_M09_AXIS_TDATA_WIDTH=8,C_M10_AXIS_TDATA_WIDTH=8,C_M11_AXIS_TDATA_WIDTH=8,C_M12_AXIS_TDATA_WIDTH=8,C_M13_AXIS_TDATA_WIDTH=8,C_M14_AXIS_TDATA_WIDTH=8,C_M15_AXIS_TDATA_WIDTH=8,C_M00_AXIS_TUSER_WIDTH=4,C_M01_AXIS_TUSER_WIDTH=4,C_M02_AXIS_TUSER_WIDTH=4,C_M03_AXIS_TUSER_WIDTH=4,C_M04_AXIS_TUSER_WIDTH=4,C_M05_AXIS_TUSER_WIDTH=1,C_M06_AXIS_TUSER_WIDTH=\
1,C_M07_AXIS_TUSER_WIDTH=1,C_M08_AXIS_TUSER_WIDTH=1,C_M09_AXIS_TUSER_WIDTH=1,C_M10_AXIS_TUSER_WIDTH=1,C_M11_AXIS_TUSER_WIDTH=1,C_M12_AXIS_TUSER_WIDTH=1,C_M13_AXIS_TUSER_WIDTH=1,C_M14_AXIS_TUSER_WIDTH=1,C_M15_AXIS_TUSER_WIDTH=1,C_M00_AXIS_ACLK_RATIO=12,C_M01_AXIS_ACLK_RATIO=12,C_M02_AXIS_ACLK_RATIO=12,C_M03_AXIS_ACLK_RATIO=12,C_M04_AXIS_ACLK_RATIO=12,C_M05_AXIS_ACLK_RATIO=12,C_M06_AXIS_ACLK_RATIO=12,C_M07_AXIS_ACLK_RATIO=12,C_M08_AXIS_ACLK_RATIO=12,C_M09_AXIS_ACLK_RATIO=12,C_M10_AXIS_ACLK_RATIO=1\
2,C_M11_AXIS_ACLK_RATIO=12,C_M12_AXIS_ACLK_RATIO=12,C_M13_AXIS_ACLK_RATIO=12,C_M14_AXIS_ACLK_RATIO=12,C_M15_AXIS_ACLK_RATIO=12,C_M00_AXIS_REG_CONFIG=0,C_M01_AXIS_REG_CONFIG=0,C_M02_AXIS_REG_CONFIG=0,C_M03_AXIS_REG_CONFIG=0,C_M04_AXIS_REG_CONFIG=0,C_M05_AXIS_REG_CONFIG=0,C_M06_AXIS_REG_CONFIG=0,C_M07_AXIS_REG_CONFIG=0,C_M08_AXIS_REG_CONFIG=0,C_M09_AXIS_REG_CONFIG=0,C_M10_AXIS_REG_CONFIG=0,C_M11_AXIS_REG_CONFIG=0,C_M12_AXIS_REG_CONFIG=0,C_M13_AXIS_REG_CONFIG=0,C_M14_AXIS_REG_CONFIG=0,C_M15_AXIS_RE\
G_CONFIG=0,C_M00_AXIS_IS_ACLK_ASYNC=0,C_M01_AXIS_IS_ACLK_ASYNC=0,C_M02_AXIS_IS_ACLK_ASYNC=0,C_M03_AXIS_IS_ACLK_ASYNC=0,C_M04_AXIS_IS_ACLK_ASYNC=0,C_M05_AXIS_IS_ACLK_ASYNC=0,C_M06_AXIS_IS_ACLK_ASYNC=0,C_M07_AXIS_IS_ACLK_ASYNC=0,C_M08_AXIS_IS_ACLK_ASYNC=0,C_M09_AXIS_IS_ACLK_ASYNC=0,C_M10_AXIS_IS_ACLK_ASYNC=0,C_M11_AXIS_IS_ACLK_ASYNC=0,C_M12_AXIS_IS_ACLK_ASYNC=0,C_M13_AXIS_IS_ACLK_ASYNC=0,C_M14_AXIS_IS_ACLK_ASYNC=0,C_M15_AXIS_IS_ACLK_ASYNC=0,C_M00_AXIS_FIFO_DEPTH=32,C_M01_AXIS_FIFO_DEPTH=32,C_M02_A\
XIS_FIFO_DEPTH=32,C_M03_AXIS_FIFO_DEPTH=32,C_M04_AXIS_FIFO_DEPTH=32,C_M05_AXIS_FIFO_DEPTH=32,C_M06_AXIS_FIFO_DEPTH=32,C_M07_AXIS_FIFO_DEPTH=32,C_M08_AXIS_FIFO_DEPTH=32,C_M09_AXIS_FIFO_DEPTH=32,C_M10_AXIS_FIFO_DEPTH=32,C_M11_AXIS_FIFO_DEPTH=32,C_M12_AXIS_FIFO_DEPTH=32,C_M13_AXIS_FIFO_DEPTH=32,C_M14_AXIS_FIFO_DEPTH=32,C_M15_AXIS_FIFO_DEPTH=32,C_M00_AXIS_FIFO_MODE=0,C_M01_AXIS_FIFO_MODE=0,C_M02_AXIS_FIFO_MODE=0,C_M03_AXIS_FIFO_MODE=0,C_M04_AXIS_FIFO_MODE=0,C_M05_AXIS_FIFO_MODE=0,C_M06_AXIS_FIFO_MOD\
E=0,C_M07_AXIS_FIFO_MODE=0,C_M08_AXIS_FIFO_MODE=0,C_M09_AXIS_FIFO_MODE=0,C_M10_AXIS_FIFO_MODE=0,C_M11_AXIS_FIFO_MODE=0,C_M12_AXIS_FIFO_MODE=0,C_M13_AXIS_FIFO_MODE=0,C_M14_AXIS_FIFO_MODE=0,C_M15_AXIS_FIFO_MODE=0}" *)
(* DowngradeIPIdentifiedWarnings = "yes" *)
module axis_interconnect_input (
  ACLK,
  ARESETN,
  S00_AXIS_ACLK,
  S00_AXIS_ARESETN,
  S00_AXIS_TVALID,
  S00_AXIS_TREADY,
  S00_AXIS_TDATA,
  S00_AXIS_TLAST,
  S00_AXIS_TDEST,
  S00_AXIS_TUSER,
  M00_AXIS_ACLK,
  M01_AXIS_ACLK,
  M02_AXIS_ACLK,
  M03_AXIS_ACLK,
  M04_AXIS_ACLK,
  M00_AXIS_ARESETN,
  M01_AXIS_ARESETN,
  M02_AXIS_ARESETN,
  M03_AXIS_ARESETN,
  M04_AXIS_ARESETN,
  M00_AXIS_TVALID,
  M01_AXIS_TVALID,
  M02_AXIS_TVALID,
  M03_AXIS_TVALID,
  M04_AXIS_TVALID,
  M00_AXIS_TREADY,
  M01_AXIS_TREADY,
  M02_AXIS_TREADY,
  M03_AXIS_TREADY,
  M04_AXIS_TREADY,
  M00_AXIS_TDATA,
  M01_AXIS_TDATA,
  M02_AXIS_TDATA,
  M03_AXIS_TDATA,
  M04_AXIS_TDATA,
  M00_AXIS_TLAST,
  M01_AXIS_TLAST,
  M02_AXIS_TLAST,
  M03_AXIS_TLAST,
  M04_AXIS_TLAST,
  M00_AXIS_TDEST,
  M01_AXIS_TDEST,
  M02_AXIS_TDEST,
  M03_AXIS_TDEST,
  M04_AXIS_TDEST,
  M00_AXIS_TUSER,
  M01_AXIS_TUSER,
  M02_AXIS_TUSER,
  M03_AXIS_TUSER,
  M04_AXIS_TUSER,
  S00_DECODE_ERR,
  S00_FIFO_DATA_COUNT,
  M01_SPARSE_TKEEP_REMOVED,
  M02_SPARSE_TKEEP_REMOVED,
  M03_SPARSE_TKEEP_REMOVED,
  M04_SPARSE_TKEEP_REMOVED
);

(* X_INTERFACE_PARAMETER = "XIL_INTERFACENAME CLKIF, FREQ_HZ 200000000, FREQ_TOLERANCE_HZ 0, PHASE 0.0, INSERT_VIP 0" *)
(* X_INTERFACE_INFO = "xilinx.com:signal:clock:1.0 CLKIF CLK" *)
input wire ACLK;
(* X_INTERFACE_PARAMETER = "XIL_INTERFACENAME RSTIF, POLARITY ACTIVE_LOW, INSERT_VIP 0" *)
(* X_INTERFACE_INFO = "xilinx.com:signal:reset:1.0 RSTIF RST" *)
input wire ARESETN;
(* X_INTERFACE_PARAMETER = "XIL_INTERFACENAME S00_CLKIF, FREQ_HZ 200000000, FREQ_TOLERANCE_HZ 0, PHASE 0.0, INSERT_VIP 0" *)
(* X_INTERFACE_INFO = "xilinx.com:signal:clock:1.0 S00_CLKIF CLK" *)
input wire S00_AXIS_ACLK;
(* X_INTERFACE_PARAMETER = "XIL_INTERFACENAME S00_RSTIF, POLARITY ACTIVE_LOW, INSERT_VIP 0" *)
(* X_INTERFACE_INFO = "xilinx.com:signal:reset:1.0 S00_RSTIF RST" *)
input wire S00_AXIS_ARESETN;
(* X_INTERFACE_INFO = "xilinx.com:interface:axis:1.0 S00_AXIS TVALID" *)
input wire S00_AXIS_TVALID;
(* X_INTERFACE_INFO = "xilinx.com:interface:axis:1.0 S00_AXIS TREADY" *)
output wire S00_AXIS_TREADY;
(* X_INTERFACE_INFO = "xilinx.com:interface:axis:1.0 S00_AXIS TDATA" *)
input wire [31 : 0] S00_AXIS_TDATA;
(* X_INTERFACE_INFO = "xilinx.com:interface:axis:1.0 S00_AXIS TLAST" *)
input wire S00_AXIS_TLAST;
(* X_INTERFACE_INFO = "xilinx.com:interface:axis:1.0 S00_AXIS TDEST" *)
input wire [7 : 0] S00_AXIS_TDEST;
(* X_INTERFACE_PARAMETER = "XIL_INTERFACENAME S00_AXIS, TDATA_NUM_BYTES 4, TDEST_WIDTH 8, TID_WIDTH 0, TUSER_WIDTH 4, HAS_TREADY 1, HAS_TSTRB 0, HAS_TKEEP 0, HAS_TLAST 1, FREQ_HZ 100000000, PHASE 0.0, LAYERED_METADATA undef, INSERT_VIP 0" *)
(* X_INTERFACE_INFO = "xilinx.com:interface:axis:1.0 S00_AXIS TUSER" *)
input wire [3 : 0] S00_AXIS_TUSER;
(* X_INTERFACE_PARAMETER = "XIL_INTERFACENAME M00_CLKIF, FREQ_HZ 200000000, FREQ_TOLERANCE_HZ 0, PHASE 0.0, INSERT_VIP 0" *)
(* X_INTERFACE_INFO = "xilinx.com:signal:clock:1.0 M00_CLKIF CLK" *)
input wire M00_AXIS_ACLK;
(* X_INTERFACE_PARAMETER = "XIL_INTERFACENAME M01_CLKIF, FREQ_HZ 200000000, FREQ_TOLERANCE_HZ 0, PHASE 0.0, INSERT_VIP 0" *)
(* X_INTERFACE_INFO = "xilinx.com:signal:clock:1.0 M01_CLKIF CLK" *)
input wire M01_AXIS_ACLK;
(* X_INTERFACE_PARAMETER = "XIL_INTERFACENAME M02_CLKIF, FREQ_HZ 200000000, FREQ_TOLERANCE_HZ 0, PHASE 0.0, INSERT_VIP 0" *)
(* X_INTERFACE_INFO = "xilinx.com:signal:clock:1.0 M02_CLKIF CLK" *)
input wire M02_AXIS_ACLK;
(* X_INTERFACE_PARAMETER = "XIL_INTERFACENAME M03_CLKIF, FREQ_HZ 200000000, FREQ_TOLERANCE_HZ 0, PHASE 0.0, INSERT_VIP 0" *)
(* X_INTERFACE_INFO = "xilinx.com:signal:clock:1.0 M03_CLKIF CLK" *)
input wire M03_AXIS_ACLK;
(* X_INTERFACE_PARAMETER = "XIL_INTERFACENAME M04_CLKIF, FREQ_HZ 200000000, FREQ_TOLERANCE_HZ 0, PHASE 0.0, INSERT_VIP 0" *)
(* X_INTERFACE_INFO = "xilinx.com:signal:clock:1.0 M04_CLKIF CLK" *)
input wire M04_AXIS_ACLK;
(* X_INTERFACE_PARAMETER = "XIL_INTERFACENAME M00_RSTIF, POLARITY ACTIVE_LOW, INSERT_VIP 0" *)
(* X_INTERFACE_INFO = "xilinx.com:signal:reset:1.0 M00_RSTIF RST" *)
input wire M00_AXIS_ARESETN;
(* X_INTERFACE_PARAMETER = "XIL_INTERFACENAME M01_RSTIF, POLARITY ACTIVE_LOW, INSERT_VIP 0" *)
(* X_INTERFACE_INFO = "xilinx.com:signal:reset:1.0 M01_RSTIF RST" *)
input wire M01_AXIS_ARESETN;
(* X_INTERFACE_PARAMETER = "XIL_INTERFACENAME M02_RSTIF, POLARITY ACTIVE_LOW, INSERT_VIP 0" *)
(* X_INTERFACE_INFO = "xilinx.com:signal:reset:1.0 M02_RSTIF RST" *)
input wire M02_AXIS_ARESETN;
(* X_INTERFACE_PARAMETER = "XIL_INTERFACENAME M03_RSTIF, POLARITY ACTIVE_LOW, INSERT_VIP 0" *)
(* X_INTERFACE_INFO = "xilinx.com:signal:reset:1.0 M03_RSTIF RST" *)
input wire M03_AXIS_ARESETN;
(* X_INTERFACE_PARAMETER = "XIL_INTERFACENAME M04_RSTIF, POLARITY ACTIVE_LOW, INSERT_VIP 0" *)
(* X_INTERFACE_INFO = "xilinx.com:signal:reset:1.0 M04_RSTIF RST" *)
input wire M04_AXIS_ARESETN;
(* X_INTERFACE_INFO = "xilinx.com:interface:axis:1.0 M00_AXIS TVALID" *)
output wire M00_AXIS_TVALID;
(* X_INTERFACE_INFO = "xilinx.com:interface:axis:1.0 M01_AXIS TVALID" *)
output wire M01_AXIS_TVALID;
(* X_INTERFACE_INFO = "xilinx.com:interface:axis:1.0 M02_AXIS TVALID" *)
output wire M02_AXIS_TVALID;
(* X_INTERFACE_INFO = "xilinx.com:interface:axis:1.0 M03_AXIS TVALID" *)
output wire M03_AXIS_TVALID;
(* X_INTERFACE_INFO = "xilinx.com:interface:axis:1.0 M04_AXIS TVALID" *)
output wire M04_AXIS_TVALID;
(* X_INTERFACE_INFO = "xilinx.com:interface:axis:1.0 M00_AXIS TREADY" *)
input wire M00_AXIS_TREADY;
(* X_INTERFACE_INFO = "xilinx.com:interface:axis:1.0 M01_AXIS TREADY" *)
input wire M01_AXIS_TREADY;
(* X_INTERFACE_INFO = "xilinx.com:interface:axis:1.0 M02_AXIS TREADY" *)
input wire M02_AXIS_TREADY;
(* X_INTERFACE_INFO = "xilinx.com:interface:axis:1.0 M03_AXIS TREADY" *)
input wire M03_AXIS_TREADY;
(* X_INTERFACE_INFO = "xilinx.com:interface:axis:1.0 M04_AXIS TREADY" *)
input wire M04_AXIS_TREADY;
(* X_INTERFACE_INFO = "xilinx.com:interface:axis:1.0 M00_AXIS TDATA" *)
output wire [31 : 0] M00_AXIS_TDATA;
(* X_INTERFACE_INFO = "xilinx.com:interface:axis:1.0 M01_AXIS TDATA" *)
output wire [31 : 0] M01_AXIS_TDATA;
(* X_INTERFACE_INFO = "xilinx.com:interface:axis:1.0 M02_AXIS TDATA" *)
output wire [31 : 0] M02_AXIS_TDATA;
(* X_INTERFACE_INFO = "xilinx.com:interface:axis:1.0 M03_AXIS TDATA" *)
output wire [31 : 0] M03_AXIS_TDATA;
(* X_INTERFACE_INFO = "xilinx.com:interface:axis:1.0 M04_AXIS TDATA" *)
output wire [31 : 0] M04_AXIS_TDATA;
(* X_INTERFACE_INFO = "xilinx.com:interface:axis:1.0 M00_AXIS TLAST" *)
output wire M00_AXIS_TLAST;
(* X_INTERFACE_INFO = "xilinx.com:interface:axis:1.0 M01_AXIS TLAST" *)
output wire M01_AXIS_TLAST;
(* X_INTERFACE_INFO = "xilinx.com:interface:axis:1.0 M02_AXIS TLAST" *)
output wire M02_AXIS_TLAST;
(* X_INTERFACE_INFO = "xilinx.com:interface:axis:1.0 M03_AXIS TLAST" *)
output wire M03_AXIS_TLAST;
(* X_INTERFACE_INFO = "xilinx.com:interface:axis:1.0 M04_AXIS TLAST" *)
output wire M04_AXIS_TLAST;
(* X_INTERFACE_INFO = "xilinx.com:interface:axis:1.0 M00_AXIS TDEST" *)
output wire [7 : 0] M00_AXIS_TDEST;
(* X_INTERFACE_INFO = "xilinx.com:interface:axis:1.0 M01_AXIS TDEST" *)
output wire [7 : 0] M01_AXIS_TDEST;
(* X_INTERFACE_INFO = "xilinx.com:interface:axis:1.0 M02_AXIS TDEST" *)
output wire [7 : 0] M02_AXIS_TDEST;
(* X_INTERFACE_INFO = "xilinx.com:interface:axis:1.0 M03_AXIS TDEST" *)
output wire [7 : 0] M03_AXIS_TDEST;
(* X_INTERFACE_INFO = "xilinx.com:interface:axis:1.0 M04_AXIS TDEST" *)
output wire [7 : 0] M04_AXIS_TDEST;
(* X_INTERFACE_PARAMETER = "XIL_INTERFACENAME M00_AXIS, TDATA_NUM_BYTES 4, TDEST_WIDTH 8, TID_WIDTH 0, TUSER_WIDTH 4, HAS_TREADY 1, HAS_TSTRB 0, HAS_TKEEP 0, HAS_TLAST 1, FREQ_HZ 100000000, PHASE 0.0, LAYERED_METADATA undef, INSERT_VIP 0" *)
(* X_INTERFACE_INFO = "xilinx.com:interface:axis:1.0 M00_AXIS TUSER" *)
output wire [3 : 0] M00_AXIS_TUSER;
(* X_INTERFACE_PARAMETER = "XIL_INTERFACENAME M01_AXIS, TDATA_NUM_BYTES 4, TDEST_WIDTH 8, TID_WIDTH 0, TUSER_WIDTH 4, HAS_TREADY 1, HAS_TSTRB 0, HAS_TKEEP 0, HAS_TLAST 1, FREQ_HZ 100000000, PHASE 0.0, LAYERED_METADATA undef, INSERT_VIP 0" *)
(* X_INTERFACE_INFO = "xilinx.com:interface:axis:1.0 M01_AXIS TUSER" *)
output wire [3 : 0] M01_AXIS_TUSER;
(* X_INTERFACE_PARAMETER = "XIL_INTERFACENAME M02_AXIS, TDATA_NUM_BYTES 4, TDEST_WIDTH 8, TID_WIDTH 0, TUSER_WIDTH 4, HAS_TREADY 1, HAS_TSTRB 0, HAS_TKEEP 0, HAS_TLAST 1, FREQ_HZ 100000000, PHASE 0.0, LAYERED_METADATA undef, INSERT_VIP 0" *)
(* X_INTERFACE_INFO = "xilinx.com:interface:axis:1.0 M02_AXIS TUSER" *)
output wire [3 : 0] M02_AXIS_TUSER;
(* X_INTERFACE_PARAMETER = "XIL_INTERFACENAME M03_AXIS, TDATA_NUM_BYTES 4, TDEST_WIDTH 8, TID_WIDTH 0, TUSER_WIDTH 4, HAS_TREADY 1, HAS_TSTRB 0, HAS_TKEEP 0, HAS_TLAST 1, FREQ_HZ 100000000, PHASE 0.0, LAYERED_METADATA undef, INSERT_VIP 0" *)
(* X_INTERFACE_INFO = "xilinx.com:interface:axis:1.0 M03_AXIS TUSER" *)
output wire [3 : 0] M03_AXIS_TUSER;
(* X_INTERFACE_PARAMETER = "XIL_INTERFACENAME M04_AXIS, TDATA_NUM_BYTES 4, TDEST_WIDTH 8, TID_WIDTH 0, TUSER_WIDTH 4, HAS_TREADY 1, HAS_TSTRB 0, HAS_TKEEP 0, HAS_TLAST 1, FREQ_HZ 100000000, PHASE 0.0, LAYERED_METADATA undef, INSERT_VIP 0" *)
(* X_INTERFACE_INFO = "xilinx.com:interface:axis:1.0 M04_AXIS TUSER" *)
output wire [3 : 0] M04_AXIS_TUSER;
output wire S00_DECODE_ERR;
output wire [31 : 0] S00_FIFO_DATA_COUNT;
output wire M01_SPARSE_TKEEP_REMOVED;
output wire M02_SPARSE_TKEEP_REMOVED;
output wire M03_SPARSE_TKEEP_REMOVED;
output wire M04_SPARSE_TKEEP_REMOVED;

  axis_interconnect_v1_1_22_axis_interconnect_16x16_top #(
    .C_FAMILY("spartan7"),
    .C_NUM_MI_SLOTS(5),
    .C_NUM_SI_SLOTS(1),
    .C_SWITCH_MI_REG_CONFIG(1),
    .C_SWITCH_SI_REG_CONFIG(1),
    .C_SWITCH_MODE(1),
    .C_SWITCH_MAX_XFERS_PER_ARB(1),
    .C_SWITCH_NUM_CYCLES_TIMEOUT(0),
    .C_SWITCH_TDATA_WIDTH(32),
    .C_SWITCH_TID_WIDTH(1),
    .C_SWITCH_TDEST_WIDTH(8),
    .C_SWITCH_TUSER_WIDTH(4),
    .C_SWITCH_SIGNAL_SET(32'H000000D3),
    .C_SWITCH_ACLK_RATIO(12),
    .C_SWITCH_USE_ACLKEN(0),
    .C_SYNCHRONIZER_STAGE(2),
    .C_M00_AXIS_CONNECTIVITY(16'H0001),
    .C_M01_AXIS_CONNECTIVITY(16'H0001),
    .C_M02_AXIS_CONNECTIVITY(16'H0001),
    .C_M03_AXIS_CONNECTIVITY(16'H0001),
    .C_M04_AXIS_CONNECTIVITY(16'H0001),
    .C_M05_AXIS_CONNECTIVITY(16'H0000),
    .C_M06_AXIS_CONNECTIVITY(16'H0000),
    .C_M07_AXIS_CONNECTIVITY(16'H0000),
    .C_M08_AXIS_CONNECTIVITY(16'H0000),
    .C_M09_AXIS_CONNECTIVITY(16'H0000),
    .C_M10_AXIS_CONNECTIVITY(16'H0000),
    .C_M11_AXIS_CONNECTIVITY(16'H0000),
    .C_M12_AXIS_CONNECTIVITY(16'H0000),
    .C_M13_AXIS_CONNECTIVITY(16'H0000),
    .C_M14_AXIS_CONNECTIVITY(16'H0000),
    .C_M15_AXIS_CONNECTIVITY(16'H0000),
    .C_M00_AXIS_BASETDEST(32'H00000000),
    .C_M01_AXIS_BASETDEST(32'H00000001),
    .C_M02_AXIS_BASETDEST(32'H00000002),
    .C_M03_AXIS_BASETDEST(32'H00000003),
    .C_M04_AXIS_BASETDEST(32'H00000004),
    .C_M05_AXIS_BASETDEST(32'H00000005),
    .C_M06_AXIS_BASETDEST(32'H00000006),
    .C_M07_AXIS_BASETDEST(32'H00000007),
    .C_M08_AXIS_BASETDEST(32'H00000008),
    .C_M09_AXIS_BASETDEST(32'H00000009),
    .C_M10_AXIS_BASETDEST(32'H0000000A),
    .C_M11_AXIS_BASETDEST(32'H0000000B),
    .C_M12_AXIS_BASETDEST(32'H0000000C),
    .C_M13_AXIS_BASETDEST(32'H0000000D),
    .C_M14_AXIS_BASETDEST(32'H0000000E),
    .C_M15_AXIS_BASETDEST(32'H0000000F),
    .C_M00_AXIS_HIGHTDEST(32'H00000000),
    .C_M01_AXIS_HIGHTDEST(32'H00000001),
    .C_M02_AXIS_HIGHTDEST(32'H00000002),
    .C_M03_AXIS_HIGHTDEST(32'H00000003),
    .C_M04_AXIS_HIGHTDEST(32'H00000004),
    .C_M05_AXIS_HIGHTDEST(32'H00000005),
    .C_M06_AXIS_HIGHTDEST(32'H00000006),
    .C_M07_AXIS_HIGHTDEST(32'H00000007),
    .C_M08_AXIS_HIGHTDEST(32'H00000008),
    .C_M09_AXIS_HIGHTDEST(32'H00000009),
    .C_M10_AXIS_HIGHTDEST(32'H0000000A),
    .C_M11_AXIS_HIGHTDEST(32'H0000000B),
    .C_M12_AXIS_HIGHTDEST(32'H0000000C),
    .C_M13_AXIS_HIGHTDEST(32'H0000000D),
    .C_M14_AXIS_HIGHTDEST(32'H0000000E),
    .C_M15_AXIS_HIGHTDEST(32'H0000000F),
    .C_S00_AXIS_TDATA_WIDTH(32),
    .C_S01_AXIS_TDATA_WIDTH(8),
    .C_S02_AXIS_TDATA_WIDTH(8),
    .C_S03_AXIS_TDATA_WIDTH(8),
    .C_S04_AXIS_TDATA_WIDTH(8),
    .C_S05_AXIS_TDATA_WIDTH(8),
    .C_S06_AXIS_TDATA_WIDTH(8),
    .C_S07_AXIS_TDATA_WIDTH(8),
    .C_S08_AXIS_TDATA_WIDTH(8),
    .C_S09_AXIS_TDATA_WIDTH(8),
    .C_S10_AXIS_TDATA_WIDTH(8),
    .C_S11_AXIS_TDATA_WIDTH(8),
    .C_S12_AXIS_TDATA_WIDTH(8),
    .C_S13_AXIS_TDATA_WIDTH(8),
    .C_S14_AXIS_TDATA_WIDTH(8),
    .C_S15_AXIS_TDATA_WIDTH(8),
    .C_S00_AXIS_TUSER_WIDTH(4),
    .C_S01_AXIS_TUSER_WIDTH(1),
    .C_S02_AXIS_TUSER_WIDTH(1),
    .C_S03_AXIS_TUSER_WIDTH(1),
    .C_S04_AXIS_TUSER_WIDTH(1),
    .C_S05_AXIS_TUSER_WIDTH(1),
    .C_S06_AXIS_TUSER_WIDTH(1),
    .C_S07_AXIS_TUSER_WIDTH(1),
    .C_S08_AXIS_TUSER_WIDTH(1),
    .C_S09_AXIS_TUSER_WIDTH(1),
    .C_S10_AXIS_TUSER_WIDTH(1),
    .C_S11_AXIS_TUSER_WIDTH(1),
    .C_S12_AXIS_TUSER_WIDTH(1),
    .C_S13_AXIS_TUSER_WIDTH(1),
    .C_S14_AXIS_TUSER_WIDTH(1),
    .C_S15_AXIS_TUSER_WIDTH(1),
    .C_S00_AXIS_IS_ACLK_ASYNC(0),
    .C_S01_AXIS_IS_ACLK_ASYNC(0),
    .C_S02_AXIS_IS_ACLK_ASYNC(0),
    .C_S03_AXIS_IS_ACLK_ASYNC(0),
    .C_S04_AXIS_IS_ACLK_ASYNC(0),
    .C_S05_AXIS_IS_ACLK_ASYNC(0),
    .C_S06_AXIS_IS_ACLK_ASYNC(0),
    .C_S07_AXIS_IS_ACLK_ASYNC(0),
    .C_S08_AXIS_IS_ACLK_ASYNC(0),
    .C_S09_AXIS_IS_ACLK_ASYNC(0),
    .C_S10_AXIS_IS_ACLK_ASYNC(0),
    .C_S11_AXIS_IS_ACLK_ASYNC(0),
    .C_S12_AXIS_IS_ACLK_ASYNC(0),
    .C_S13_AXIS_IS_ACLK_ASYNC(0),
    .C_S14_AXIS_IS_ACLK_ASYNC(0),
    .C_S15_AXIS_IS_ACLK_ASYNC(0),
    .C_S00_AXIS_ACLK_RATIO(12),
    .C_S01_AXIS_ACLK_RATIO(12),
    .C_S02_AXIS_ACLK_RATIO(12),
    .C_S03_AXIS_ACLK_RATIO(12),
    .C_S04_AXIS_ACLK_RATIO(12),
    .C_S05_AXIS_ACLK_RATIO(12),
    .C_S06_AXIS_ACLK_RATIO(12),
    .C_S07_AXIS_ACLK_RATIO(12),
    .C_S08_AXIS_ACLK_RATIO(12),
    .C_S09_AXIS_ACLK_RATIO(12),
    .C_S10_AXIS_ACLK_RATIO(12),
    .C_S11_AXIS_ACLK_RATIO(12),
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
    .M06_FIFO_DATA_COUNT(),
    .M07_FIFO_DATA_COUNT(),
    .M08_FIFO_DATA_COUNT(),
    .M09_FIFO_DATA_COUNT(),
    .M10_FIFO_DATA_COUNT(),
    .M11_FIFO_DATA_COUNT(),
    .M12_FIFO_DATA_COUNT(),
    .M13_FIFO_DATA_COUNT(),
    .M14_FIFO_DATA_COUNT(),
    .M15_FIFO_DATA_COUNT()
  );
endmodule
