xvrxvr/fpga-osc/interface.gen/sources_1/ip/dsp_macro_mul_add/hdl/dsp_macro_v1_0_rfs.vhd

`protect begin_protected
`protect version = 1
`protect encrypt_agent = "XILINX"
`protect encrypt_agent_info = "Xilinx Encryption Tool 2023.2.2"
`protect key_keyowner = "Synopsys", key_keyname = "SNPS-VCS-RSA-2", key_method = "rsa"
`protect encoding = (enctype = "BASE64", line_length = 76, bytes = 128)
`protect key_block
agsGjm2IdCdfCeffmuWBXU/adr/trfZAhXkdQBcMVEi6Sa5BmzXDJXlkvpFoSsxfnwfsJ/wLkDqH
t4nG//DauYCpq8w+X2KwkCuJvY3NynWZUSinjYLyLJr+jMJjbYyZ1Bq80SY/oBRZpXvf1RtZltmm
Wle/Nam/GKVfM253IUc=

`protect key_keyowner = "Aldec", key_keyname = "ALDEC15_001", key_method = "rsa"
`protect encoding = (enctype = "BASE64", line_length = 76, bytes = 256)
`protect key_block
PXZ4L4Q3vZwoqlIjLbWdkq2bBIfeejwyY9s2VbVZ/1ZIMNaXf8eA3iBA2CaIxit6zvehoQLLd0L6
9x9YEwHncEwGD3Bll1gAe9yaRP8z2J1KQJlRh9uHAs1QBBovBMIHwHXWgz8CPui1hN1ziqX/ccfh
/3/ug+IGtCTyLhBytHHSAEYOf/4qU/6cKzHdDaIDcs6k1FPG5R3+SLQsQZKEW7LuFvdb1U6wdm3K
EjiTnHXTCuVKxejjjNToC+LmSlGcG1qJELjmRE/vCksc542z5RVOzEW8j6Zv+1A5ieeNmChVT25r
q+5Dm2ydJ/EmivXIFJh6jVjMAXeOYw0XhNcR/g==

`protect key_keyowner = "Mentor Graphics Corporation", key_keyname = "MGC-VELOCE-RSA", key_method = "rsa"
`protect encoding = (enctype = "BASE64", line_length = 76, bytes = 128)
`protect key_block
oaJJqK77aCzpGRDAY6wQzvhaxtP0QeSu88sIQg2GiyNEfYIw9K8L1aLQo5dzwOfkYV/89w71y4OH
z9e7qtEAF4W3a2ynZKETDTZeeiWmqXE7tbfIVjjoALWxwaB7WJMDXNde3efitWl7ojkHDKJ8XZpu
vBLz2BljbRh427ZP5sc=

`protect key_keyowner = "Mentor Graphics Corporation", key_keyname = "MGC-VERIF-SIM-RSA-2", key_method = "rsa"
`protect encoding = (enctype = "BASE64", line_length = 76, bytes = 256)
`protect key_block
c2DTL/fOQNM53/OgnyoZSJ9JQU7pqtlLg6hBIlFzUe3FhxcD3QsQny/a7SnuVBqWXsACVTXz5s5P
sd+mJYCxIJ1COrFnZytBDWB6COoIvLHPIWr8UiGcoCjQJe/q0Jsso/xFpaEHK9+wBUR/xWksQvjz
w4QdMVJwDsSep4mw7qs9A8Xcq+0Qw+A68HVoncKBwChLhc/z42YC2QSg42Bo8RWdGI8Mv9dfKH93
9S4mlXwgCuuh5R6s7M92aeY9D+6eZEEBP7gJEmBFfdRuJbhqiii/2qF/qwpc2LECHvRBCqZ9iHmk
q6FKf1II8plRweRYSX1hlQ9nZ7brRWvuYtARzQ==

`protect key_keyowner = "Real Intent", key_keyname = "RI-RSA-KEY-1", key_method = "rsa"
`protect encoding = (enctype = "BASE64", line_length = 76, bytes = 256)
`protect key_block
gVJ9hBjWRdF+5w/6m9CKqNscBsC0KDB4NHkplpnmLXqoUljCpbKaF0zbK+GvNrs72dOKEFLYacJS
ApUVgavYohnNsMmSgeCUi0DXxeH8x4WLhmJnAumQT+rvdW+4P0foi/p4qpDgC1EelHDi5WEioc7N
9/mA9ic8q+giZCoWKaNibbc4VBNHpjhdNZSjT8Mjezrpd3XTxsT6RpPbJH1fv0CYpwOdjM6vqu6Z
lWFoMuCHo0bjQ1xmzYHf9+bPouRpzS4QAdlXRFAKIlGvaN8yznul3ZoHWvwDwgfA0yOANektCfY+
z2Wm1iFsgwxmfnH33Vd7304va+D4CMqybL664g==

`protect key_keyowner = "Xilinx", key_keyname = "xilinxt_2022_10", key_method = "rsa"
`protect encoding = (enctype = "BASE64", line_length = 76, bytes = 256)
`protect key_block
dNFjSJ+pQ79GN7CpOM24QWmaMs1JvQfwLdClbjrpt9Je2DzReow+zP1dY9KBbxn2amHKV4Ah9ZWv
xDdaaazD80gf2TIptiAppVXkA03TZrfdGyDVZQqdYnIXbEnmK8zz59EEwO80Oart986/WyCpL/wC
2FMuRBQqbLLLQiDQfnPKdKMUDy4yyuMhn0uC3HP7L1oQajItcis/bXuCE+j9LJZ1QxyDizG2rWax
NEev5OZuXqBVW+dK7XP4JRn0EnkP3H0kvkHWsxRVOPgUeVgT6mj1DAmATBv4+VrFn+8Zw0Hob7YM
7rfr7lIFMB2tBG4QKSfIiG3IvgEFhcVdVGkQYg==

`protect key_keyowner = "Metrics Technologies Inc.", key_keyname = "DSim", key_method = "rsa"
`protect encoding = (enctype = "BASE64", line_length = 76, bytes = 256)
`protect key_block
NckIg6il1+wtOs9NTulaalRO/n7UseapUVUfy6tCsAgSh0Oxr+yBbwDL1lnjevvsIjv7HemvPbbb
79p/vlLnqbLqdeLebUR0L6XxLi3zX7jQxZ19igCkin0brwYdLnYXumpBewzOxkuiww18VdxKBa1q
WlWf0G5goUgP0oVlnL4pfO+BVj7LYC2SvRkrS8VFtPU794+WEvwtg/I7yaA+NCiOVeH79td/ARyv
j6oGOxNZrfBcGN+Y1ya+YHNOMGmePWwc4g2MX3Aypp57+iXR0R1MrxgWxRaMNnBYhUFxh5z6Aj9e
fMRjbMZe+YiuHrEBs+kAYB4s4G8EV2VAnLplWQ==

`protect key_keyowner = "Atrenta", key_keyname = "ATR-SG-RSA-1", key_method = "rsa"
`protect encoding = (enctype = "BASE64", line_length = 76, bytes = 384)
`protect key_block
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

`protect key_keyowner = "Cadence Design Systems.", key_keyname = "CDS_RSA_KEY_VER_1", key_method = "rsa"
`protect encoding = (enctype = "BASE64", line_length = 76, bytes = 256)
`protect key_block
Dr5WovxVHTbKmkcwMxFozPSnv2J4w7sen4PtQgRnovNgb40b5DG+Jg5s5Lpf/dpWkKzS6SQM0kmt
z7O2vdpmSqfJX0HcYmzUZwpFAnZEThwVSax22VJj3l5+a9FANIAtrQqAzNAXV3fTf/KmxZxag2a6
ExqnQ1NIqEGrHIj+Cr6eTIXM8jioboVguess7XDOKEHBUXGV8GzOkV+zSR3HtLvOPpcaIn4taC5n
GwJywPNKenz+ZCnylj45Yqe7AUG60a8LgWbm6F8f1Sinz1E/S2MuQlti+paEJaA9bYj1GVUvDB0o
rRBNh4MLp49Uyu58xqH9kyH+MAGKnCA1j42PcA==

`protect data_method = "AES128-CBC"
`protect encoding = (enctype = "BASE64", line_length = 76, bytes = 271216)
`protect data_block
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
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
