xvrxvr/fpga-osc/interface.gen/sources_1/ip/clk_wiz_main/clk_wiz_main_sim_netlist.vhdl

-- Copyright 1986-2022 Xilinx, Inc. All Rights Reserved.
-- Copyright 2022-2024 Advanced Micro Devices, Inc. All Rights Reserved.
-- --------------------------------------------------------------------------------
-- Tool Version: Vivado v.2023.2.2 (win64) Build 4126759 Thu Feb  8 23:53:51 MST 2024
-- Date        : Tue Mar 12 11:36:25 2024
-- Host        : DESKTOP-JRU94P5 running 64-bit major release  (build 9200)
-- Command     : write_vhdl -force -mode funcsim
--               w:/home/roman/FPGA-HAT/fw/interface/interface.gen/sources_1/ip/clk_wiz_main/clk_wiz_main_sim_netlist.vhdl
-- Design      : clk_wiz_main
-- Purpose     : This VHDL netlist is a functional simulation representation of the design and should not be modified or
--               synthesized. This netlist cannot be used for SDF annotated simulation.
-- Device      : xc7s6ftgb196-1
-- --------------------------------------------------------------------------------
library IEEE;
use IEEE.STD_LOGIC_1164.ALL;
library UNISIM;
use UNISIM.VCOMPONENTS.ALL;
entity clk_wiz_main_clk_wiz is
  port (
    clk_out1 : out STD_LOGIC;
    clk_in1 : in STD_LOGIC
  );
end clk_wiz_main_clk_wiz;

architecture STRUCTURE of clk_wiz_main_clk_wiz is
  signal clk_in1_clk_wiz_main : STD_LOGIC;
  signal clk_out1_clk_wiz_main : STD_LOGIC;
  signal clk_out1_clk_wiz_main_en_clk : STD_LOGIC;
  signal clkfbout_buf_clk_wiz_main : STD_LOGIC;
  signal clkfbout_clk_wiz_main : STD_LOGIC;
  signal locked_int : STD_LOGIC;
  signal seq_reg1 : STD_LOGIC_VECTOR ( 7 downto 0 );
  attribute RTL_KEEP : string;
  attribute RTL_KEEP of seq_reg1 : signal is "true";
  attribute async_reg : string;
  attribute async_reg of seq_reg1 : signal is "true";
  signal NLW_mmcm_adv_inst_CLKFBOUTB_UNCONNECTED : STD_LOGIC;
  signal NLW_mmcm_adv_inst_CLKFBSTOPPED_UNCONNECTED : STD_LOGIC;
  signal NLW_mmcm_adv_inst_CLKINSTOPPED_UNCONNECTED : STD_LOGIC;
  signal NLW_mmcm_adv_inst_CLKOUT0B_UNCONNECTED : STD_LOGIC;
  signal NLW_mmcm_adv_inst_CLKOUT1_UNCONNECTED : STD_LOGIC;
  signal NLW_mmcm_adv_inst_CLKOUT1B_UNCONNECTED : STD_LOGIC;
  signal NLW_mmcm_adv_inst_CLKOUT2_UNCONNECTED : STD_LOGIC;
  signal NLW_mmcm_adv_inst_CLKOUT2B_UNCONNECTED : STD_LOGIC;
  signal NLW_mmcm_adv_inst_CLKOUT3_UNCONNECTED : STD_LOGIC;
  signal NLW_mmcm_adv_inst_CLKOUT3B_UNCONNECTED : STD_LOGIC;
  signal NLW_mmcm_adv_inst_CLKOUT4_UNCONNECTED : STD_LOGIC;
  signal NLW_mmcm_adv_inst_CLKOUT5_UNCONNECTED : STD_LOGIC;
  signal NLW_mmcm_adv_inst_CLKOUT6_UNCONNECTED : STD_LOGIC;
  signal NLW_mmcm_adv_inst_DRDY_UNCONNECTED : STD_LOGIC;
  signal NLW_mmcm_adv_inst_PSDONE_UNCONNECTED : STD_LOGIC;
  signal NLW_mmcm_adv_inst_DO_UNCONNECTED : STD_LOGIC_VECTOR ( 15 downto 0 );
  attribute BOX_TYPE : string;
  attribute BOX_TYPE of clkf_buf : label is "PRIMITIVE";
  attribute BOX_TYPE of clkin1_ibufg : label is "PRIMITIVE";
  attribute CAPACITANCE : string;
  attribute CAPACITANCE of clkin1_ibufg : label is "DONT_CARE";
  attribute IBUF_DELAY_VALUE : string;
  attribute IBUF_DELAY_VALUE of clkin1_ibufg : label is "0";
  attribute IFD_DELAY_VALUE : string;
  attribute IFD_DELAY_VALUE of clkin1_ibufg : label is "AUTO";
  attribute BOX_TYPE of clkout1_buf : label is "PRIMITIVE";
  attribute XILINX_LEGACY_PRIM : string;
  attribute XILINX_LEGACY_PRIM of clkout1_buf : label is "BUFGCE";
  attribute XILINX_TRANSFORM_PINMAP : string;
  attribute XILINX_TRANSFORM_PINMAP of clkout1_buf : label is "CE:CE0 I:I0 GND:S1,IGNORE0,CE1 VCC:S0,IGNORE1,I1";
  attribute BOX_TYPE of clkout1_buf_en : label is "PRIMITIVE";
  attribute BOX_TYPE of mmcm_adv_inst : label is "PRIMITIVE";
  attribute ASYNC_REG_boolean : boolean;
  attribute ASYNC_REG_boolean of \seq_reg1_reg[0]\ : label is std.standard.true;
  attribute KEEP : string;
  attribute KEEP of \seq_reg1_reg[0]\ : label is "yes";
  attribute ASYNC_REG_boolean of \seq_reg1_reg[1]\ : label is std.standard.true;
  attribute KEEP of \seq_reg1_reg[1]\ : label is "yes";
  attribute ASYNC_REG_boolean of \seq_reg1_reg[2]\ : label is std.standard.true;
  attribute KEEP of \seq_reg1_reg[2]\ : label is "yes";
  attribute ASYNC_REG_boolean of \seq_reg1_reg[3]\ : label is std.standard.true;
  attribute KEEP of \seq_reg1_reg[3]\ : label is "yes";
  attribute ASYNC_REG_boolean of \seq_reg1_reg[4]\ : label is std.standard.true;
  attribute KEEP of \seq_reg1_reg[4]\ : label is "yes";
  attribute ASYNC_REG_boolean of \seq_reg1_reg[5]\ : label is std.standard.true;
  attribute KEEP of \seq_reg1_reg[5]\ : label is "yes";
  attribute ASYNC_REG_boolean of \seq_reg1_reg[6]\ : label is std.standard.true;
  attribute KEEP of \seq_reg1_reg[6]\ : label is "yes";
  attribute ASYNC_REG_boolean of \seq_reg1_reg[7]\ : label is std.standard.true;
  attribute KEEP of \seq_reg1_reg[7]\ : label is "yes";
begin
clkf_buf: unisim.vcomponents.BUFG
     port map (
      I => clkfbout_clk_wiz_main,
      O => clkfbout_buf_clk_wiz_main
    );
clkin1_ibufg: unisim.vcomponents.IBUF
    generic map(
      IOSTANDARD => "DEFAULT"
    )
        port map (
      I => clk_in1,
      O => clk_in1_clk_wiz_main
    );
clkout1_buf: unisim.vcomponents.BUFGCTRL
    generic map(
      INIT_OUT => 0,
      PRESELECT_I0 => true,
      PRESELECT_I1 => false,
      SIM_DEVICE => "7SERIES"
    )
        port map (
      CE0 => seq_reg1(7),
      CE1 => '0',
      I0 => clk_out1_clk_wiz_main,
      I1 => '1',
      IGNORE0 => '0',
      IGNORE1 => '1',
      O => clk_out1,
      S0 => '1',
      S1 => '0'
    );
clkout1_buf_en: unisim.vcomponents.BUFH
     port map (
      I => clk_out1_clk_wiz_main,
      O => clk_out1_clk_wiz_main_en_clk
    );
mmcm_adv_inst: unisim.vcomponents.MMCME2_ADV
    generic map(
      BANDWIDTH => "HIGH",
      CLKFBOUT_MULT_F => 59.375000,
      CLKFBOUT_PHASE => 0.000000,
      CLKFBOUT_USE_FINE_PS => false,
      CLKIN1_PERIOD => 50.000000,
      CLKIN2_PERIOD => 0.000000,
      CLKOUT0_DIVIDE_F => 11.875000,
      CLKOUT0_DUTY_CYCLE => 0.500000,
      CLKOUT0_PHASE => 0.000000,
      CLKOUT0_USE_FINE_PS => false,
      CLKOUT1_DIVIDE => 1,
      CLKOUT1_DUTY_CYCLE => 0.500000,
      CLKOUT1_PHASE => 0.000000,
      CLKOUT1_USE_FINE_PS => false,
      CLKOUT2_DIVIDE => 1,
      CLKOUT2_DUTY_CYCLE => 0.500000,
      CLKOUT2_PHASE => 0.000000,
      CLKOUT2_USE_FINE_PS => false,
      CLKOUT3_DIVIDE => 1,
      CLKOUT3_DUTY_CYCLE => 0.500000,
      CLKOUT3_PHASE => 0.000000,
      CLKOUT3_USE_FINE_PS => false,
      CLKOUT4_CASCADE => false,
      CLKOUT4_DIVIDE => 1,
      CLKOUT4_DUTY_CYCLE => 0.500000,
      CLKOUT4_PHASE => 0.000000,
      CLKOUT4_USE_FINE_PS => false,
      CLKOUT5_DIVIDE => 1,
      CLKOUT5_DUTY_CYCLE => 0.500000,
      CLKOUT5_PHASE => 0.000000,
      CLKOUT5_USE_FINE_PS => false,
      CLKOUT6_DIVIDE => 1,
      CLKOUT6_DUTY_CYCLE => 0.500000,
      CLKOUT6_PHASE => 0.000000,
      CLKOUT6_USE_FINE_PS => false,
      COMPENSATION => "ZHOLD",
      DIVCLK_DIVIDE => 1,
      IS_CLKINSEL_INVERTED => '0',
      IS_PSEN_INVERTED => '0',
      IS_PSINCDEC_INVERTED => '0',
      IS_PWRDWN_INVERTED => '0',
      IS_RST_INVERTED => '0',
      REF_JITTER1 => 0.010000,
      REF_JITTER2 => 0.010000,
      SS_EN => "FALSE",
      SS_MODE => "CENTER_HIGH",
      SS_MOD_PERIOD => 10000,
      STARTUP_WAIT => false
    )
        port map (
      CLKFBIN => clkfbout_buf_clk_wiz_main,
      CLKFBOUT => clkfbout_clk_wiz_main,
      CLKFBOUTB => NLW_mmcm_adv_inst_CLKFBOUTB_UNCONNECTED,
      CLKFBSTOPPED => NLW_mmcm_adv_inst_CLKFBSTOPPED_UNCONNECTED,
      CLKIN1 => clk_in1_clk_wiz_main,
      CLKIN2 => '0',
      CLKINSEL => '1',
      CLKINSTOPPED => NLW_mmcm_adv_inst_CLKINSTOPPED_UNCONNECTED,
      CLKOUT0 => clk_out1_clk_wiz_main,
      CLKOUT0B => NLW_mmcm_adv_inst_CLKOUT0B_UNCONNECTED,
      CLKOUT1 => NLW_mmcm_adv_inst_CLKOUT1_UNCONNECTED,
      CLKOUT1B => NLW_mmcm_adv_inst_CLKOUT1B_UNCONNECTED,
      CLKOUT2 => NLW_mmcm_adv_inst_CLKOUT2_UNCONNECTED,
      CLKOUT2B => NLW_mmcm_adv_inst_CLKOUT2B_UNCONNECTED,
      CLKOUT3 => NLW_mmcm_adv_inst_CLKOUT3_UNCONNECTED,
      CLKOUT3B => NLW_mmcm_adv_inst_CLKOUT3B_UNCONNECTED,
      CLKOUT4 => NLW_mmcm_adv_inst_CLKOUT4_UNCONNECTED,
      CLKOUT5 => NLW_mmcm_adv_inst_CLKOUT5_UNCONNECTED,
      CLKOUT6 => NLW_mmcm_adv_inst_CLKOUT6_UNCONNECTED,
      DADDR(6 downto 0) => B"0000000",
      DCLK => '0',
      DEN => '0',
      DI(15 downto 0) => B"0000000000000000",
      DO(15 downto 0) => NLW_mmcm_adv_inst_DO_UNCONNECTED(15 downto 0),
      DRDY => NLW_mmcm_adv_inst_DRDY_UNCONNECTED,
      DWE => '0',
      LOCKED => locked_int,
      PSCLK => '0',
      PSDONE => NLW_mmcm_adv_inst_PSDONE_UNCONNECTED,
      PSEN => '0',
      PSINCDEC => '0',
      PWRDWN => '0',
      RST => '0'
    );
\seq_reg1_reg[0]\: unisim.vcomponents.FDRE
    generic map(
      INIT => '0'
    )
        port map (
      C => clk_out1_clk_wiz_main_en_clk,
      CE => '1',
      D => locked_int,
      Q => seq_reg1(0),
      R => '0'
    );
\seq_reg1_reg[1]\: unisim.vcomponents.FDRE
    generic map(
      INIT => '0'
    )
        port map (
      C => clk_out1_clk_wiz_main_en_clk,
      CE => '1',
      D => seq_reg1(0),
      Q => seq_reg1(1),
      R => '0'
    );
\seq_reg1_reg[2]\: unisim.vcomponents.FDRE
    generic map(
      INIT => '0'
    )
        port map (
      C => clk_out1_clk_wiz_main_en_clk,
      CE => '1',
      D => seq_reg1(1),
      Q => seq_reg1(2),
      R => '0'
    );
\seq_reg1_reg[3]\: unisim.vcomponents.FDRE
    generic map(
      INIT => '0'
    )
        port map (
      C => clk_out1_clk_wiz_main_en_clk,
      CE => '1',
      D => seq_reg1(2),
      Q => seq_reg1(3),
      R => '0'
    );
\seq_reg1_reg[4]\: unisim.vcomponents.FDRE
    generic map(
      INIT => '0'
    )
        port map (
      C => clk_out1_clk_wiz_main_en_clk,
      CE => '1',
      D => seq_reg1(3),
      Q => seq_reg1(4),
      R => '0'
    );
\seq_reg1_reg[5]\: unisim.vcomponents.FDRE
    generic map(
      INIT => '0'
    )
        port map (
      C => clk_out1_clk_wiz_main_en_clk,
      CE => '1',
      D => seq_reg1(4),
      Q => seq_reg1(5),
      R => '0'
    );
\seq_reg1_reg[6]\: unisim.vcomponents.FDRE
    generic map(
      INIT => '0'
    )
        port map (
      C => clk_out1_clk_wiz_main_en_clk,
      CE => '1',
      D => seq_reg1(5),
      Q => seq_reg1(6),
      R => '0'
    );
\seq_reg1_reg[7]\: unisim.vcomponents.FDRE
    generic map(
      INIT => '0'
    )
        port map (
      C => clk_out1_clk_wiz_main_en_clk,
      CE => '1',
      D => seq_reg1(6),
      Q => seq_reg1(7),
      R => '0'
    );
end STRUCTURE;
library IEEE;
use IEEE.STD_LOGIC_1164.ALL;
library UNISIM;
use UNISIM.VCOMPONENTS.ALL;
entity clk_wiz_main is
  port (
    clk_out1 : out STD_LOGIC;
    clk_in1 : in STD_LOGIC
  );
  attribute NotValidForBitStream : boolean;
  attribute NotValidForBitStream of clk_wiz_main : entity is true;
end clk_wiz_main;

architecture STRUCTURE of clk_wiz_main is
begin
inst: entity work.clk_wiz_main_clk_wiz
     port map (
      clk_in1 => clk_in1,
      clk_out1 => clk_out1
    );
end STRUCTURE;
