xvrxvr/fpga-osc/interface.gen/sources_1/ip/dsp_macro_mul_add/dsp_macro_mul_add_sim_netlist.v

// Copyright 1986-2022 Xilinx, Inc. All Rights Reserved.
// Copyright 2022-2024 Advanced Micro Devices, Inc. All Rights Reserved.
// --------------------------------------------------------------------------------
// Tool Version: Vivado v.2023.2.2 (win64) Build 4126759 Thu Feb  8 23:53:51 MST 2024
// Date        : Wed Feb 28 12:46:25 2024
// Host        : DESKTOP-JRU94P5 running 64-bit major release  (build 9200)
// Command     : write_verilog -force -mode funcsim
//               w:/home/roman/FPGA-HAT/fw/interface/interface.gen/sources_1/ip/dsp_macro_mul_add/dsp_macro_mul_add_sim_netlist.v
// Design      : dsp_macro_mul_add
// Purpose     : This verilog netlist is a functional simulation representation of the design and should not be modified
//               or synthesized. This netlist cannot be used for SDF annotated simulation.
// Device      : xc7s6ftgb196-1
// --------------------------------------------------------------------------------
`timescale 1 ps / 1 ps

(* CHECK_LICENSE_TYPE = "dsp_macro_mul_add,dsp_macro_v1_0_5,{}" *) (* downgradeipidentifiedwarnings = "yes" *) (* x_core_info = "dsp_macro_v1_0_5,Vivado 2023.2.2" *) 
(* NotValidForBitStream *)
module dsp_macro_mul_add
   (CLK,
    CE,
    SCLR,
    SEL,
    A,
    B,
    P);
  (* x_interface_info = "xilinx.com:signal:clock:1.0 clk_intf CLK" *) (* x_interface_parameter = "XIL_INTERFACENAME clk_intf, ASSOCIATED_BUSIF p_intf:pcout_intf:carrycascout_intf:carryout_intf:bcout_intf:acout_intf:concat_intf:d_intf:c_intf:b_intf:a_intf:bcin_intf:acin_intf:pcin_intf:carryin_intf:carrycascin_intf:sel_intf, ASSOCIATED_RESET SCLR:SCLRD:SCLRA:SCLRB:SCLRCONCAT:SCLRC:SCLRM:SCLRP:SCLRSEL, ASSOCIATED_CLKEN CE:CED:CED1:CED2:CED3:CEA:CEA1:CEA2:CEA3:CEA4:CEB:CEB1:CEB2:CEB3:CEB4:CECONCAT:CECONCAT3:CECONCAT4:CECONCAT5:CEC:CEC1:CEC2:CEC3:CEC4:CEC5:CEM:CEP:CESEL:CESEL1:CESEL2:CESEL3:CESEL4:CESEL5, FREQ_HZ 100000000, FREQ_TOLERANCE_HZ 0, PHASE 0.0, INSERT_VIP 0" *) input CLK;
  (* x_interface_info = "xilinx.com:signal:clockenable:1.0 ce_intf CE" *) (* x_interface_parameter = "XIL_INTERFACENAME ce_intf, POLARITY ACTIVE_HIGH" *) input CE;
  (* x_interface_info = "xilinx.com:signal:reset:1.0 sclr_intf RST" *) (* x_interface_parameter = "XIL_INTERFACENAME sclr_intf, POLARITY ACTIVE_HIGH, INSERT_VIP 0" *) input SCLR;
  (* x_interface_info = "xilinx.com:signal:data:1.0 sel_intf DATA" *) (* x_interface_parameter = "XIL_INTERFACENAME sel_intf, LAYERED_METADATA undef" *) input [0:0]SEL;
  (* x_interface_info = "xilinx.com:signal:data:1.0 a_intf DATA" *) (* x_interface_parameter = "XIL_INTERFACENAME a_intf, LAYERED_METADATA undef" *) input [10:0]A;
  (* x_interface_info = "xilinx.com:signal:data:1.0 b_intf DATA" *) (* x_interface_parameter = "XIL_INTERFACENAME b_intf, LAYERED_METADATA undef" *) input [15:0]B;
  (* x_interface_info = "xilinx.com:signal:data:1.0 p_intf DATA" *) (* x_interface_parameter = "XIL_INTERFACENAME p_intf, LAYERED_METADATA undef" *) output [47:0]P;

  wire [10:0]A;
  wire [15:0]B;
  wire CE;
  wire CLK;
  wire [47:0]P;
  wire SCLR;
  wire [0:0]SEL;
  wire NLW_U0_CARRYCASCOUT_UNCONNECTED;
  wire NLW_U0_CARRYOUT_UNCONNECTED;
  wire [29:0]NLW_U0_ACOUT_UNCONNECTED;
  wire [17:0]NLW_U0_BCOUT_UNCONNECTED;
  wire [47:0]NLW_U0_PCOUT_UNCONNECTED;

  (* C_A_WIDTH = "11" *) 
  (* C_B_WIDTH = "16" *) 
  (* C_CONCAT_WIDTH = "48" *) 
  (* C_CONSTANT_1 = "1" *) 
  (* C_C_WIDTH = "48" *) 
  (* C_D_WIDTH = "18" *) 
  (* C_HAS_A = "1" *) 
  (* C_HAS_ACIN = "0" *) 
  (* C_HAS_ACOUT = "0" *) 
  (* C_HAS_B = "1" *) 
  (* C_HAS_BCIN = "0" *) 
  (* C_HAS_BCOUT = "0" *) 
  (* C_HAS_C = "0" *) 
  (* C_HAS_CARRYCASCIN = "0" *) 
  (* C_HAS_CARRYCASCOUT = "0" *) 
  (* C_HAS_CARRYIN = "0" *) 
  (* C_HAS_CARRYOUT = "0" *) 
  (* C_HAS_CE = "1" *) 
  (* C_HAS_CEA = "0" *) 
  (* C_HAS_CEB = "0" *) 
  (* C_HAS_CEC = "0" *) 
  (* C_HAS_CECONCAT = "0" *) 
  (* C_HAS_CED = "0" *) 
  (* C_HAS_CEM = "0" *) 
  (* C_HAS_CEP = "0" *) 
  (* C_HAS_CESEL = "0" *) 
  (* C_HAS_CONCAT = "0" *) 
  (* C_HAS_D = "0" *) 
  (* C_HAS_INDEP_CE = "0" *) 
  (* C_HAS_INDEP_SCLR = "0" *) 
  (* C_HAS_PCIN = "0" *) 
  (* C_HAS_PCOUT = "0" *) 
  (* C_HAS_SCLR = "1" *) 
  (* C_HAS_SCLRA = "0" *) 
  (* C_HAS_SCLRB = "0" *) 
  (* C_HAS_SCLRC = "0" *) 
  (* C_HAS_SCLRCONCAT = "0" *) 
  (* C_HAS_SCLRD = "0" *) 
  (* C_HAS_SCLRM = "0" *) 
  (* C_HAS_SCLRP = "0" *) 
  (* C_HAS_SCLRSEL = "0" *) 
  (* C_LATENCY = "-1" *) 
  (* C_MODEL_TYPE = "0" *) 
  (* C_OPMODES = "000000000010010100000000,000100100000010100000000" *) 
  (* C_P_LSB = "0" *) 
  (* C_P_MSB = "47" *) 
  (* C_REG_CONFIG = "00000000000011000111000101100100" *) 
  (* C_SEL_WIDTH = "1" *) 
  (* C_SQUARE_FCN = "0" *) 
  (* C_TEST_CORE = "0" *) 
  (* C_VERBOSITY = "0" *) 
  (* C_XDEVICEFAMILY = "spartan7" *) 
  (* downgradeipidentifiedwarnings = "yes" *) 
  (* is_du_within_envelope = "true" *) 
  dsp_macro_mul_add_dsp_macro_v1_0_5 U0
       (.A(A),
        .ACIN({1'b0,1'b0,1'b0,1'b0,1'b0,1'b0,1'b0,1'b0,1'b0,1'b0,1'b0,1'b0,1'b0,1'b0,1'b0,1'b0,1'b0,1'b0,1'b0,1'b0,1'b0,1'b0,1'b0,1'b0,1'b0,1'b0,1'b0,1'b0,1'b0,1'b0}),
        .ACOUT(NLW_U0_ACOUT_UNCONNECTED[29:0]),
        .B(B),
        .BCIN({1'b0,1'b0,1'b0,1'b0,1'b0,1'b0,1'b0,1'b0,1'b0,1'b0,1'b0,1'b0,1'b0,1'b0,1'b0,1'b0,1'b0,1'b0}),
        .BCOUT(NLW_U0_BCOUT_UNCONNECTED[17:0]),
        .C({1'b0,1'b0,1'b0,1'b0,1'b0,1'b0,1'b0,1'b0,1'b0,1'b0,1'b0,1'b0,1'b0,1'b0,1'b0,1'b0,1'b0,1'b0,1'b0,1'b0,1'b0,1'b0,1'b0,1'b0,1'b0,1'b0,1'b0,1'b0,1'b0,1'b0,1'b0,1'b0,1'b0,1'b0,1'b0,1'b0,1'b0,1'b0,1'b0,1'b0,1'b0,1'b0,1'b0,1'b0,1'b0,1'b0,1'b0,1'b0}),
        .CARRYCASCIN(1'b0),
        .CARRYCASCOUT(NLW_U0_CARRYCASCOUT_UNCONNECTED),
        .CARRYIN(1'b0),
        .CARRYOUT(NLW_U0_CARRYOUT_UNCONNECTED),
        .CE(CE),
        .CEA(1'b1),
        .CEA1(1'b1),
        .CEA2(1'b1),
        .CEA3(1'b1),
        .CEA4(1'b1),
        .CEB(1'b1),
        .CEB1(1'b1),
        .CEB2(1'b1),
        .CEB3(1'b1),
        .CEB4(1'b1),
        .CEC(1'b1),
        .CEC1(1'b1),
        .CEC2(1'b1),
        .CEC3(1'b1),
        .CEC4(1'b1),
        .CEC5(1'b1),
        .CECONCAT(1'b1),
        .CECONCAT3(1'b1),
        .CECONCAT4(1'b1),
        .CECONCAT5(1'b1),
        .CED(1'b1),
        .CED1(1'b1),
        .CED2(1'b1),
        .CED3(1'b1),
        .CEM(1'b1),
        .CEP(1'b1),
        .CESEL(1'b1),
        .CESEL1(1'b1),
        .CESEL2(1'b1),
        .CESEL3(1'b1),
        .CESEL4(1'b1),
        .CESEL5(1'b1),
        .CLK(CLK),
        .CONCAT({1'b0,1'b0,1'b0,1'b0,1'b0,1'b0,1'b0,1'b0,1'b0,1'b0,1'b0,1'b0,1'b0,1'b0,1'b0,1'b0,1'b0,1'b0,1'b0,1'b0,1'b0,1'b0,1'b0,1'b0,1'b0,1'b0,1'b0,1'b0,1'b0,1'b0,1'b0,1'b0,1'b0,1'b0,1'b0,1'b0,1'b0,1'b0,1'b0,1'b0,1'b0,1'b0,1'b0,1'b0,1'b0,1'b0,1'b0,1'b0}),
        .D({1'b0,1'b0,1'b0,1'b0,1'b0,1'b0,1'b0,1'b0,1'b0,1'b0,1'b0,1'b0,1'b0,1'b0,1'b0,1'b0,1'b0,1'b0}),
        .P(P),
        .PCIN({1'b0,1'b0,1'b0,1'b0,1'b0,1'b0,1'b0,1'b0,1'b0,1'b0,1'b0,1'b0,1'b0,1'b0,1'b0,1'b0,1'b0,1'b0,1'b0,1'b0,1'b0,1'b0,1'b0,1'b0,1'b0,1'b0,1'b0,1'b0,1'b0,1'b0,1'b0,1'b0,1'b0,1'b0,1'b0,1'b0,1'b0,1'b0,1'b0,1'b0,1'b0,1'b0,1'b0,1'b0,1'b0,1'b0,1'b0,1'b0}),
        .PCOUT(NLW_U0_PCOUT_UNCONNECTED[47:0]),
        .SCLR(SCLR),
        .SCLRA(1'b0),
        .SCLRB(1'b0),
        .SCLRC(1'b0),
        .SCLRCONCAT(1'b0),
        .SCLRD(1'b0),
        .SCLRM(1'b0),
        .SCLRP(1'b0),
        .SCLRSEL(1'b0),
        .SEL(SEL));
endmodule
`pragma protect begin_protected
`pragma protect version = 1
`pragma protect encrypt_agent = "XILINX"
`pragma protect encrypt_agent_info = "Xilinx Encryption Tool 2023.2.2"
`pragma protect key_keyowner="Synopsys", key_keyname="SNPS-VCS-RSA-2", key_method="rsa"
`pragma protect encoding = (enctype="BASE64", line_length=76, bytes=128)
`pragma protect key_block
agsGjm2IdCdfCeffmuWBXU/adr/trfZAhXkdQBcMVEi6Sa5BmzXDJXlkvpFoSsxfnwfsJ/wLkDqH
t4nG//DauYCpq8w+X2KwkCuJvY3NynWZUSinjYLyLJr+jMJjbYyZ1Bq80SY/oBRZpXvf1RtZltmm
Wle/Nam/GKVfM253IUc=

`pragma protect key_keyowner="Aldec", key_keyname="ALDEC15_001", key_method="rsa"
`pragma protect encoding = (enctype="BASE64", line_length=76, bytes=256)
`pragma protect key_block
PXZ4L4Q3vZwoqlIjLbWdkq2bBIfeejwyY9s2VbVZ/1ZIMNaXf8eA3iBA2CaIxit6zvehoQLLd0L6
9x9YEwHncEwGD3Bll1gAe9yaRP8z2J1KQJlRh9uHAs1QBBovBMIHwHXWgz8CPui1hN1ziqX/ccfh
/3/ug+IGtCTyLhBytHHSAEYOf/4qU/6cKzHdDaIDcs6k1FPG5R3+SLQsQZKEW7LuFvdb1U6wdm3K
EjiTnHXTCuVKxejjjNToC+LmSlGcG1qJELjmRE/vCksc542z5RVOzEW8j6Zv+1A5ieeNmChVT25r
q+5Dm2ydJ/EmivXIFJh6jVjMAXeOYw0XhNcR/g==

`pragma protect key_keyowner="Mentor Graphics Corporation", key_keyname="MGC-VELOCE-RSA", key_method="rsa"
`pragma protect encoding = (enctype="BASE64", line_length=76, bytes=128)
`pragma protect key_block
oaJJqK77aCzpGRDAY6wQzvhaxtP0QeSu88sIQg2GiyNEfYIw9K8L1aLQo5dzwOfkYV/89w71y4OH
z9e7qtEAF4W3a2ynZKETDTZeeiWmqXE7tbfIVjjoALWxwaB7WJMDXNde3efitWl7ojkHDKJ8XZpu
vBLz2BljbRh427ZP5sc=

`pragma protect key_keyowner="Mentor Graphics Corporation", key_keyname="MGC-VERIF-SIM-RSA-2", key_method="rsa"
`pragma protect encoding = (enctype="BASE64", line_length=76, bytes=256)
`pragma protect key_block
c2DTL/fOQNM53/OgnyoZSJ9JQU7pqtlLg6hBIlFzUe3FhxcD3QsQny/a7SnuVBqWXsACVTXz5s5P
sd+mJYCxIJ1COrFnZytBDWB6COoIvLHPIWr8UiGcoCjQJe/q0Jsso/xFpaEHK9+wBUR/xWksQvjz
w4QdMVJwDsSep4mw7qs9A8Xcq+0Qw+A68HVoncKBwChLhc/z42YC2QSg42Bo8RWdGI8Mv9dfKH93
9S4mlXwgCuuh5R6s7M92aeY9D+6eZEEBP7gJEmBFfdRuJbhqiii/2qF/qwpc2LECHvRBCqZ9iHmk
q6FKf1II8plRweRYSX1hlQ9nZ7brRWvuYtARzQ==

`pragma protect key_keyowner="Real Intent", key_keyname="RI-RSA-KEY-1", key_method="rsa"
`pragma protect encoding = (enctype="BASE64", line_length=76, bytes=256)
`pragma protect key_block
gVJ9hBjWRdF+5w/6m9CKqNscBsC0KDB4NHkplpnmLXqoUljCpbKaF0zbK+GvNrs72dOKEFLYacJS
ApUVgavYohnNsMmSgeCUi0DXxeH8x4WLhmJnAumQT+rvdW+4P0foi/p4qpDgC1EelHDi5WEioc7N
9/mA9ic8q+giZCoWKaNibbc4VBNHpjhdNZSjT8Mjezrpd3XTxsT6RpPbJH1fv0CYpwOdjM6vqu6Z
lWFoMuCHo0bjQ1xmzYHf9+bPouRpzS4QAdlXRFAKIlGvaN8yznul3ZoHWvwDwgfA0yOANektCfY+
z2Wm1iFsgwxmfnH33Vd7304va+D4CMqybL664g==

`pragma protect key_keyowner="Xilinx", key_keyname="xilinxt_2022_10", key_method="rsa"
`pragma protect encoding = (enctype="BASE64", line_length=76, bytes=256)
`pragma protect key_block
dNFjSJ+pQ79GN7CpOM24QWmaMs1JvQfwLdClbjrpt9Je2DzReow+zP1dY9KBbxn2amHKV4Ah9ZWv
xDdaaazD80gf2TIptiAppVXkA03TZrfdGyDVZQqdYnIXbEnmK8zz59EEwO80Oart986/WyCpL/wC
2FMuRBQqbLLLQiDQfnPKdKMUDy4yyuMhn0uC3HP7L1oQajItcis/bXuCE+j9LJZ1QxyDizG2rWax
NEev5OZuXqBVW+dK7XP4JRn0EnkP3H0kvkHWsxRVOPgUeVgT6mj1DAmATBv4+VrFn+8Zw0Hob7YM
7rfr7lIFMB2tBG4QKSfIiG3IvgEFhcVdVGkQYg==

`pragma protect key_keyowner="Metrics Technologies Inc.", key_keyname="DSim", key_method="rsa"
`pragma protect encoding = (enctype="BASE64", line_length=76, bytes=256)
`pragma protect key_block
NckIg6il1+wtOs9NTulaalRO/n7UseapUVUfy6tCsAgSh0Oxr+yBbwDL1lnjevvsIjv7HemvPbbb
79p/vlLnqbLqdeLebUR0L6XxLi3zX7jQxZ19igCkin0brwYdLnYXumpBewzOxkuiww18VdxKBa1q
WlWf0G5goUgP0oVlnL4pfO+BVj7LYC2SvRkrS8VFtPU794+WEvwtg/I7yaA+NCiOVeH79td/ARyv
j6oGOxNZrfBcGN+Y1ya+YHNOMGmePWwc4g2MX3Aypp57+iXR0R1MrxgWxRaMNnBYhUFxh5z6Aj9e
fMRjbMZe+YiuHrEBs+kAYB4s4G8EV2VAnLplWQ==

`pragma protect key_keyowner="Atrenta", key_keyname="ATR-SG-RSA-1", key_method="rsa"
`pragma protect encoding = (enctype="BASE64", line_length=76, bytes=384)
`pragma protect key_block
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

`pragma protect key_keyowner="Cadence Design Systems.", key_keyname="CDS_RSA_KEY_VER_1", key_method="rsa"
`pragma protect encoding = (enctype="BASE64", line_length=76, bytes=256)
`pragma protect key_block
Dr5WovxVHTbKmkcwMxFozPSnv2J4w7sen4PtQgRnovNgb40b5DG+Jg5s5Lpf/dpWkKzS6SQM0kmt
z7O2vdpmSqfJX0HcYmzUZwpFAnZEThwVSax22VJj3l5+a9FANIAtrQqAzNAXV3fTf/KmxZxag2a6
ExqnQ1NIqEGrHIj+Cr6eTIXM8jioboVguess7XDOKEHBUXGV8GzOkV+zSR3HtLvOPpcaIn4taC5n
GwJywPNKenz+ZCnylj45Yqe7AUG60a8LgWbm6F8f1Sinz1E/S2MuQlti+paEJaA9bYj1GVUvDB0o
rRBNh4MLp49Uyu58xqH9kyH+MAGKnCA1j42PcA==

`pragma protect data_method = "AES128-CBC"
`pragma protect encoding = (enctype = "BASE64", line_length = 76, bytes = 10992)
`pragma protect data_block
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
`pragma protect end_protected
`pragma protect begin_protected
`pragma protect version = 1
`pragma protect encrypt_agent = "XILINX"
`pragma protect encrypt_agent_info = "Xilinx Encryption Tool 2023.2.2"
`pragma protect key_keyowner="Synopsys", key_keyname="SNPS-VCS-RSA-2", key_method="rsa"
`pragma protect encoding = (enctype="BASE64", line_length=76, bytes=128)
`pragma protect key_block
agsGjm2IdCdfCeffmuWBXU/adr/trfZAhXkdQBcMVEi6Sa5BmzXDJXlkvpFoSsxfnwfsJ/wLkDqH
t4nG//DauYCpq8w+X2KwkCuJvY3NynWZUSinjYLyLJr+jMJjbYyZ1Bq80SY/oBRZpXvf1RtZltmm
Wle/Nam/GKVfM253IUc=

`pragma protect key_keyowner="Aldec", key_keyname="ALDEC15_001", key_method="rsa"
`pragma protect encoding = (enctype="BASE64", line_length=76, bytes=256)
`pragma protect key_block
PXZ4L4Q3vZwoqlIjLbWdkq2bBIfeejwyY9s2VbVZ/1ZIMNaXf8eA3iBA2CaIxit6zvehoQLLd0L6
9x9YEwHncEwGD3Bll1gAe9yaRP8z2J1KQJlRh9uHAs1QBBovBMIHwHXWgz8CPui1hN1ziqX/ccfh
/3/ug+IGtCTyLhBytHHSAEYOf/4qU/6cKzHdDaIDcs6k1FPG5R3+SLQsQZKEW7LuFvdb1U6wdm3K
EjiTnHXTCuVKxejjjNToC+LmSlGcG1qJELjmRE/vCksc542z5RVOzEW8j6Zv+1A5ieeNmChVT25r
q+5Dm2ydJ/EmivXIFJh6jVjMAXeOYw0XhNcR/g==

`pragma protect key_keyowner="Mentor Graphics Corporation", key_keyname="MGC-VELOCE-RSA", key_method="rsa"
`pragma protect encoding = (enctype="BASE64", line_length=76, bytes=128)
`pragma protect key_block
oaJJqK77aCzpGRDAY6wQzvhaxtP0QeSu88sIQg2GiyNEfYIw9K8L1aLQo5dzwOfkYV/89w71y4OH
z9e7qtEAF4W3a2ynZKETDTZeeiWmqXE7tbfIVjjoALWxwaB7WJMDXNde3efitWl7ojkHDKJ8XZpu
vBLz2BljbRh427ZP5sc=

`pragma protect key_keyowner="Mentor Graphics Corporation", key_keyname="MGC-VERIF-SIM-RSA-2", key_method="rsa"
`pragma protect encoding = (enctype="BASE64", line_length=76, bytes=256)
`pragma protect key_block
c2DTL/fOQNM53/OgnyoZSJ9JQU7pqtlLg6hBIlFzUe3FhxcD3QsQny/a7SnuVBqWXsACVTXz5s5P
sd+mJYCxIJ1COrFnZytBDWB6COoIvLHPIWr8UiGcoCjQJe/q0Jsso/xFpaEHK9+wBUR/xWksQvjz
w4QdMVJwDsSep4mw7qs9A8Xcq+0Qw+A68HVoncKBwChLhc/z42YC2QSg42Bo8RWdGI8Mv9dfKH93
9S4mlXwgCuuh5R6s7M92aeY9D+6eZEEBP7gJEmBFfdRuJbhqiii/2qF/qwpc2LECHvRBCqZ9iHmk
q6FKf1II8plRweRYSX1hlQ9nZ7brRWvuYtARzQ==

`pragma protect key_keyowner="Real Intent", key_keyname="RI-RSA-KEY-1", key_method="rsa"
`pragma protect encoding = (enctype="BASE64", line_length=76, bytes=256)
`pragma protect key_block
gVJ9hBjWRdF+5w/6m9CKqNscBsC0KDB4NHkplpnmLXqoUljCpbKaF0zbK+GvNrs72dOKEFLYacJS
ApUVgavYohnNsMmSgeCUi0DXxeH8x4WLhmJnAumQT+rvdW+4P0foi/p4qpDgC1EelHDi5WEioc7N
9/mA9ic8q+giZCoWKaNibbc4VBNHpjhdNZSjT8Mjezrpd3XTxsT6RpPbJH1fv0CYpwOdjM6vqu6Z
lWFoMuCHo0bjQ1xmzYHf9+bPouRpzS4QAdlXRFAKIlGvaN8yznul3ZoHWvwDwgfA0yOANektCfY+
z2Wm1iFsgwxmfnH33Vd7304va+D4CMqybL664g==

`pragma protect key_keyowner="Xilinx", key_keyname="xilinxt_2022_10", key_method="rsa"
`pragma protect encoding = (enctype="BASE64", line_length=76, bytes=256)
`pragma protect key_block
dNFjSJ+pQ79GN7CpOM24QWmaMs1JvQfwLdClbjrpt9Je2DzReow+zP1dY9KBbxn2amHKV4Ah9ZWv
xDdaaazD80gf2TIptiAppVXkA03TZrfdGyDVZQqdYnIXbEnmK8zz59EEwO80Oart986/WyCpL/wC
2FMuRBQqbLLLQiDQfnPKdKMUDy4yyuMhn0uC3HP7L1oQajItcis/bXuCE+j9LJZ1QxyDizG2rWax
NEev5OZuXqBVW+dK7XP4JRn0EnkP3H0kvkHWsxRVOPgUeVgT6mj1DAmATBv4+VrFn+8Zw0Hob7YM
7rfr7lIFMB2tBG4QKSfIiG3IvgEFhcVdVGkQYg==

`pragma protect key_keyowner="Metrics Technologies Inc.", key_keyname="DSim", key_method="rsa"
`pragma protect encoding = (enctype="BASE64", line_length=76, bytes=256)
`pragma protect key_block
NckIg6il1+wtOs9NTulaalRO/n7UseapUVUfy6tCsAgSh0Oxr+yBbwDL1lnjevvsIjv7HemvPbbb
79p/vlLnqbLqdeLebUR0L6XxLi3zX7jQxZ19igCkin0brwYdLnYXumpBewzOxkuiww18VdxKBa1q
WlWf0G5goUgP0oVlnL4pfO+BVj7LYC2SvRkrS8VFtPU794+WEvwtg/I7yaA+NCiOVeH79td/ARyv
j6oGOxNZrfBcGN+Y1ya+YHNOMGmePWwc4g2MX3Aypp57+iXR0R1MrxgWxRaMNnBYhUFxh5z6Aj9e
fMRjbMZe+YiuHrEBs+kAYB4s4G8EV2VAnLplWQ==

`pragma protect key_keyowner="Atrenta", key_keyname="ATR-SG-RSA-1", key_method="rsa"
`pragma protect encoding = (enctype="BASE64", line_length=76, bytes=384)
`pragma protect key_block
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

`pragma protect key_keyowner="Cadence Design Systems.", key_keyname="CDS_RSA_KEY_VER_1", key_method="rsa"
`pragma protect encoding = (enctype="BASE64", line_length=76, bytes=256)
`pragma protect key_block
Dr5WovxVHTbKmkcwMxFozPSnv2J4w7sen4PtQgRnovNgb40b5DG+Jg5s5Lpf/dpWkKzS6SQM0kmt
z7O2vdpmSqfJX0HcYmzUZwpFAnZEThwVSax22VJj3l5+a9FANIAtrQqAzNAXV3fTf/KmxZxag2a6
ExqnQ1NIqEGrHIj+Cr6eTIXM8jioboVguess7XDOKEHBUXGV8GzOkV+zSR3HtLvOPpcaIn4taC5n
GwJywPNKenz+ZCnylj45Yqe7AUG60a8LgWbm6F8f1Sinz1E/S2MuQlti+paEJaA9bYj1GVUvDB0o
rRBNh4MLp49Uyu58xqH9kyH+MAGKnCA1j42PcA==

`pragma protect key_keyowner="Mentor Graphics Corporation", key_keyname="MGC-PREC-RSA", key_method="rsa"
`pragma protect encoding = (enctype="BASE64", line_length=76, bytes=256)
`pragma protect key_block
CzioUQNNy1wV+QFEXiUmVKVZoPEGw5OODXWlofubTLO0HFQPr29G3YD2Rxf5R9/poTq8JtPaKLL8
zgK0Z3izJ7sGpilrX8fDJnO1Q7KEWoyQDwrBF0R11wXp8AKC56llcH4BxKGOdtmWrGAn146BvLR8
2ZV5iQLfZ5z2X35hAsTgMAd8YKk9ExcfmRUj6RS7GC7HKcbWiv1ERMvU1LJzxHy3Tc3vkJRhmmpb
j8UDCPr9fVMiLEuFGUjxMtq3nGNByDz/Qo97NmYdbZa6Cyh4nkuKnEumpy2NA5mhmzEMDQvyw20N
nh7TqVx4NdfKREcyKzr4qspvzUgvC6u1JfYM8Q==

`pragma protect key_keyowner="Synplicity", key_keyname="SYNP15_1", key_method="rsa"
`pragma protect encoding = (enctype="BASE64", line_length=76, bytes=256)
`pragma protect key_block
Gi96aOy461/FWyTMAf3zf6THJYrQqJQw6PeR5kfOKvURIHs38JvKa6ZlWl/0gKM3qSM5/oyVzt4r
nZIIxT37vf+1erB5hzkUiGPMMjhVSeO8q87NERwQOmEEEApTXgbD0YOer23/sEgjaC5SR+MoB872
DaN7kDQBbqNLy8SvUrEsw+l5km6qMj68IUBWOgUCtU4vq/AQUvNCeNjmAedZGXj4G3n6mC/CHhL2
ZF1Bb+fgBaNI1Cj0djpfV+5YYIHJr7e/yw46e/Q17lioio/42X3i28zXk1EPIdHnDkZV99PtWzi4
FvmLuCkmrTrvkB/PHzM5U8iNGIWxuPg5ne9TnA==

`pragma protect data_method = "AES128-CBC"
`pragma protect encoding = (enctype = "BASE64", line_length = 76, bytes = 38192)
`pragma protect data_block
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
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
