xvrxvr/fpga-osc/(commit log)

2024-05-26 Change protocol for SPI interface
2024-05-29 SPI fpga to host protocol changed to ESC words
2024-05-30 Fix for posible data loss in FPGA->Host channel between Frames
    [spi_interface.sv]
2024-05-30 Introduce 8 bit SPI mode for FPGA channel status request
2024-05-31 Update SPI FIFO Stat module
2024-05-31 SPI Stat auto sender started
2024-06-01 Add support for ESC in HOST->FPGA SPI channel
2024-06-01 Fix FIFO Empty counter (was FIFO full really)
    [spi_interf_pkg.sv, spi_interface.sv, top.sv]
