xvrxvr/fpga-osc/(notices)

Notices in the files:
interface.gen/sources_1/ip/axis_interconnect_output/hdl/axis_interconnect_v1_1_vl_rfs.v:
(c) Copyright 2012, 2023 Advanced Micro Devices, Inc. All rights reserved.
(c) Copyright 2010-2012, 2023 Advanced Micro Devices, Inc. All rights reserved.
